xiaomiao321/taideng/Linux/robot-sdk-source-0.3.0-complete/robot-sdk-source-0.3.0/source-sample-project/APP开发者教程_源码.md

# 面向 App 开发者的 Robot SDK 0.3.0 教程：源码接入

适用：已有或新建机器人端 Android App，希望直接引用可编辑SDK模块并完成自己的页面。学习路线：接入module → 运行自己的最小坐姿页 → 接语音/双摄/MCU → 对接你方服务器与蓝牙 → 联调验收。本文可随源码交付包独立阅读，不要求先看AAR版教程。

## 1. 先跑参考示例，再接自己的 App

解压本包 `robot-sdk-source-sample-0.3.0-project.zip`，运行 `.\gradlew.bat :robot-sdk:testDebugUnitTest :sample:assembleDebug`。这是实际编译SDK的源码工程，不是只带AAR的App源码。完整环境和板卡连接见本包 [SDK源码接入指南.md](SDK源码接入指南.md)。

本交付工程配置JDK25、AGP9.3.1、Gradle9.5.0、compileSdk37、minSdk29、targetSdk30、arm64-v8a；需NDK27.2.12479018、CMake3.22.1。AGP9工程自带Kotlin支持；现有工程使用其他AGP/Kotlin时先核对兼容性，不盲目同时添加两种Kotlin插件。正式App的targetSdk/签名/发布政策由你方决定，示例不是商店发布配置。

将交付工程中的整个 `robot-sdk/` 复制到你方工程根目录，保留模块build.gradle、consumer-rules、src/main/java、assets、cpp、Runtime和libs。不要只复制Kotlin类，不要把模型/JNI路径改回原验证工程app/。sherpa供应方实现仍为第三方AAR，本包不包含它的实现源码。

## 2. 设置源码依赖并先解决编译问题

项目 `settings.gradle.kts` 的依赖仓库和模块声明合并：

```kotlin
dependencyResolutionManagement {
    repositories {
        google()
        mavenCentral()
        maven(url = "https://jitpack.io")
    }
}
include(":robot-sdk", ":app")
```

项目需声明Android library插件，与现有application插件版本一致；本交付模板为：

```kotlin
plugins {
    id("com.android.application") version "9.3.1" apply false
    id("com.android.library") version "9.3.1" apply false
}
```

宿主 `app/build.gradle.kts` 合并：

```kotlin
android {
    compileSdk = 37
    defaultConfig {
        minSdk = 29
        ndk { abiFilters += "arm64-v8a" }
    }
}
dependencies {
    implementation(project(":robot-sdk"))
    implementation(files("../robot-sdk/libs/sherpa-onnx-v1.13.6-arm64-rknn-no-runtime.aar"))
    implementation("androidx.core:core-ktx:1.10.1")
    implementation("com.github.mik3y:usb-serial-for-android:3.11.0")
}
```

SDK的sherpa依赖是compileOnly，宿主仍需显式runtime依赖。不要同时implementation Robot SDK AAR，否则重复类；不要重命名JNI类、丢consumer规则或另带不同Runtime。调用路径应该指向实际可编辑模块，不用每改一行SDK都手工导出AAR。

先 `.\gradlew.bat :robot-sdk:testDebugUnitTest :app:assembleDebug`。日常UI/业务开发只调用公共门面，不直接操作NV12、模型引擎或串口帧。确需修改SDK时保持硬件/业务分层，并重新运行SDK测试、R8与板卡验收。

## 3. 开发分工：先把硬件当作本地服务

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

SDK 相机接口须在主线程调用，结果和状态回调也在主线程。文件、数据库、蓝牙和网络写入放后台；SDK 已做采集/推理后台处理，不要为了“异步”把相机 start/stop 搬到后台线程。

## 4. 第一个里程碑：自己的 App 显示坐姿

先只接坐姿，不接串口、蓝牙或付费搜题。下面是完整的最小 Activity：人工选择相机、预览、结构化结论、过期检测、授权及前后台释放。它无需额外 layout XML。

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

```kotlin
package com.example.robotapp

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

    private val refreshResult = object : Runnable {
        override fun run() {
            if (!foreground) return
            renderResult()
            main.postDelayed(this, 500)
        }
    }

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

    private fun hasCameraPermission() =
        checkSelfPermission(Manifest.permission.CAMERA) == PackageManager.PERMISSION_GRANTED

    private fun askCameraPermission() {
        askedPermission = true
        requestPermissions(arrayOf(Manifest.permission.CAMERA), 1001)
    }

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

    override fun onPause() {
        foreground = false
        main.removeCallbacksAndMessages(null)
        posture?.stop()
        resultText.text = "页面暂停，没有实时结论"
        super.onPause()
    }

    override fun onDestroy() {
        posture?.close()
        posture = null
        previewHost.removeAllViews()
        super.onDestroy()
    }

    private fun dp(value: Int) = (value * resources.displayMetrics.density).toInt()
}
```

宿主 manifest 注册页面；你方只有一个入口时可把下面 Activity 设为启动入口，不要同时保留两个未规划的 LAUNCHER：

```xml
<activity
    android:name="com.example.robotapp.PostureDemoActivity"
    android:exported="true">
    <intent-filter>
        <action android:name="android.intent.action.MAIN" />
        <category android:name="android.intent.category.LAUNCHER" />
    </intent-filter>
</activity>
```

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

## 5. 坐姿页面升级：分开显示状态与结果

相机状态、模型状态、业务结论应使用独立 UiState/控件，避免某个 LoadingModel/Running 回调覆盖坐姿结论。最小页面把硬件消息集中在一个 TextView，正式产品可进一步拆分。

业务主入口是 `onBusinessResult` 或 `subscribeBusiness`；不要为同一份数据重复订阅两次保存。其他组件订阅时：

```kotlin
val subscription = postureClient.subscribeBusiness { result ->
    val json = result.toJson()
    // 只更新UI/投递后台队列；不在这里同步写数据库或蓝牙。
}
// 组件销毁时取消；不要积累旧页面监听器。
subscription.close()
```

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

## 6. 加入常开 USB 语音：临时文字和最终语句分两条链路

先申请 RECORD_AUDIO，再启用已加载的模型。下面的字段和初始化逻辑加入你的页面所有者；`partialText/finalText/audioStateText` 是你方 TextView：

```kotlin
import com.example.rk3566hardwarevalidator.hardware.speech.*

private var speech: StreamingSpeechRecognizer? = null
private var speechReady = false

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

private fun maybeStartSpeech() {
    val granted = checkSelfPermission(Manifest.permission.RECORD_AUDIO) ==
        PackageManager.PERMISSION_GRANTED
    val client = speech ?: return
    if (foreground && speechReady && granted && !client.isRecording) client.start()
}
```

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

临时文字持续覆盖一个“正在说话”区域；最终片段才加入对话/记录列表。不要对临时文字直接下发电机动作，不要把所有最终语句自动当作用户授权。录音止停后不应沿用旧的“监听中”标志；回前台也不自动恢复上一条运动。

## 7. 两颗摄像头：设置页确认角色，拍题页拿自己的画面

用同一 CameraRoleRegistry 管理两个角色。先停止/释放受影响 client，再真正重新枚举与 refresh，随后让用户核对取景并 bind。正常页面刷新数据不能每秒调用 registry.refresh，它会清除人工会话绑定。

```kotlin
val questionBinding = registry.bind(CameraRole.QUESTION, userConfirmedQuestionId)
val postureBinding = registry.resolve(CameraRole.POSTURE)
val usable = questionBinding.status == CameraRoleStatus.BOUND ||
    questionBinding.status == CameraRoleStatus.SESSION_BOUND
if (usable && questionBinding.cameraId != postureBinding.cameraId) {
    val question = QuestionCameraClient(
        context = this,
        config = CameraSessionConfig(
            cameraId = questionBinding.cameraId,
            analysisEnabled = false
        ),
        onEvent = { event -> /* 更新拍题相机状态；断开后停用并重新确认 */ }
    )
    questionPreviewHost.addView(question.previewView)
    // 由所有者保存question；CAMERA授权且页面/功能前台后：
    question.start()
}
```

上段 `registry` 是管理两角色的同一实例；`userConfirmedQuestionId` 必须来自当前枚举。只有一颗相机时，这个教程不同时启用坐姿和拍题；可在测试设置中先解绑坐姿，再人工改绑拍题验证截图，不能声称验证了双路并发。

Camera2 ID、VID/PID、相同能力指纹不是跨重启物理身份。默认每次冷启动/重新枚举重新确认；想自动匹配需板厂/宿主实现并验证 CameraIdentityProvider，配 SharedPreferencesCameraRoleBindingStore 保存可靠 stableKey。两相机缺身份时不能靠猜测保证不反。

等 PreviewStarted 或 isPreviewActive 后再允许拍照：

```kotlin
import com.example.rk3566hardwarevalidator.hardware.photo.PhotoCropRegion

captureButton.setOnClickListener {
    if (!question.isPreviewActive) {
        photoMessage.text = "拍题镜头尚未就绪"
        return@setOnClickListener
    }
    captureButton.isEnabled = false
    question.capturePhoto(PhotoCropRegion.FULL_FRAME) { outcome ->
        captureButton.isEnabled = true
        outcome.onSuccess { jpeg ->
            // 后台保存/显示/上传；JPEG未叠加骨架或取题框。
        }.onFailure { error ->
            photoMessage.text = "拍照失败：" + error.message
            // 不展示上一次照片为“本次拍照成功”。
        }
    }
}
```

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

`captureAnnotatedBitmap` 只供坐姿诊断，可能不是同一推理帧，不能作为搜题上传照片。Bitmap 更新展示或页面销毁时按所有权释放，勿把同一 Bitmap 回收后继续给 ImageView 用。

## 8. 搜题服务器：先展示截图，再由用户提交

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

```kotlin
import com.example.rk3566hardwarevalidator.hardware.photo.*

val search = PhotoSearchClient(this) { state ->
    when (state) {
        PhotoSearchState.Idle -> { /* 清理忙碌状态 */ }
        is PhotoSearchState.Uploading -> { /* 显示上传中 */ }
        PhotoSearchState.Solving -> { /* 显示等待服务器 */ }
        is PhotoSearchState.Success -> {
            val answer = state.solution.answer
            val steps = state.solution.steps
            // 将题目、答案、步骤和warning映射至App页面。
        }
        is PhotoSearchState.Error -> { /* 显示state.message，允许重新提交 */ }
    }
}
// readyJpegFile是App已在后台写好的非空JPEG文件。
// serverEndpoint是你方配置的服务地址，并非模型厂商带key的URL。
// 只在用户明确点击提交后调用；false表示忙碌或已关闭。
submitPhotoButton.setOnClickListener {
    val accepted = search.solve(readyJpegFile, serverEndpoint)
    if (!accepted) { /* 不重复显示为已上传 */ }
}
```

离开当前拍题流程调用 cancel，最终所有者销毁调用 close。取消不保证已发生的服务器请求或计费撤销。把 JPEG 写文件放后台，并用 App 的页面会话/请求代次阻止离开页面后的旧文件任务触发新上传；onResume不能自动重传旧题。

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

```json
{"success":true,"question":"题目正文","answer":"答案","steps":["步骤一"],"knowledge_points":["知识点"],"warning":""}
```

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

## 9. MCU 页面：先显示真实状态，再提交操作

导入 com.example.rk3566hardwarevalidator.hardware.mcu.*。以下初始化在页面所有者中只执行一次，TextView/按钮是 App 自己的控件。默认 LEGACY_V2 不开放模式/关节等扩展：

```kotlin
import com.example.rk3566hardwarevalidator.hardware.mcu.*

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

fun maySubmitNormalCommand() = mcuConnected && pendingCommandIds.isEmpty() &&
    !mcu.isStatusStale() && latestFaultFlags == 0

fun remember(submission: McuCommandSubmission) {
    if (submission.accepted) pendingCommandIds.add(submission.commandId)
    else commandLabel.text = "未受理：${submission.outcome}"
}
applyLightButton.setOnClickListener {
    if (!maySubmitNormalCommand()) {
        commandLabel.text = "未连接/处理中/状态过期或故障，不能提交"
        return@setOnClickListener
    }
    remember(mcu.setLight(true, brightnessSlider.progress))
}
offButton.setOnClickListener {
    if (maySubmitNormalCommand()) remember(mcu.setLight(false, 0))
}
stopButton.isEnabled = true
stopButton.setOnClickListener { remember(mcu.stopMotion()) }
refreshSerialButton.setOnClickListener { mcu.refreshDevices() }
```

上段是接线片段，正式页面必须补充控制门控：普通控件要求已连接、没有冲突的待完成命令、状态未过期且faultFlags=0；不能在点亮按钮时立即把实际亮度改成目标。回读设置开关/滑条时用 applyingActualStatus 阻止监听器再次发控制命令；亮度拖动结束或经节流后才提交，不每个像素都写串口。

片段已在提交入口检查门控；正式UI还应定时按同样条件刷新按钮可用状态。灯光关闭是否作为故障下的特例须按双方安全合同设计，不能因本例普通按钮被禁用就阻塞STOP。

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

accepted是SDK受理；ACK_RECEIVED只是MCU接收；APPLIED要求新的关联、无故障、匹配目标的实际状态。即使APPLIED，也不是独立传感器认证。App按 commandId 关联控件/操作，别只用8位sequence当长期身份；TIMEOUT/STATE_TIMEOUT/STALE_STATUS等都要显示并停止等待，禁止UI猜成功。

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

PC Host与板卡 Host不能用普通一根USB线直接模拟串口对端。协议模拟需USB转TTL/匹配电平的UART或CDC Device；注意TX/RX/GND与TTL/RS232不可混用，按硬件设计确认。mcu-tools是软件模拟夹具，不能代替真实固件安全验收。

## 10. 蓝牙只做数据交接：传输层属于你方 App

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

你方可定义异步队列接口，例如：

```kotlin
interface RobotDataSink {
    // 约定此方法只入有界队列，不同步阻塞SDK回调。
    fun enqueue(type: String, payload: String)
}
val subscription = postureClient.subscribeBusiness { result ->
    sink.enqueue("POSTURE", result.toJson())
}
// 在onFinalTranscript中：sink.enqueue("SPEECH_FINAL", result.toJson())
// 销毁订阅所有者：subscription.close()
```

传输层另定设备/会话身份、schema兼容、发送频率、MTU分包、消息ID、校验、断线缓存、重传和隐私授权。持续坐姿数据可做采样/状态变化聚合，不无限积累每帧；语音最终片段与临时文字分开。App自己的学生/任务ID不要塞进SDK硬件层。

手机控制消息必须先完成鉴权、用户意图和动作白名单校验，再调用mcu操作并回传commandId关联结果；不能接到一个未经校验的蓝牙包就透传运动字节。

## 11. 页面生命周期检查表

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

最小Activity采用“页面不可见即停止”的策略。若正式产品要常驻后台/跨页面长期采集，需要你方另行设计平台服务、权限与单一资源所有权并验收，不直接删掉所有stop/close。

## 12. App开发者的验收顺序与排错

按里程碑交付，避免把所有硬件/云端故障混在一起：

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

无线ADB配对/连接端口不同，重启可能变；使用板卡当前值，不把文档中的历史IP当固定配置：

```powershell
$device = '板卡IP:当前连接端口'
adb connect $device
adb devices -l
adb -s $device install -r '自己的APK路径'
adb -s $device logcat -d -s AndroidRuntime:E CameraService:E Camera3-Device:E McuSerial:I StreamingSpeech:I
```

APK安装不是固件烧写；屏幕/系统镜像遵循板厂SOP。本SDK目标RK3566/Android11/arm64，不承诺别的SoC/HAL/Android或16KB页面环境开箱即用。

## 13. 交给双方联调前填写的信息

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

交付SampleActivity是可运行参考，不是你方产品UI。关键路径索引：

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

本教程新增的是接入教学，不变更SDK/API/APK版本。只有一路摄像头的板卡测试不能证明双路并发；编译通过也不能代替真人坐姿/语音准确率和真实MCU实物验收。
