xiaomiao321/taideng/Linux/robot-sdk-aar-0.3.0-complete/robot-sdk-aar-0.3.0/aar-sample-project/APP团队首轮交付说明_0.3.0.md

# App团队首轮集成交付说明：Robot SDK 0.3.0

交付资料修订：2026-10-03 D1。SDK和两款示例版本均为0.3.0，示例versionCode=3；主验证App源码版本为1.3.1。本文用于首轮集成、分工和验收讨论，资料更新不改变二进制版本。

已确认：先按原生Android准备；我方将提供同款RK3566板卡、摄像头和USB麦克风。团队最终语言、摄像头数量/型号、MCU配置与产品后台运行策略需在收件时确认。

## 1. 首轮目标

App团队在自己的机器人端APK中引用SDK，在交付板卡上完成预览、坐姿数据展示、USB语音数据展示、权限及前后台生命周期。双方用同一套实际状态和错误语义联调；后续产品页面、蓝牙/服务器业务和新增硬件沿用这条接口边界。

SDK为本地Android Library，由你方最终APK运行。我方负责采集/模型/串口协议与接口问题；你方负责正式页面、交互、权限流程、身份/历史记录、数据传输及服务端业务。家长端手机App通过你方蓝牙/网络链路接收数据，不直接运行RK3566 SDK。

## 2. 收到后先看哪些文件

1. 本交付说明：确认范围、硬件条件和首轮验收。
2. 本包APP开发者教程：按依赖→自己的最小坐姿Activity→语音→拍题/MCU的顺序开发。
3. 本包SDK接入指南：查依赖、公共接口、权限、无线ADB和安装细节。
4. SDK数据与蓝牙对接.md：落实字段、时间戳、有效期与传输责任。
5. SDK0.3.0验证记录.md：了解已实际检查的内容；硬件控制另读两份MCU协议。

| 接入方式 | 交付目录 | 主要文件 | 教程 |
| --- | --- | --- | --- |
| 二进制AAR | robot-sdk-aar-0.3.0 | robot-sdk-0.3.0.aar、sherpa依赖AAR、示例APK、aar-sample-project及工程ZIP | APP开发者教程_AAR.md |
| 可编辑SDK源码 | robot-sdk-source-0.3.0 | source-sample-project内SDK/模型/JNI/Runtime、sherpa依赖AAR、源码示例APK及工程ZIP | APP开发者教程_源码.md |

两种方式使用同一组SDK接口。建议首次集成从AAR与参考示例开始；选择源码接入的团队也可直接运行源码示例。自己的APK只选一种Robot SDK依赖方式，sherpa语音AAR仍为必需的第三方依赖。源码方式的第三方sherpa实现源码不包含在本次交付中。

每包SHA256.txt覆盖目录内交付文件。示例APK用于验证；安装自己的APK后，注意包名、版本和相机/麦克风资源所有者。测试时只把一款相关App置于前台。

## 3. 能力范围与当前验证程度

| 能力 | 首轮提供 | 已有证据 / 联调条件 |
| --- | --- | --- |
| 坐姿相机与数据 | 指定相机、实时预览、关键点、坐姿业务快照、动态阈值、状态/错误 | 单摄实机预览/结果刷新及相机重试已检查；真人准确率、安装角度和阈值需现场标定 |
| 坐姿结论 | 高低肩、低头、疑似驼背；逐项可判定性和连续异常时长 | 无人/不可判定不会作为正常；识别效果不以编译/模型初始化代替验收 |
| USB语音 | 输入/电平/模型状态、临时文字和最终语句、JSON | USB输入和模型初始化已检查；实际终句、噪声和准确率需按现场语料验收 |
| 拍题相机 | 独立预览、未标注JPEG、相对预览区域裁剪 | 单相机改绑拍题后的截图已检查；独立双摄并发需两路硬件/HAL验证 |
| 搜题服务调用 | 可选PhotoSearchClient上传/结果/取消接口 | 两款SDK示例只做本地截图；正式服务器、鉴权、网络和照片留存由App/服务端团队对接 |
| MCU基础控制 | 灯光开关/亮度、宏观运动/STOP、状态查询与追踪 | 协议和模拟测试已准备；真实固件、USB-UART及机构状态回读需共同联调 |
| MCU扩展 | 模式、关节位置/HOME、灯路、蜂鸣器、指示灯、软关机接口与规范 | 默认关闭；提供经验证的固件能力描述后启用，仍需真实动作验收 |
| 双摄身份 | 角色注册、冲突/缺失状态、可靠身份provider扩展点 | 默认人工确认；相同型号无可靠身份时不能自动保证跨重启匹配 |
| 蓝牙 | 可消费的数据对象/JSON和本地操作接口 | App团队实现蓝牙连接、分包、授权、同步和设备绑定 |

RK3566姿态与语音共享单核NPU；预处理、UI、录音等仍占用CPU。正式两摄+语音并发负载和长时间稳定性需要在最终配置上测量。

Wi-Fi设置、OTA、账号/学生/任务、历史统计与正式业务UI由App团队提供；主验证App中已有相关参考实现。SDK示例以能力接入为主，正式App可重新设计页面。

## 4. 硬件与构建基线

运行目标：RK3566、Android11/API30、arm64-v8a；已验证组合为RKNN Runtime2.3.2、板载RKNPU驱动0.8.8。最后一次记录的板卡显示为600×1024竖屏。供给App团队的固件、显示配置和外设应与双方确认的实机一致。

示例构建配置：JDK25、AGP9.3.1、Gradle9.5.0、compileSdk37、minSdk29、targetSdk30。源码接入另需NDK27.2.12479018、CMake3.22.1。示例build环境不要求你方盲目重构已有工程；收到你方AGP/Kotlin/界面技术栈后核对兼容性。

随板卡交接时共同记录：

| 项目 | 收件时填写 |
| --- | --- |
| 板卡型号、Android固件版本/构建号 | 待记录 |
| 显示尺寸、旋转和触摸配置 | 待记录 |
| 摄像头数量、型号、坐姿/拍题用途及安装方向 | 待记录；单摄验证与双摄并发分开登记 |
| USB麦克风/音响型号与输入输出端点 | 待记录；音响是否提供另确认 |
| USB-UART型号、MCU固件版本与能力描述 | 若首轮提供MCU则填写，否则标为本轮未提供 |
| 网络/无线ADB连接方法 | 记录方法与当前值；端口会变化，不把历史端口写死进App |
| App语言、AGP/Kotlin版本、Views/Compose或跨平台 | 暂按原生Android，最终由App团队确认 |

没有MCU时仍可完成预览、识别数据和页面集成；运动/实际回读项目记录为“待硬件”，不推测成功。有一颗摄像头时先确认坐姿角色测试，再停止/解绑并人工改绑拍题角色测试，不同时占用同一相机。

## 5. 首轮采用的公共接口与语义

| 模块 | App调用 | App消费 |
| --- | --- | --- |
| 版本/设备诊断 | RobotSdkInfo、RobotDeviceInfo.capture | SDK/系统/权限/USB元数据；Bluetooth flag只代表系统声明 |
| 角色设置 | CameraInventory.enumerate、CameraRoleRegistry.refresh/bind/resolve/unbind | BOUND/SESSION_BOUND/UNBOUND/MISSING/AMBIGUOUS/CONFLICT |
| 坐姿 | PostureRecognitionClient.start/stop/close、setThresholds | onBusinessResult或subscribeBusiness、latestBusinessSnapshot；onObservation用于关键点诊断 |
| 拍题 | QuestionCameraClient.start/stop/close、capturePhoto | CameraEvent、isPreviewActive、JPEG成功/失败 |
| 语音 | StreamingSpeechRecognizer.start/stop/close | SpeechRecognitionState、onFinalTranscript |
| 基础串口 | McuSerialController.start/refreshDevices/setLight/setMotion/stopMotion/pause/close | 连接、实际状态、McuCommandSubmission及onCommandResult |
| 扩展串口 | 按已验证capability开放；requestExtendedStatus查询 | 扩展状态与关节快照、UNKNOWN/陈旧状态 |
| 搜题 | PhotoSearchClient.solve/cancel/close | 是否受理及PhotoSearchState |

坐姿业务状态为NO_PERSON、INSUFFICIENT_KEYPOINTS、OBSERVING、PARTIAL、NORMAL、ABNORMAL。先检查快照CURRENT，再显示结论；EXPIRED/UNAVAILABLE清除实时结论。连续异常时长不是历史累计；sequence不是跨实例/重启全局ID。完整JSON字段与时钟语义以SDK数据与蓝牙对接.md为准，当前schemaVersion=1。

语音Listening.transcript用于持续刷新临时文字；onFinalTranscript用于最终片段。App按自身业务确认用户意图后再触发控制，不把临时转写直接变成运动命令。

串口accepted为SDK受理，ACK_RECEIVED为MCU接收，APPLIED需新的关联实际状态匹配目标；App按commandId跟踪。故障/过期/超时/断线应显示明确失败或不可用。STOP独立于普通按钮的忙碌门控；MCU仍负责本地限位和失联停止。

相机调用及SDK回调使用主线程；App文件/数据库/蓝牙/网络写入使用后台工作队列。App保持一个清晰的采集所有者，前台就绪后start，退后台先清前台标志，再MCU pause、相机/语音stop，最终销毁close和取消订阅。

终端App持续前台时可保持语音开启。产品若要求跨页面/后台持续采集，应明确上层所有者与Android运行策略，再验收资源与权限；首轮教程采用页面前台生命周期。

坐姿提示音由App按持续异常和冷却策略控制。JPEG来自预览尺寸，正式拍题图不带骨架/取题框；高分辨率拍照、自动透视矫正和安装方向适配需按实际产品要求另测。

## 6. 第一轮双方验收表

“待执行”是App团队集成后的任务，不替代我方已有验证，也不代表今天重新做过实机测试。双方逐项填写通过/失败/待硬件与证据；不预设每天完成的时限。

| ID | 验收项 | 通过标准 | 初始状态 |
| --- | --- | --- | --- |
| A01 | 自己的APK构建和安装 | 明确包名/SDK版本；依赖、模型/JNI正确，板卡冷启动成功 | 待执行 |
| A02 | 权限与拒绝恢复 | CAMERA/录音/USB各自处理；拒绝有明确状态及重试入口 | 待执行 |
| A03 | 相机角色与首帧 | 人工确认/可靠身份后预览；未就绪禁拍，同ID双角色拒绝 | 待执行 |
| A04 | 坐姿业务UI | 无人/不足/观察/部分/正常/异常显示正确，过期清除；结果持续刷新 | 待执行 |
| A05 | 生命周期 | 前后台、页面重建和十次受控重试无重复采集/旧成功回调；可恢复 | 待执行 |
| A06 | USB语音UI | 临时文本覆盖、最终片段单独追加；新语句持续刷新，断开有错误状态 | 待执行 |
| A07 | 本地拍题JPEG | 指定拍题镜头、有效尺寸、裁剪与展示一致；本轮可先不接云端 | 待执行 |
| A08 | MCU基础链路 | 已提供硬件时验证STOP、灯光、ACK/实际状态、失败/超时及退后台行为 | 待硬件/固件确认 |
| A09 | 双摄并发/身份 | 两路不同，相机交换/重启/拔插状态明确，正确恢复角色和画面 | 待双摄配置确认 |
| A10 | 真人/语音效果与组合负载 | 按约定安装角度/语料/时长记录误报、识别结果、CPU/NPU与稳定性 | 待确定测试条件 |

首轮接入完成以A01—A07和现场具备条件的其他项目共同验收为准。真人准确率、双摄并发、真实MCU动作及产品服务验收分别登记，不用“模型已加载”替代。

## 7. 问题反馈格式

每次反馈包含：问题ID、SDK/App版本、AAR或源码接入、板卡固件/ABI/驱动、外设型号与数量、复现步骤、预期/实际表现、对应角色与状态、时间范围及脱敏日志。控制问题附commandId、受理/ACK/实际回读或超时结果；相机问题附枚举列表和角色绑定状态。

建议先由App团队用自己的APK复现，再在同一板卡用交付示例复测：两者都出现时共同排SDK/硬件；仅宿主出现时先核对接入、权限、生命周期和依赖。测试时避免两款App争用相机/麦克风。

图片、转写或用户信息只按双方确认的调试方式提供；反馈中不带API密钥。

## 8. 基线管理与交付前收尾

2026-10-03只读核对结果：两套目录校验通过；当前SDK实现、测试、模型和JNI与源码交付对应的41个文件一致，已生成Robot SDK AAR与交付AAR一致。既有44项SDK/11项模拟测试、板卡/R8记录日期为2026-09-26；本次资料整理未重新执行板卡验收。

仓库当前最新提交为9b2ffaa（主App v1.3.0），SDK及大量相关改动尚在工作区，现有Git标签到v1.3.0。App团队当前应以校验后的交付工程作为集成基线；通过Git获取时需先建立包含SDK的提交与对应版本标记，不能把旧main/tag视为本SDK基线。

送出前收尾：记录硬件清单；确认App语言与构建环境；建立Git源码基线；双方确认验收范围与问题归属；整理第三方运行库/模型来源和版本材料。ASR随包MODEL_SOURCE.md已记录来源与转换信息，商业使用条款的确认状态由项目方记录，本文不替代供应方授权材料。

修改接口/行为/模型或二进制时发布新的SDK版本与验证记录。仅文档更新记录资料修订，并更新ZIP与SHA；收件方记录实际收到的SHA，避免将后续重新生成的同名包混入已验收基线。

## 9. 可转给App团队的交付消息

现提供Robot SDK 0.3.0首轮集成包，包含AAR和可编辑源码两种方式、两款参考示例、开发者教程、接入部署指南、数据说明、串口协议及验证记录，并安排同款RK3566板卡、摄像头和USB麦克风用于联调。请先按原生Android在自己的APK完成坐姿预览/业务状态、USB语音显示及权限/生命周期接入，按本说明反馈构建环境与A01—A07结果。双摄、MCU实物和正式服务器/蓝牙链路按现场硬件及双方接口约定继续联调。请先阅读本说明，再阅读所选接入方式的APP开发者教程。
