xiaomiao321/taideng/MCU/hardware/PCB/Gerber视图.png

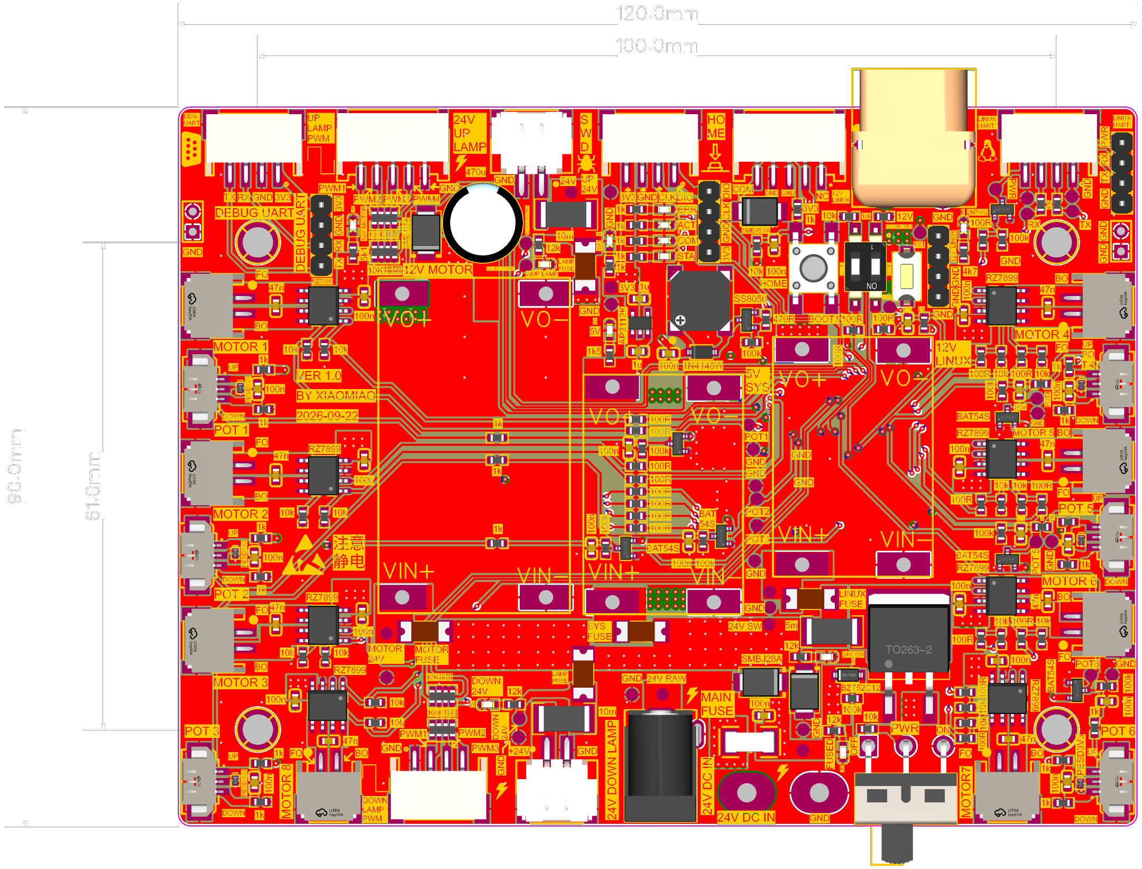
MCU/hardware/PCB/Gerber视图.png
