xiaomiao321/taideng/MCU/hardware/PCB/GND层走线.png

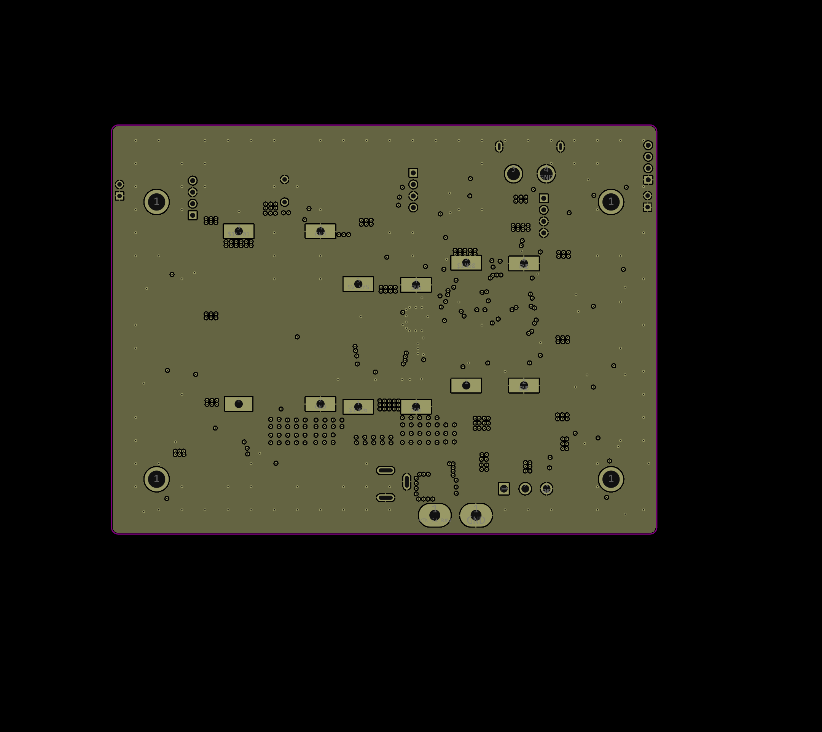
MCU/hardware/PCB/GND层走线.png
