xiaomiao321/taideng/MCU/hardware/PCB/VCC层走线.png

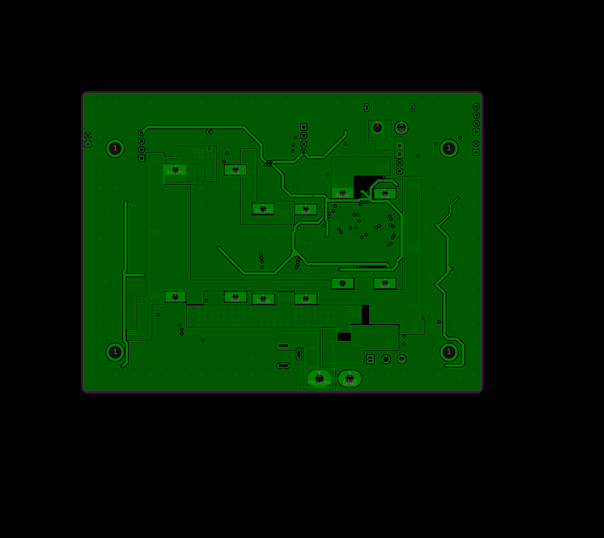
MCU/hardware/PCB/VCC层走线.png
