xiaomiao321/taideng/MCU/hardware/PCB/底层_2D.png

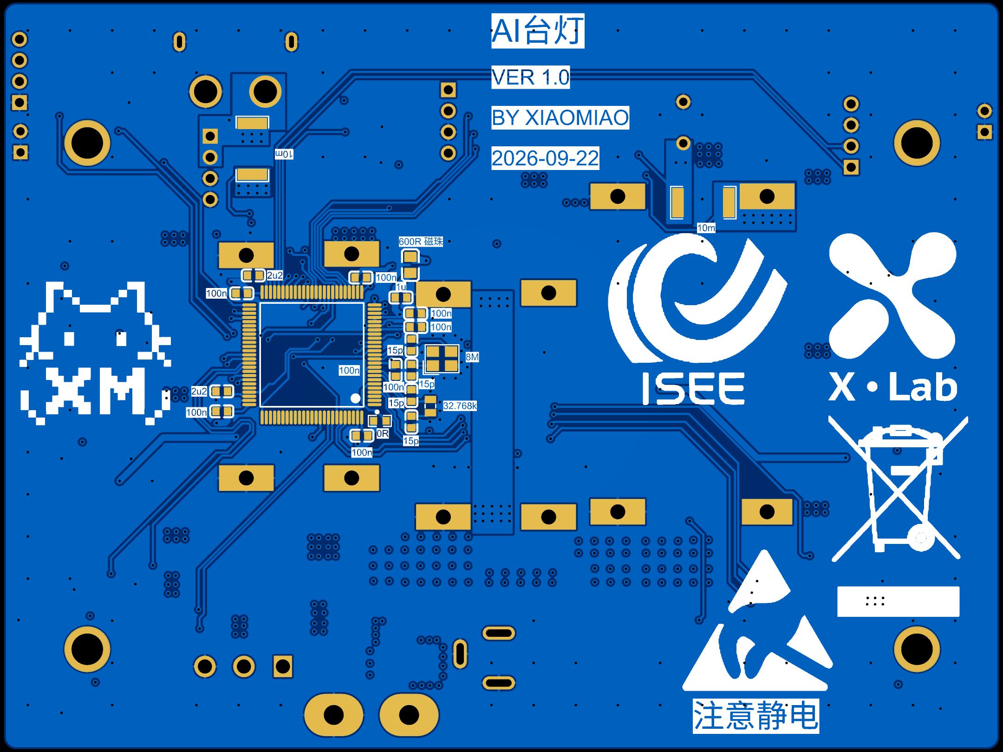
MCU/hardware/PCB/底层_2D.png
