xiaomiao321/taideng/MCU/hardware/PCB/底层走线.png

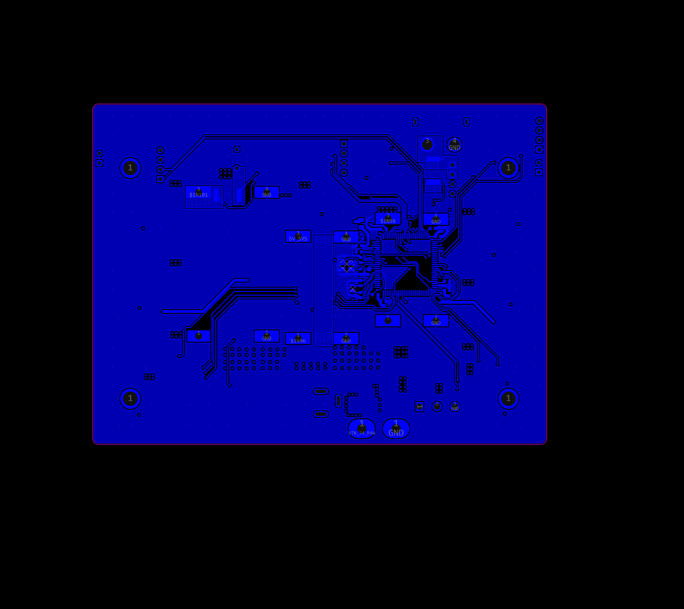
MCU/hardware/PCB/底层走线.png
