xiaomiao321/taideng/MCU/hardware/PCB/爆炸图.png

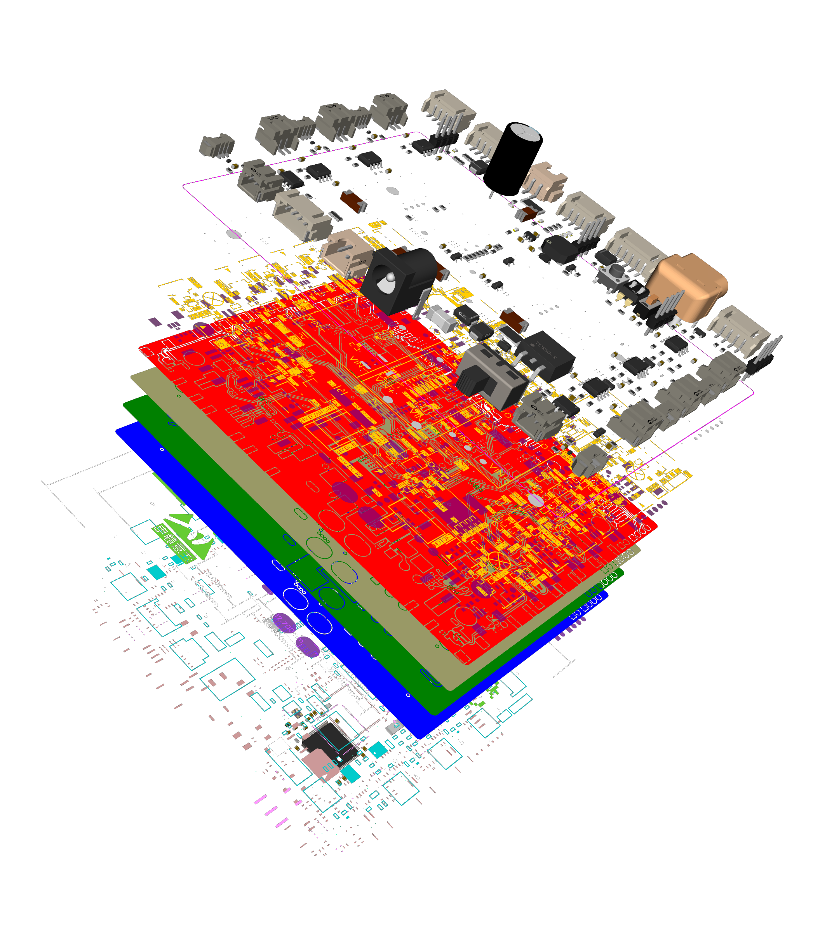
MCU/hardware/PCB/爆炸图.png
