xiaomiao321/taideng/MCU/hardware/PCB/顶层_2D.png

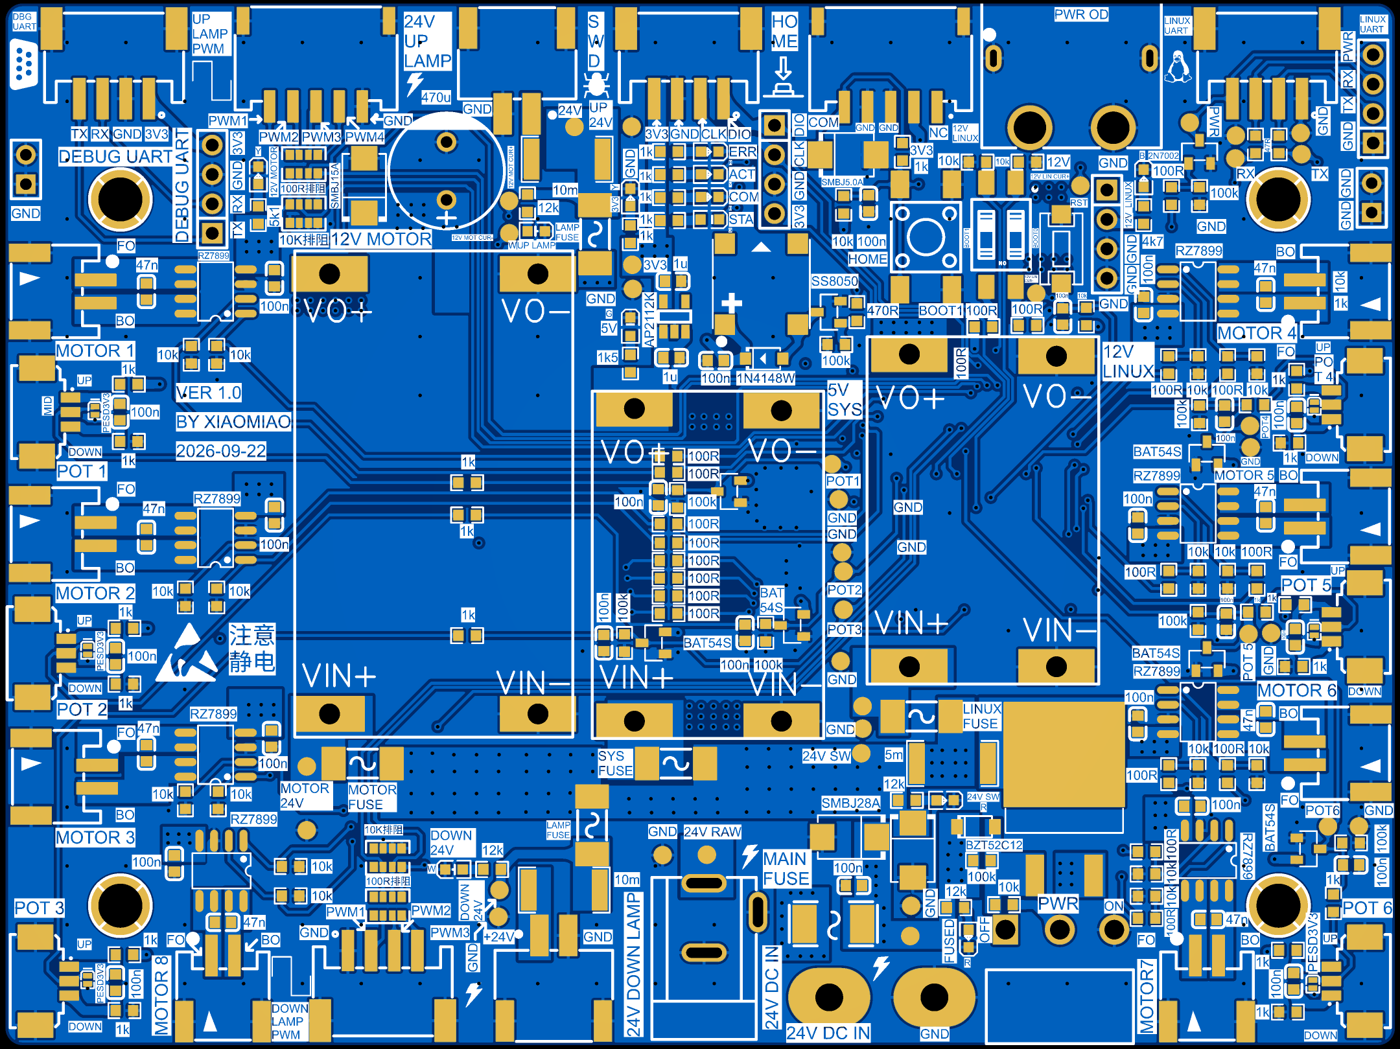
MCU/hardware/PCB/顶层_2D.png
