xiaomiao321/taideng/MCU/hardware/PCB/顶层走线.png

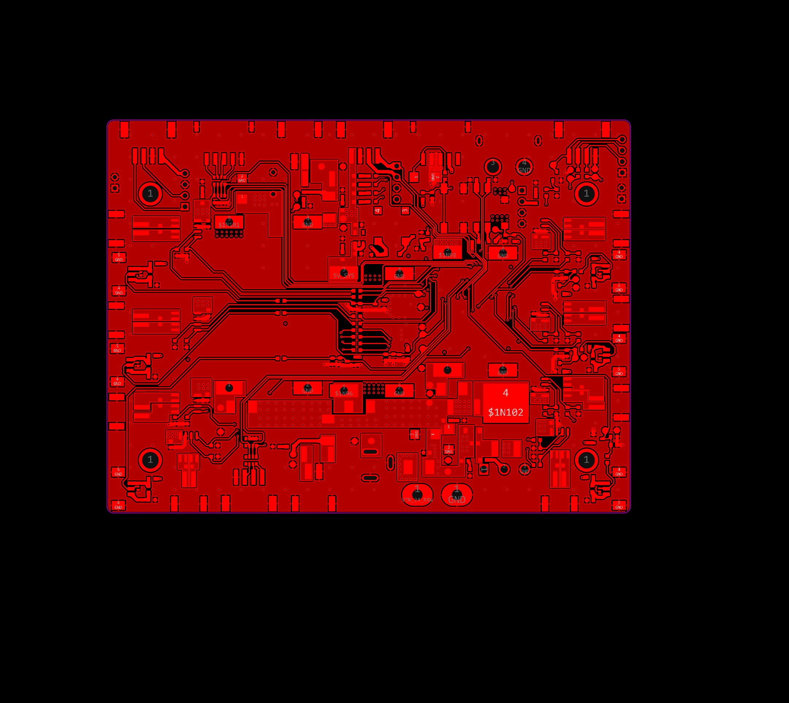
MCU/hardware/PCB/顶层走线.png
