xiaomiao321/taideng/MCU/hardware/引脚位置_镜像_v2.png

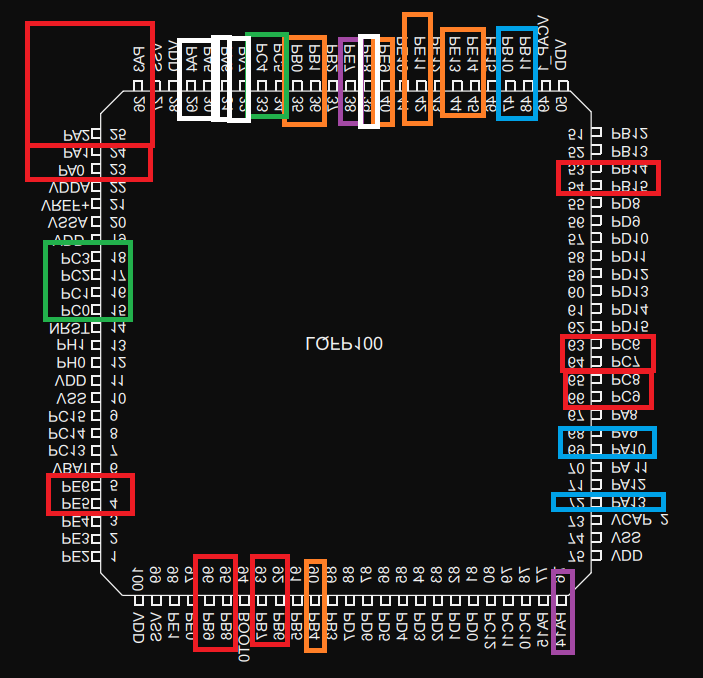
MCU/hardware/引脚位置_镜像_v2.png
