xiaomiao321/taideng/MCU/按键.png

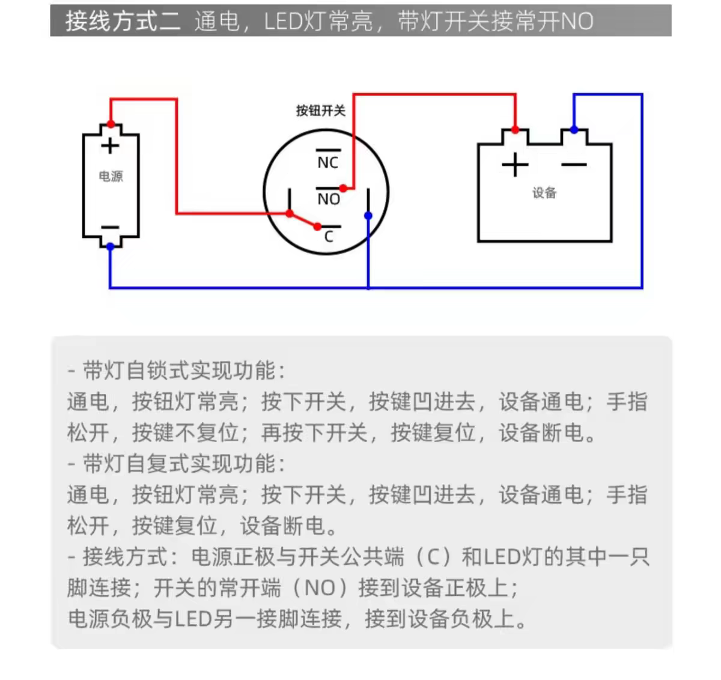
MCU/按键.png
