xiaomiao321/taideng/Power/board/3D.png

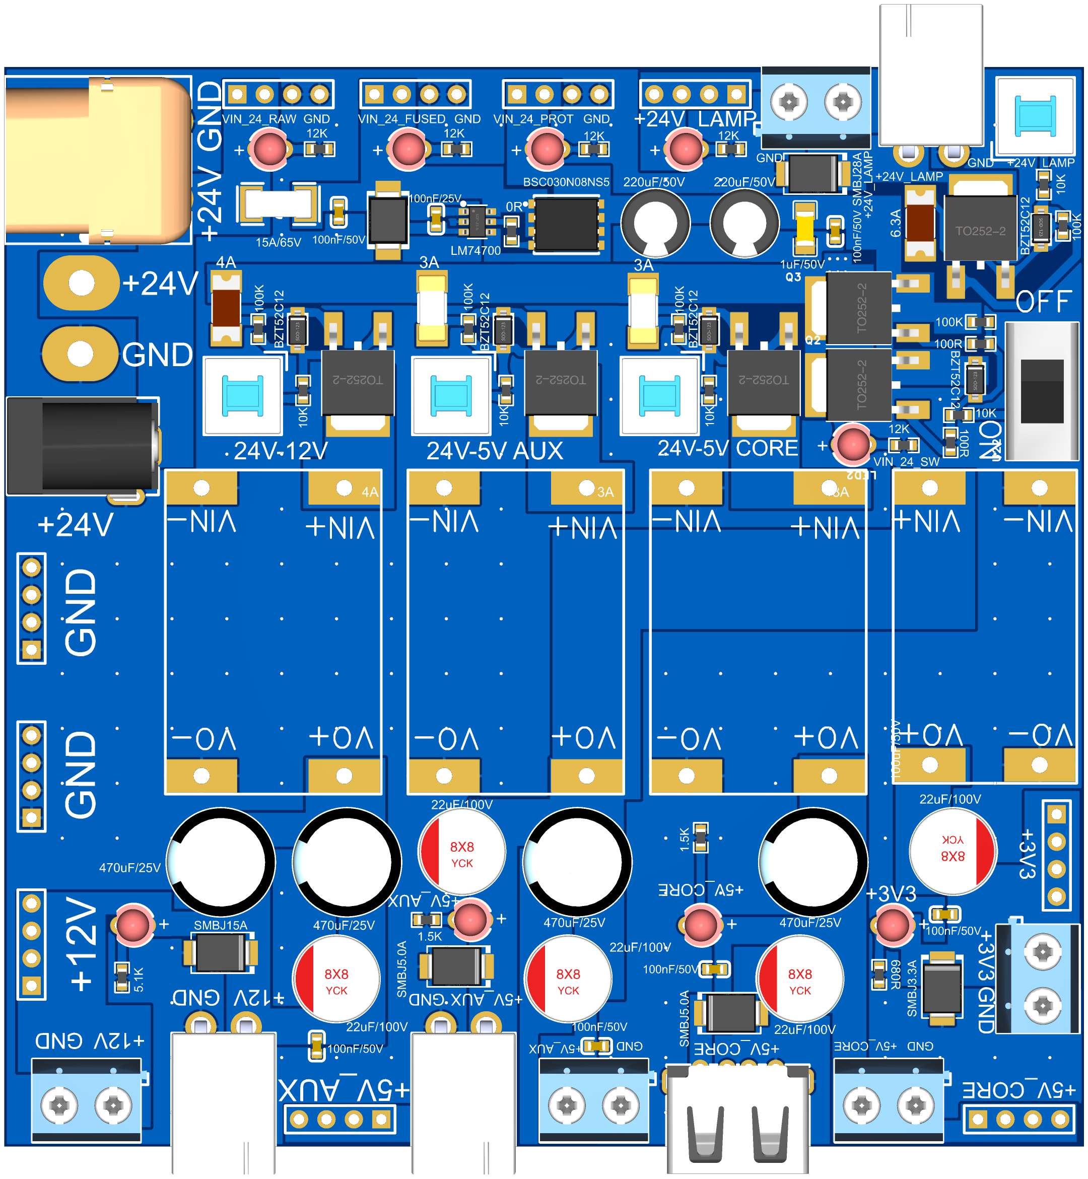
Power/board/3D.png
