xiaomiao321/taideng/Power/board/底层.png

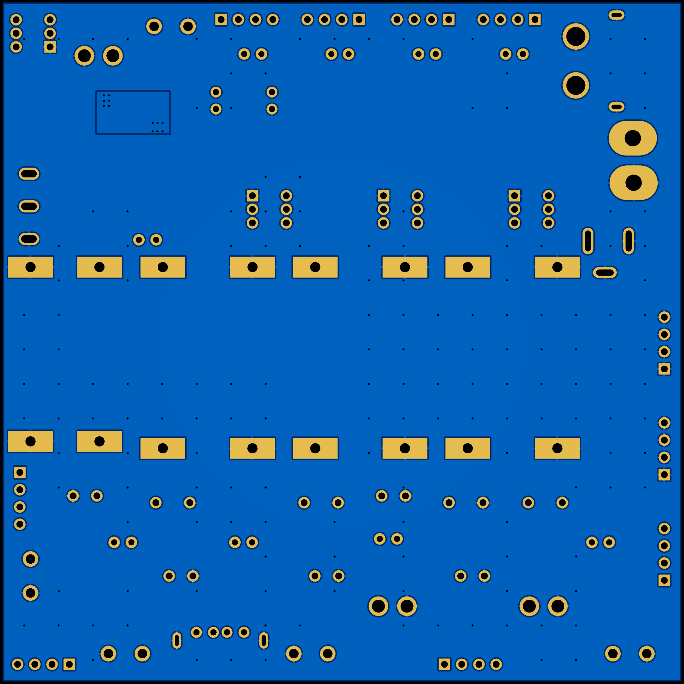
Power/board/底层.png
