xiaomiao321/taideng/Power/board/顶层.png

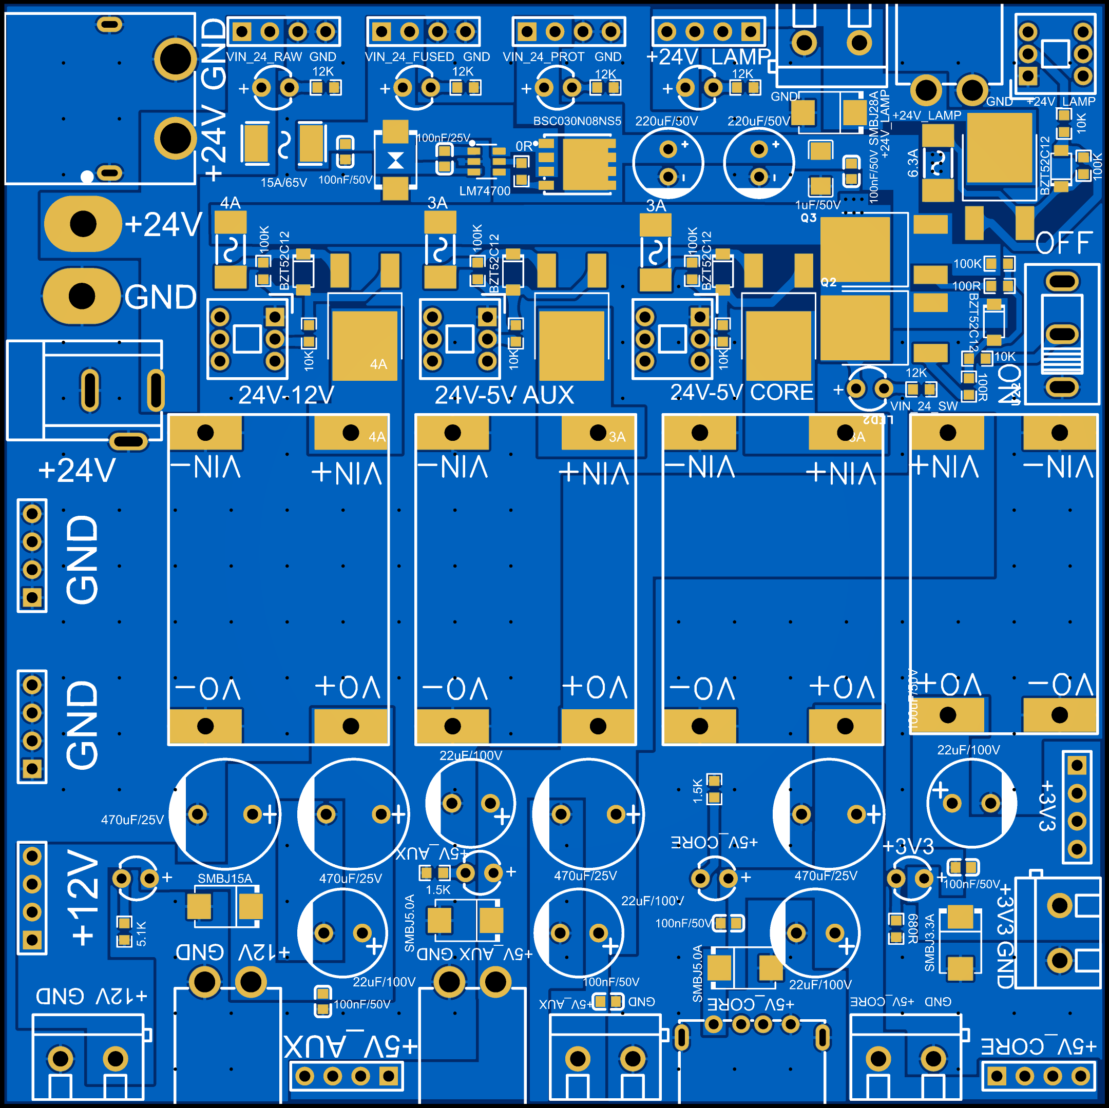
Power/board/顶层.png
