xiaomiao321/taideng/MCU/全部BOM.md

# 台灯全部 BOM（主控 PCB + 整机采购件）

> 整理日期：2026-09-23
>
> 数据来源：
> - 主控 PCB 元器件：`BOM.xlsx`（嘉立创 EDA 导出，`BOM_Board1_PCB1_2026-09-23`，71 行有效料行），单价为立创商城 1 起订量报价，未含税费、贴片费和运费。
> - 外购模块与整机件：本项目采购清单（淘宝/立创实付价）。
> - 位号已与 `网表.tel` 逐条比对：274 个位号一一对应，无缺漏、无多余。
> - 板上电源模块 U19/U20/U21 与 U11/U12、测试点 TP 等无立创报价，金额在“外购件”或“待补报价”中体现。
> - 旧采购清单价格（如 MCU 25.5 元、蜂鸣器 0.7085 元、AP2112K 0.5628 元）与 9-23 导出价有差异，以实际下单价为准，差异见文末“价格与采购风险”。

## 一、成本汇总

| 分类 | 金额（元） | 说明 |
|---|---:|---|
| 主控 PCB 焊接元件（已报价部分） | 148.35 | 立创商城单价 × 单板用量，未含税、贴片与运费 |
| 外购模块与整机件 | 135.14 | 24V 适配器、三路降压模块、扬声器 |
| **已知合计** | **283.49** | 单台样机口径 |
| 待补报价 | 待定 | 5 颗电阻（R19/R20/R21/R22/R23）、M3 螺钉、测试点 |
| 未计入 | — | PCB 制板、钢网、SMT 贴片、线束、核心板、屏幕、电机、灯板 |

## 二、外购模块与整机件

| 序号 | 物品 | 型号/规格 | 对应板上位号 | 数量 | 单价（元） | 小计（元） | 采购链接 |
|---:|---|---|---|---:|---:|---:|---|
| 1 | 外置电源适配器 | 24V/12A（原评估 24V/8～10A 口径） | — | 1 | 71.28 | 71.28 | [淘宝](https://item.taobao.com/item.htm?id=560294256028) |
| 2 | 24V→12V 大功率降压模块 | 黑色 3520，13-35V→12V，持续 10A | U21（电机 12V） | 1 | 28.72 | 28.72 | [淘宝](https://item.taobao.com/item.htm?id=986707583884) |
| 3 | 24V→12V 降压模块 | 红色 DC2780，6-27V→12V，8A | U19（Linux/核心板 12V） | 1 | 14.78 | 14.78 | [淘宝](https://item.taobao.com/item.htm?id=959630171148) |
| 4 | 24V→5V 降压模块 | 红色 DC2780，6-27V→5V，8A | U20（5V 外设） | 1 | 14.78 | 14.78 | [淘宝](https://item.taobao.com/item.htm?id=959630171148) |
| 5 | 扬声器 | 4Ω/3W，GSPK4020057TN-4R3W | 本 PCB 无功放与音频接口 | 1 | 5.58 | 5.58 | [立创商城](https://item.szlcsc.com/3517613.html) |
| | | | | | | **135.14** | |

## 三、主控 PCB 元器件

> 以下小计均按单板用量计算，分项显示为两位小数，全部小计合计为 148.35 元。

### 3.1 主控与驱动（小计 68.45 元）

| 位号 | 型号/参数 | 封装 | 数量 | 单价（元） | 小计（元） | 用途 | 立创库存 |
|---|---|---|---:|---:|---:|---|---:|
| U7 | STM32F407VGT6 | LQFP-100 | 1 | 37.72 | 37.72 | 主 MCU，贴装于底层 | 1340 |
| U8,U9,U13,U14,U15,U16,U17,U18 | RZ7899-MS | SOIC-8 | 8 | 3.71 | 29.68 | 8 路直流电机驱动（M1～M8） | 575 |
| U23 | AP2112K-3.3TRG1 | SOT-25-5 | 1 | 1.0516 | 1.05 | 5V→3.3V/600mA LDO（3V3_MCU） | 9642 |

### 3.2 功率器件（小计 22.45 元）

| 位号 | 型号/参数 | 封装 | 数量 | 单价（元） | 小计（元） | 用途 | 立创库存 |
|---|---|---|---:|---:|---:|---|---:|
| Q2 | SQM120P06-07L_GE3 | TO-263-2 | 1 | 22.26 | 22.26 | 24V 主通路 P-MOS（反接保护/总开关） | 1539 |
| Q10 | 2N7002 | SOT-23-3 | 1 | 0.1087 | 0.11 | LINUX_PWR_PULSE 开漏驱动 MOS | 19990 |
| Q11 | SS8050 | SOT-23-3 | 1 | 0.0785 | 0.08 | 蜂鸣器驱动 NPN | 123621 |

### 3.3 二极管与保护（小计 3.84 元）

| 位号 | 型号/参数 | 封装 | 数量 | 单价（元） | 小计（元） | 用途 | 立创库存 |
|---|---|---|---:|---:|---:|---|---:|
| D1 | SMBJ28A | SMB | 1 | 0.6646 | 0.66 | 24V 输入 TVS（DC 座后） | 3583 |
| D7 | SMBJ28A | SMB | 1 | 0.2824 | 0.28 | 24V 开关后 TVS（支路保险丝前） | 5844 |
| D14 | SMBJ15A | SMB | 1 | 0.87 | 0.87 | 12V 电机母线 TVS | 3392 |
| D19 | SMBJ5.0A | SMB | 1 | 0.288 | 0.29 | 外部 HOME 信号 TVS | 10212 |
| D6 | BZT52C12 | SOD-123 | 1 | 0.1033 | 0.10 | 12V 稳压管（Q2 栅极钳位） | 111862 |
| D20 | 1N4148W | SOD-123 | 1 | 0.0425 | 0.04 | 蜂鸣器续流二极管 | 114472 |
| D12,D13,D15,D16,D17,D18 | BAT54S | SOT-23-3 | 6 | 0.0839 | 0.50 | 6 路电位器 ADC 输入钳位（PC0～PC5） | 21366 |
| D21,D22,D23,D24,D25,D26 | PESD3V3U1UL | SOD-882 | 6 | 0.1803 | 1.08 | 6 路电位器输入 ESD 保护 | 1257 |

### 3.4 电容（小计 5.47 元）

| 位号 | 型号/参数 | 封装 | 数量 | 单价（元） | 小计（元） | 用途 | 立创库存 |
|---|---|---|---:|---:|---:|---|---:|
| C1 | 470uF 电解 | 插件 D10/P5 | 1 | 2.0224 | 2.02 | 12V 电机母线储能 | 356 |
| C2,C20,C21,C22,C23,C24,C25,C27,C29,C31,C33,C35,C37,C39,C41,C42,C43,C44,C45,C46,C47,C48 | 100nF/50V X7R | 0603 | 22 | 0.0786 | 1.73 | MCU 去耦、电机驱动去耦、电位器与 ADC 滤波、HOME 滤波 | 28931 |
| C5,C6,C7,C8,C9,C10,C11,C15 | 100nF | 0603 | 8 | 0.0388 | 0.31 | MCU VDD 去耦 ×7 + NRST 滤波 | 38344 |
| C3,C4,C16,C19 | 15pF | 0603 | 4 | 0.0196 | 0.08 | 32.768kHz（C3/C4）与 8MHz（C16/C19）晶振负载电容 | 56900 |
| C12 | 1uF | 0603 | 1 | 0.1014 | 0.10 | VDDA 去耦 | 13853 |
| C13,C14 | 2.2uF | 0603 | 2 | 0.1873 | 0.37 | VCAP_1 / VCAP_2 | 24798 |
| C17 | 100nF/50V | 0603 | 1 | 0.0396 | 0.04 | 24V 输入滤波 | **0（缺货）** |
| C26,C28,C30,C32,C34,C36,C38,C40 | 47nF | 0603 | 8 | 0.0446 | 0.36 | 8 路电机输出滤波（跨电机端子） | 6701 |
| C53,C54 | 1uF | 0603 | 2 | 0.2263 | 0.45 | 5V / 3.3V 电源滤波 | 44364 |

### 3.5 电阻（小计 3.68 元，另有 5 颗待补报价）

| 位号 | 型号/参数 | 封装 | 数量 | 单价（元） | 小计（元） | 用途 | 立创库存 |
|---|---|---|---:|---:|---:|---|---:|
| R12,R32,R40,R42,R75,R79,R83,R87,R100 | 100kΩ | 0603 | 9 | 0.0145 | 0.13 | Q2/Q10/Q11 栅极或基极下拉 + 6 路 ADC 下拉 | 48177 |
| R13 | 10kΩ | 0603 | 1 | 0.011 | 0.01 | Q2 栅极分压 | 17362 |
| R19,R20 | 100R | 0603 | 2 | **待补料号** | — | BOOT0 拨码配置电阻 | — |
| R21,R22,R23 | 10K | 0603 | 3 | **待补料号** | — | BOOT0 / BOOT1(PB2) / NRST 上拉 | — |
| R24 | 0Ω | 0603 | 1 | 0.0151 | 0.02 | VBAT 接 3V3_MCU | 12362 |
| R25,R27,R33,R35,R41,R48,R50,R52,R54,R56,R58,R60,R62,R64,R66,R68,R70 | 100Ω | 0603 | 17 | 0.0124 | 0.21 | 8 路电机 PWM 串阻 ×16 + LINUX_PWR_PULSE 串阻 | 51138 |
| R26,R28,R34,R36,R43,R49,R51,R53,R55,R57,R59,R61,R63,R65,R67,R69,R71 | 10kΩ | 0603 | 17 | 0.0167 | 0.28 | 8 路电机驱动输入下拉 ×16 + HOME 上拉 | 58969 |
| R29,R30,R31,R37,R38,R39,R72,R73,R74,R76,R77,R78,R80,R81,R82,R84,R85,R86,R90,R92,R95,R96,R97,R98 | 1kΩ | 0603 | 24 | 0.0171 | 0.41 | 6 路电位器分压与串阻 ×18 + 指示灯限流、HOME 串阻 | 115721 |
| R44,R45,R46,R91 | 12kΩ | 0603 | 4 | 0.0144 | 0.06 | 24V/12V 指示灯限流（24V 开关后、上下灯板、12V 电机） | 21461 |
| R47 | 5.1kΩ | 0603 | 1 | 0.0133 | 0.01 | 12V 电机指示灯限流 | 64202 |
| R88 | 4.7kΩ | 0603 | 1 | 0.0141 | 0.01 | 12V Linux 指示灯限流 | 49192 |
| R89 | 1.5kΩ | 0603 | 1 | 0.0139 | 0.01 | 5V 电源指示灯限流 | 77853 |
| R93,R94 | 47Ω | 0603 | 2 | 0.0143 | 0.03 | Linux UART TX/RX 串阻（PA9/PA10） | 21113 |
| R99 | 470Ω | 0603 | 1 | 0.0136 | 0.01 | 蜂鸣器基极限流 | 43182 |
| R101,R102,R104,R105 | 10mΩ 1% | 2512 | 4 | 0.4512 | 1.80 | 12V Linux / 12V 电机 / 24V 上灯板 / 24V 下灯板 电流检测分流 | 1319 |
| R103 | 5mΩ 1% | 2512 | 1 | 0.4869 | 0.49 | 24V 主路电流检测分流 | 934 |
| RN1,RN2 | 100Ω 排阻 8P4R | 0603×4 | 2 | 0.0476 | 0.10 | 灯板 PWM 串阻（上灯板 4 路 + 下灯板 3 路） | 2171 |
| RN3,RN4 | 10kΩ 排阻 8P4R | 0603×4 | 2 | 0.0457 | 0.09 | 灯板 PWM 默认下拉 | 19554 |

### 3.6 电感与晶振（小计 2.81 元）

| 位号 | 型号/参数 | 封装 | 数量 | 单价（元） | 小计（元） | 用途 | 立创库存 |
|---|---|---|---:|---:|---:|---|---:|
| L1 | CBW201209U601T（600Ω@100MHz） | 0805 | 1 | 0.1253 | 0.13 | VDDA 磁珠 | 6652 |
| X1 | 32.768kHz | 2P 贴片 | 1 | 1.5759 | 1.58 | RTC 晶振 | 5757 |
| X2 | 8MHz | 4P 贴片 | 1 | 1.1111 | 1.11 | 主晶振 | 3035 |

### 3.7 连接器与接口（小计 18.40 元）

| 位号 | 型号/参数 | 封装 | 数量 | 单价（元） | 小计（元） | 用途 | 立创库存 |
|---|---|---|---:|---:|---:|---|---:|
| CN1,CN2,CN3,CN4,CN9,CN10,CN11,CN12 | PH2.0mm-2P-WT | 2P 卧贴 | 8 | 0.1558 | 1.25 | 8 路电机输出：CN9=M1、CN2=M2、CN3=M3、CN10=M4、CN11=M5、CN1=M6、CN4=M7、CN12=M8 | **12** |
| CN7,CN15 | AFC20-S05ACC-00 | 5P | 2 | 0.3674 | 0.73 | CN7=上灯板 PWM 接口、CN15=外部 HOME 输入（含 TVS） | 183 |
| DC1 | DC-005-A200 | DC 圆孔 | 1 | 0.8966 | 0.90 | 24V DC 输入座 | 14874 |
| H1,H2 | LAIL-PZ2.54-2P-L | 2.54 2P | 2 | 0.1046 | 0.21 | 接地端子（4 脚全部接 GND） | 1115 |
| U5,U10,U29,U30 | A2001WR-S-04PD01 | 4P | 4 | 2.079 | 8.32 | U5=Linux 接口（UART+电源脉冲）、U10=SWD、U29=下灯板 PWM、U30=调试 UART | 4212 |
| U6 | XT60PW-F | 2P 插件 | 1 | 3.94 | 3.94 | 24V 主电源输入座 | 3627 |
| U22,U24,U25,U26,U27,U28 | XDWF-0125WT-03P | 3P | 6 | 0.2513 | 1.51 | 6 路电位器（角度反馈）接口 | 439 |
| U31,U32 | BX-XH2.54-2PWT | 2P | 2 | 0.3741 | 0.75 | U31=上灯板 24V 输出、U32=下灯板 24V 输出（均经 10mΩ 分流） | 15542 |
| U33,U34,U35,U36 | HX PZ2.54-1x4P | 2.54 4P 排针 | 4 | 0.2003 | 0.80 | U33=调试 UART、U34=12V Linux、U35=SWD、U36=Linux UART | 27893 |

### 3.8 指示与蜂鸣（小计 2.45 元）

| 位号 | 型号/参数 | 封装 | 数量 | 单价（元） | 小计（元） | 用途 | 立创库存 |
|---|---|---|---:|---:|---:|---|---:|
| BUZZER1 | MLT-7525（2.7kHz） | 4P 贴片 | 1 | 1.4578 | 1.46 | 蜂鸣器，Q11 驱动，PA6/TIM13_CH1 | 12011 |
| LED1,LED7,LED13 | XL-1608SURC-06（红） | 0603 | 3 | 0.0231 | 0.07 | LED1=故障灯 LED_ERR(PE7)、LED7=24V 开关后指示、LED13=24V 输入指示 | 38245 |
| LED2,LED10,LED12 | LTST-C190KSKT（黄绿） | 0603 | 3 | 0.1484 | 0.45 | LED2=动作灯 LED_ACT(PA7)、LED10=12V 电机指示、LED12=3.3V 指示 | 2900 |
| LED3,LED11 | NCD0603Y2（黄） | 0603 | 2 | 0.1197 | 0.24 | LED3=通信灯 LED_COMM(PA5)、LED11=12V Linux 指示 | 2435 |
| LED8,LED9 | GL0603UW01 | 0603 | 2 | 0.0309 | 0.06 | LED8=上灯板 24V 指示、LED9=下灯板 24V 指示 | 6175 |
| U3,U4 | PSC-1608U52GC-G4（绿） | 0603 | 2 | 0.0897 | 0.18 | U3=5V 电源指示、U4=系统状态灯 LED_STATE（PA4） | 7820 |

### 3.9 开关与按键（小计 20.81 元）

| 位号 | 型号/参数 | 封装 | 数量 | 单价（元） | 小计（元） | 用途 | 立创库存 |
|---|---|---|---:|---:|---:|---|---:|
| F5,F6,F7,F8,F9 | AF2-6.30V125TM | 2410 | 5 | 2.0975 | 10.49 | 支路保险丝 ×5（上/下灯板、Linux 12V、电机 12V、5V 模块输入） | **0（缺货）** |
| BOOT1 | DSIC02LS-P | 4P 贴片 | 1 | 4 | 4.00 | BOOT0 拨码开关（软件控制进入下载模式） | 6084 |
| RST1 | EVQPE104K | 贴片 | 1 | 2.3856 | 2.39 | 复位按键（NRST） | 1587 |
| U1 | SS-12D06-G050 | 3P 插件 | 1 | 2.2492 | 2.25 | 电源总开关 | 447 |
| U2 | AF2-15.0V065TM | 2410 | 1 | 1.5705 | 1.57 | 24V 主输入保险丝 | 384 |
| SW1 | KH-6X6X5H-STM | 4P 贴片 | 1 | 0.1153 | 0.12 | HOME 按键（PE15） | 8158 |

### 3.10 结构与测试点（PCB 内实现，无采购价）

| 位号 | 型号/参数 | 数量 | 说明 |
|---|---|---:|---|
| TP1,TP2,TP3,TP4 | M3 安装孔 | 4 | PCB 螺钉固定孔，需配 M3 螺钉 |
| TP5～TP44（36 个） | Test-Point 0.5mm | 36 | 电源轨、电流检测、UART、SWD 测试点 |
| U11,U12 | 电源焊盘 | 2 | 电源接线焊盘 |

## 四、价格与采购风险

1. **缺少立创料号/报价**：R19、R20（100R 0603）与 R21、R22、R23（10K 0603）在导出 BOM 中没有料号、价格和库存；下单前需补料号（0603、1% 或 5% 均可，按现有 0603 电阻统一）。
2. **缺货**：C17（100nF/50V 0603 车规 X7R）库存 0；F5～F9（AF2-6.30V125TM，2410）库存 0，需 5 颗，建议备替代料或改选同规格保险丝。
3. **库存余量偏紧**：CN1～CN12（PH2.0 2P）库存 12 只而单板用 8 只；RZ7899-MS 库存 575；U1 库存 447；U2 库存 384；R103 库存 934；R101 系列 1319。样机阶段可用，批量前需重新询货。
4. **新旧价差异**：STM32F407VGT6 旧采购价 25.5 元 / 导出价 37.72 元；蜂鸣器 MLT-7525 旧价 0.7085 元 / 导出价 1.4578 元；AP2112K 旧价 0.5628 元 / 导出价 1.0516 元。本表 PCB 行采用 9-23 导出价，外购模块沿用实付价。
5. **保险丝额定值需复核**：U2 主路与 F5～F9 五条支路（上灯板、下灯板、Linux 12V、电机 12V、5V 模块输入）的额定电流需与适配器 24V/12A 能力及各支路实际电流匹配后再下单。
6. **音频不在本板**：本 PCB 没有功放 IC、扬声器接口和 I2S 走线，扬声器 5.58 元仅为整机件占位，需确认音频最终由哪块板实现。
7. **降压模块为外购板卡**：U19/U20/U21 是贴在 PCB 上的成品降压模块（淘宝件），采购时注意“输出须比输入低 1V 以上、不能接感性负载”等卖家限制，电机 12V 支路已按大功率 3520 模块选型。

## 五、不在本 BOM 范围的整机模块

| 模块 | 负责方/来源 | 说明 |
|---|---|---|
| Linux 核心板（K7-S / ROCK CM3 类） | 另行采购 | 本板只提供 12V_LINUX、UART（U5/U36）、电源脉冲（U5.4）等接口 |
| 主照明灯板、履带效果灯 | 灯板负责人 | 本板提供 24V 输出（U31/U32）、上灯板 PWM（CN7）、下灯板 PWM（U29） |
| 电机与执行器本体 | 电机负责人 | 本板提供 8 路驱动（U8～U18）与 PH2.0 输出（CN1～CN12） |
| 屏幕、触摸、摄像头 | 对应负责人 | 不在本板，不由 F407 直接驱动 |
| PCB 制板、钢网、SMT 贴片、焊接、线束 | 生产 | 需按板尺寸与数量单独询价 |

## 六、与网表的一致性

- `BOM.xlsx` 的 274 个位号与 `网表.tel` 完全一致，无缺件、无多余件。
- 引脚分配与 `MCU_接口位置与引脚分配_电机顺序更新版_v2.md` 的对应关系见 2026-09-23 的核对结论：8 路电机、7 路灯板 PWM、6 路电位器 ADC、通信、指示与控制引脚在网表上全部对得上；差异仅在于网表中上灯板 PWM 网络名为 `PE9/PE11/PE13/PE14`（文档写 `UP_PWM1～4`）、电位器 ADC 网络名为 `PC0～PC5`（文档写 `POT1_ADC～POT6_ADC`），属命名口径差异，必要时在原理图中统一改名。
