xiaomiao321/taideng/MCU/hardware/BOM.xlsx

Quantity | Comment | Designator | Footprint | Value | LCSC Price | LCSC Stock
1 | DSIC02LS-P | BOOT1 | SW-SMD_4P-L5.1-W6.1-P2.54-LS9.8 |  | 4 | 6084
1 | 2.7kHz | BUZZER1 | BUZ-SMD_4P-L7.5-W7.5-P7.59-TL | 2.7kHz | 1.4578 | 12011
1 | 470uF | C1 | CAP-TH_BD10.0-P5.00-D1.0-FD-H16.0 | 470uF | 2.0224 | 356
22 | 100nF | C2,C20,C21,C22,C23,C24,C25,C27,C29,C31,C33,C35,C37,C39,C41,C42,C43,C44,C45,C46,C47,C48 | C0603 | 100nF | 0.0786 | 28931
4 | 15pF | C3,C4,C16,C19 | C0603 | 15pF | 0.0196 | 56900
8 | 100nF | C5,C6,C7,C8,C9,C10,C11,C15 | C0603 | 100nF | 0.0388 | 38344
1 | 1uF | C12 | C0603 | 1uF | 0.1014 | 13853
2 | 2.2uF | C13,C14 | C0603 | 2.2uF | 0.1873 | 24798
1 | 100nF | C17 | C0603 | 100nF | 0.0396 | 0
8 | 47nF | C26,C28,C30,C32,C34,C36,C38,C40 | C0603 | 47nF | 0.0446 | 6701
2 | 1uF | C53,C54 | C0603 | 1uF | 0.2263 | 44364
8 | PH2.0mm-2P-WT | CN1,CN2,CN3,CN4,CN9,CN10,CN11,CN12 | CONN-SMD_2P-P2.00_PH2.0-2PWT |  | 0.1558 | 12
2 | AFC20-S05ACC-00 | CN7,CN15 | CONN-SMD_AFC20-S05ACC-00 |  | 0.3674 | 183
1 | SMBJ28A | D1 | SMB_L4.6-W3.6-LS5.3-RD |  | 0.6646 | 3583
1 | BZT52C12 | D6 | SOD-123_L2.7-W1.6-LS3.7-RD |  | 0.1033 | 111862
1 | SMBJ28A | D7 | SMB_L4.6-W3.6-LS5.3-RD |  | 0.2824 | 5844
6 | BAT54S | D12,D13,D15,D16,D17,D18 | SOT-23-3_L2.9-W1.3-P1.90-LS2.4-BR |  | 0.0839 | 21366
1 | SMBJ15A | D14 | SMB_L4.6-W3.6-LS5.3-RD |  | 0.87 | 3392
1 | SMBJ5.0A | D19 | SMB_L4.6-W3.6-LS5.4-RD |  | 0.288 | 10212
1 | 1N4148W | D20 | SOD-123_L2.7-W1.6-LS3.7-FD |  | 0.0425 | 114472
6 | PESD3V3U1UL | D21,D22,D23,D24,D25,D26 | SOD-882_L1.0-W0.6-RD |  | 0.1803 | 1257
1 | DC-005-A200 | DC1 | DC-IN-TH_DC-005-A200 |  | 0.8966 | 14874
5 | AF2-6.30V125TM | F5,F6,F7,F8,F9 | FUSE-SMD_L6.1-W2.5-1 |  | 2.0975 | 0
2 | LAIL-PZ2.54-2P-L | H1,H2 | CONN-TH_LAIL-PZ2.54-2P-L |  | 0.1046 | 1115
1 | CBW201209U601T | L1 | L0805 |  | 0.1253 | 6652
3 | XL-1608SURC-06 | LED1,LED7,LED13 | LED0603-RD_RED |  | 0.0231 | 38245
3 | LTST-C190KSKT | LED2,LED10,LED12 | LED0603-RD |  | 0.1484 | 2900
2 | NCD0603Y2 | LED3,LED11 | LED0603-RD |  | 0.1197 | 2435
2 | GL0603UW01 | LED8,LED9 | LED0603-R-RD |  | 0.0309 | 6175
1 | SQM120P06-07L_GE3 | Q2 | TO-263-2_L10.1-W9.1-P5.08-LS15.2-TL-1 |  | 22.26 | 1539
1 | 2N7002 | Q10 | SOT-23-3_L2.9-W1.3-P1.90-LS2.4-BR |  | 0.1087 | 19990
1 | SS8050 | Q11 | SOT-23-3_L2.9-W1.3-P1.90-LS2.4-BR |  | 0.0785 | 123621
9 | 100kΩ | R12,R32,R40,R42,R75,R79,R83,R87,R100 | R0603 | 100kΩ | 0.0145 | 48177
1 | 10kΩ | R13 | R0603 | 10kΩ | 0.011 | 17362
2 | 100R | R19,R20 | R0603 | 100R
3 | 10K | R21,R22,R23 | R0603 | 10K
1 | 0Ω | R24 | R0603 | 0Ω | 0.0151 | 12362
17 | 100Ω | R25,R27,R33,R35,R41,R48,R50,R52,R54,R56,R58,R60,R62,R64,R66,R68,R70 | R0603 | 100Ω | 0.0124 | 51138
17 | 10kΩ | R26,R28,R34,R36,R43,R49,R51,R53,R55,R57,R59,R61,R63,R65,R67,R69,R71 | R0603 | 10kΩ | 0.0167 | 58969
24 | 1kΩ | R29,R30,R31,R37,R38,R39,R72,R73,R74,R76,R77,R78,R80,R81,R82,R84,R85,R86,R90,R92,R95,R96,R97,R98 | R0603 | 1kΩ | 0.0171 | 115721
4 | 12kΩ | R44,R45,R46,R91 | R0603 | 12kΩ | 0.0144 | 21461
1 | 5.1kΩ | R47 | R0603 | 5.1kΩ | 0.0133 | 64202
1 | 4.7kΩ | R88 | R0603 | 4.7kΩ | 0.0141 | 49192
1 | 1.5kΩ | R89 | R0603 | 1.5kΩ | 0.0139 | 77853
2 | 47Ω | R93,R94 | R0603 | 47Ω | 0.0143 | 21113
1 | 470Ω | R99 | R0603 | 470Ω | 0.0136 | 43182
4 | 10mΩ | R101,R102,R104,R105 | R2512 | 10mΩ | 0.4512 | 1319
1 | 5mΩ | R103 | R2512 | 5mΩ | 0.4869 | 934
2 | 100Ω | RN1,RN2 | RES-ARRAY-SMD_0603-8P-L3.2-W1.6-BL | 100Ω | 0.0476 | 2171
2 | 10kΩ | RN3,RN4 | RES-ARRAY-SMD_0603-8P-L3.2-W1.6-BL | 10kΩ | 0.0457 | 19554
1 | EVQPE104K | RST1 | SW-SMD_L6.0-W3.5-LS7.2 |  | 2.3856 | 1587
1 | KH-6X6X5H-STM | SW1 | SW-SMD_4P-L6.0-W6.0-P4.50-LS9.0_H5.0 |  | 0.1153 | 8158
4 | M3螺丝 | TP1,TP2,TP3,TP4 | M3螺丝
36 | Test-Point | TP5,TP6,TP7,TP8,TP9,TP10,TP11,TP12,TP13,TP14,TP15,TP16,TP17,TP18,TP19,TP20,TP21,TP23,TP24,TP25,TP26,TP27,TP28,TP29,TP30,TP31,TP32,TP33,TP35,TP36,TP38,TP39,TP40,TP42,TP43,TP44 | Test-Point-0.5mm
1 | SS-12D06-G050 | U1 | SW-TH_3P-P4.70_SS-12D06-G050 |  | 2.2492 | 447
1 | AF2-15.0V065TM | U2 | F2410 |  | 1.5705 | 384
2 | PSC-1608U52GC-G4 | U3,U4 | LED0603-RD_GREEN |  | 0.0897 | 7820
4 | A2001WR-S-04PD01 | U5,U10,U29,U30 | CONN-SMD_A2001WR-S-04PD01 |  | 2.079 | 4212
1 | XT60PW-F | U6 | TH_2P-XT60PW-F |  | 3.94 | 3627
1 | STM32F407VGT6 | U7 | LQFP-100_L14.0-W14.0-P0.50-LS16.0-BL |  | 37.72 | 1340
8 | RZ7899-MS | U8,U9,U13,U14,U15,U16,U17,U18 | SOIC-8_L4.9-W3.9-P1.27-LS6.0-BL |  | 3.71 | 575
2 | 电源焊盘 | U11,U12 | 电源焊盘封装
1 | 24V转12V | U19 | 24V降压模块封装
1 | 24V转5V | U20 | 24V降压模块封装
1 | 24V转12V | U21 | 大功率24V降压模块封装
6 | XDWF-0125WT-03P | U22,U24,U25,U26,U27,U28 | CONN-SMD_3P-P1.25_XDWF-0125WT-03P |  | 0.2513 | 439
1 | AP2112K-3.3TRG1 | U23 | SOT-25-5_L2.9-W1.6-P0.95-LS2.8-BL |  | 1.0516 | 9642
2 | BX-XH2.54-2PWT | U31,U32 | CONN-SMD_2P-P2.50_BX-XH2.54-2PWT |  | 0.3741 | 15542
4 | HX PZ2.54-1x4P ZZ | U33,U34,U35,U36 | HDR-TH_4P-P2.54-V-M |  | 0.2003 | 27893
1 | 32.768kHz | X1 | CRYSTAL-SMD_2P-L2.0-W1.2 | 32.768kHz | 1.5759 | 5757
1 | 8MHz | X2 | CRYSTAL-SMD_4P-L3.2-W2.5-BL | 8MHz | 1.1111 | 3035
