xiaomiao321/taideng/Power/board/BOM_Board1_PCB1_2026-08-31.xlsx

Quantity | Comment | Designator | Footprint | Value
4 | 470uF | C1,C2,C6,C10 | CAP-TH_BD10.0-P5.00-D1.0-FD-H16.0 | 470uF
5 | 22uF | C3,C5,C7,C11,C13 | CAP-TH_BD8.0-P3.50-D0.6-FD | 22uF
7 | 100nF | C4,C8,C12,C16,C17,C21,C22 | C0603 | 100nF
1 | 1uF | C20 | C1206 | 1uF
5 | BZT52C12 | D1,D3,D4,D5,D6 | SOD-123_L2.7-W1.6-LS3.7-RD
1 | SMBJ28CA | D2 | SMB_L4.3-W3.6-LS5.4-BI
1 | SMBJ28A | D7 | SMB_L4.6-W3.6-LS5.3-RD
1 | SMBJ15A | D8 | SMB_L4.6-W3.6-LS5.3-RD
2 | SMBJ5.0A | D9,D10 | SMB_L4.6-W3.6-LS5.3-RD
1 | DC-005-A200 | DC1 | DC-IN-TH_DC-005-A200
1 | AF2-6.30V125TM | F1 | FUSE-SMD_L6.1-W2.5-1
2 | S6125-H2-3.0A | F2,F3 | FUSE-SMD_L6.1-W2.5
10 | LAIL-PZ2.54-4P-L | H1,H2,H3,H4,H5,H6,H7,H8,H9,H10 | CONN-TH_LAIL-PZ2.54-4P-L
9 | EL304RD | LED1,LED2,LED3,LED4,LED5,LED6,LED7,LED8,LED9 | LED-TH_BD3.9-P2.54-RD_RED
1 | BSC030N08NS5 | Q1 | PG-TDSON-8_L5.0-W6.0-P1.27-BL-EP
6 | SP60P30TH | Q2,Q3,Q4,Q5,Q6,Q7 | TO-252-2_L6.6-W6.1-P4.57-LS9.9-BR-CW
5 | 10kΩ | R1,R7,R9,R11,R13 | R0603 | 10kΩ
2 | 100Ω | R2,R3 | R0603 | 100Ω
5 | 100kΩ | R4,R5,R8,R10,R12 | R0603 | 100kΩ
1 | 0Ω | R6 | R0603 | 0Ω
5 | 12kΩ | R14,R15,R16,R21,R22 | R0603 | 12kΩ
1 | 5.1kΩ | R17 | R0603 | 5.1kΩ
2 | 1.5kΩ | R18,R19 | R0603 | 1.5kΩ
1 | 680Ω | R20 | R0603 | 680Ω
4 | XKB7070-Z | SW1,SW3,SW4,SW5 | SW-TH_6P-L7.0-W7.0-P2.00
1 | SS-12D10L5 | SW2 | SW-TH_SS-12D10L5
3 | 24V转12V | U1,U4,U23 | 24V降压模块封装
1 | AF2-15.0V065TM | U2 | F2410
1 | LM74700QDBVRQ1 | U3 | SOT-23-6_L2.9-W1.6-P0.95-LS2.8-BL
1 | SMBJ3.3A | U5 | SMB_L4.6-W3.6-LS5.3-RD
1 | 5V转3V3 | U6 | 5V转3V3封装
1 | AF2-4.00V125TM | U7 | FUSE-SMD_L6.1-W2.5-1
1 | XT60PW-F | U8 | TH_2P-XT60PW-F
2 | 电源焊盘 | U9,U10 | 电源焊盘封装
1 | USB1125-GF-B | U11 | USB-A-TH_USB1125-GF-B
5 | KF301-5.0-2P | U12,U13,U14,U15,U19 | CONN-TH_P5.00_KF301-5.0-2P
3 | 5569-2AWM | U16,U17,U18 | CONN-TH_2P-P4.20_5569-2AWM
2 | 220uF | U20,U21 | CAP-TH_BD6.3-P2.50-D0.5-FD | 220uF
