xiaomiao321/taideng/MCU/hardware/3D_PCB1_2026-10-04.step

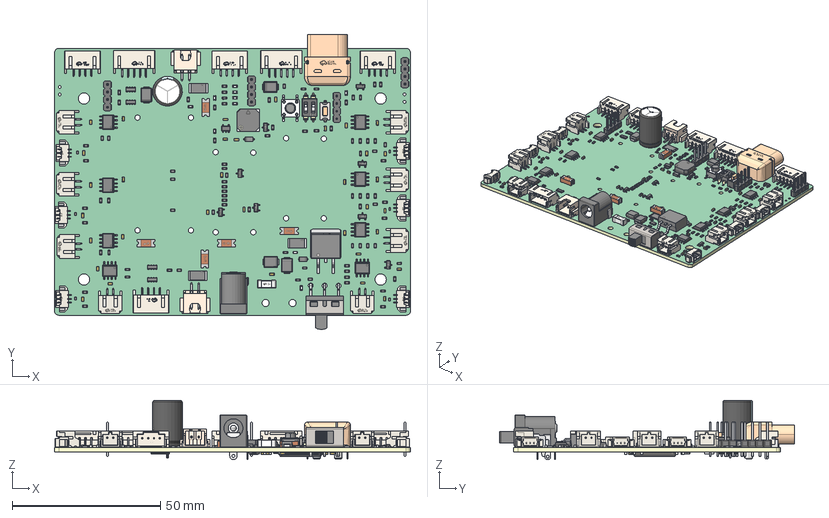
[picture p21: CAD file, 2026-10-08]
MCU/hardware/3D_PCB1_2026-10-04.step
120.0 x 99.5 x 20.0 mm
Board~c1aP
TopCopper~c1aP
BottomCopper~c1aP
TopSilkscreen~c1aP
BottomSilkscreen~c1aP
TopFpcStiffener~c1aP
BottomFpcStiffener~c1aP
L0805~R0805_L2.0-W1.3-H0.6~c1aP
TO-263-2_L10.1-W9.1-P5.08-LS15.2-TL-1~TO-263-2_ L10.2-W8.7-H4.5-LS15.2-P2.54~c1aP
LED0603-RD_GREEN~LED0603-RD_GREEN~c1aP x 2
SW-SMD_4P-L5.1-W6.1-P2.54-LS9.8~SW-SMD_ 4P-L5.1-W6.1-H4.2-P2.54-LS9.8~c1aP
SOD-123_L2.7-W1.6-LS3.7-RD~SOD-123_L2.7-W1.6-H1.4-LS3.7~c1aP
LED0603-RD~LED0603-RD~c1aP x 5
LED0603-RD_RED~LED0603-RD_RED~c1aP x 3
DC-IN-TH_DC-005-A200~DC-IN-TH_DC-005-A200~c1aP
LED0603-R-RD~LED0603-R-RD~c1aP x 2
SOIC-8_L4.9-W3.9-P1.27-LS6.0-BL~SOIC-8_L4.9-W3.9-H1.7-LS6.0-P1.27~c1aP x 8
R0603~R0603~c1aP x 84
RES-ARRAY-SMD_0603-8P-L3.2-W1.6-BL~R0603-8P_L3.2-W1.6-H0.6~c1aP x 4
SW-SMD_4P-L6.0-W6.0-P4.50-LS9.0_H5.0~SW-SMD_4P-L6.0-W6.0-P4.50-LS9.0_ H5.0~c1aP
R2512~R2512_L6.3-W3.2-H0.6~c1aP x 5
F2410~F2410_L6.2-W2.7-H2.7~c1aP
CONN-SMD_3P-P1.25_XDWF-0125WT-03P~CONN-SMD_3P-P1.25_ XDWF-0125WT-03P~c1aP x 6
SW-TH_3P-P4.70_SS-12D06-G050~SW-TH_3P-P4.70_SS-12D06-G050~c1aP
HDR-TH_4P-P2.54-V-M~HDR-TH_4P-P2.54-M-LI-1X4P~c1aP x 4
SOD-123_L2.7-W1.6-LS3.7-FD~SOD-123_L2.7-W1.6-LS3.7-FD~c1aP
CRYSTAL-SMD_4P-L3.2-W2.5-BL~CRYSTAL-SMD_4P-L3.2-W2.5-BL~c1aP
CONN-SMD_2P-P2.50_BX-XH2.54-2PWT~CONN-SMD_2P-P2.50_BX-XH2.54-2PWT~c1aP x 2
SOT-23-3_L2.9-W1.3-P1.90-LS2.4-BR~SOT-23-3P_ L2.9-W1.3-H1.0-LS2.4-P0.95~c1aP x 8
CONN-SMD_2P-P2.00_PH2.0-2PWT~CONN-SMD_2P-P2.00_PH2.0-2PWT~c1aP x 8
CONN-SMD_A2001WR-S-04PD01~CONN-SMD_PH2.00-WS-4P~c1aP x 4
SMB_L4.6-W3.6-LS5.4-RD~SMB_L4.6-W3.6-LS5.4-RD~c1aP
SOD-882_L1.0-W0.6-RD~SOD-882_L1.0-W0.6-H0.5-LS0.65~c1aP x 6
SOT-25-5_L2.9-W1.6-P0.95-LS2.8-BL~SOT-25-5_ L2.9-W1.6-P0.95-LS2.8-BL~c1aP
FUSE-SMD_L6.1-W2.5-1~FUSE-SMD_L6.1-W2.5-1~c1aP x 5
TH_2P-XT60PW-F~TH_2P-XT60PW-F~c1aP
C0603~C0603_L1.6-W0.8-H0.8~c1aP x 48
SMB_L4.6-W3.6-LS5.3-RD~SMB_L4.6-W3.6-LS5.3-RD~c1aP x 3
CAP-TH_BD10.0-P5.00-D1.0-FD-H16.0~CAP-TH_D10.0-H16.0-P5.00~c1aP
BUZ-SMD_4P-L7.5-W7.5-P7.59-TL~BUZ-SMD_4P-L7.5-W7.5-H2.5~c1aP
SW-SMD_L6.0-W3.5-LS7.2~SW-SMD_L6.0-W3.5-H5.0-P5.4-LS7.2~c1aP
CONN-SMD_AFC20-S05ACC-00~CONN-SMD_PH2.00-WS-5P~c1aP x 2
CRYSTAL-SMD_2P-L2.0-W1.2~CRYSTAL-SMD_2P-L2.0-W1.2~c1aP
LQFP-100_L14.0-W14.0-P0.50-LS16.0-BL~LQFP-100_ L14.0-W14.0-H1.4-LS16.0-P0.50~c1aP
