xiaomiao321/taideng/Power/test/电源板测试报告_2026-09-12.md

# 电源板首板测试报告

## 1. 基本信息

- 测试日期：2026-09-12
- 被测对象：24V输入多路电源板首板
- 输入电源：24V适配器
- 电子负载：RIGOL DL3021
- 示波器：RIGOL数字示波器
- 当前主要负载需求：
  - 电机：12V/5A
  - Linux开发板：改为12V供电，建议按12V/5A预留
  - 5V AUX：约2A
  - 3.3V：待进一步确认实际负载

> 本报告根据当前首板的实测数据整理。未完成或存在异常的项目均明确标为“待测”或“不通过”，不能将本报告视为整板最终验收通过证明。

## 2. 测试方法

1. 使用24V电源为电源板供电，各支路独立开启。
2. 使用DL3021恒流模式逐级增加负载。
3. 使用示波器直流耦合观察输出电压和低频变化。
4. 使用交流耦合、约5us/div及带宽限制观察开关纹波。
5. 使用测温设备观察降压模块散热片温度。
6. 出现输出反复启动、短路或散热片温度接近100℃时立即停止测试。

## 3. 12V输出测试

初始未安装输出电解电容时，12V输出存在较明显的低频波动，原始波形和测量结果如下。

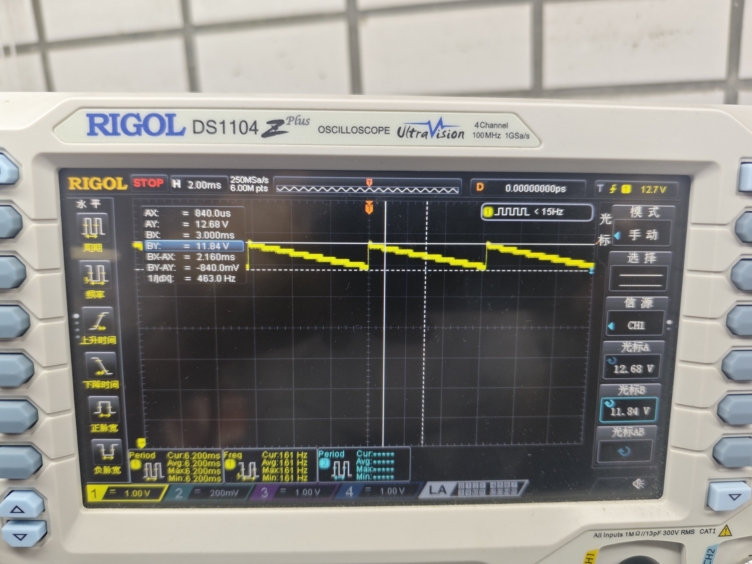
[picture p22: Power/test/12V_无输出电解_波形.jpg]
12V无输出电解电容波形


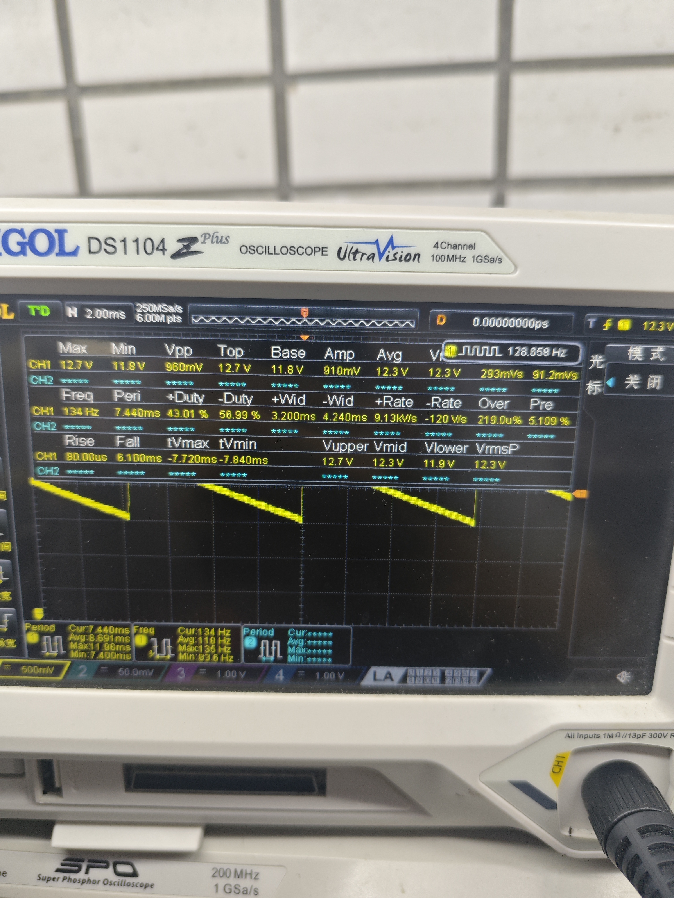
[picture p23: Power/test/12V_无输出电解_测量.jpg]
12V无输出电解电容测量数据


### 3.1 负载调整结果

| 负载电流 | 平均电压 | 最大值 | 最小值 | 示波器直流档Vpp | 备注 |
|---:|---:|---:|---:|---:|---|
| 约0.1A（120Ω） | 约12.1V | 12.3V | 11.7V | 约700mV | 可观察到间歇工作波形，约425Hz |
| 0.5A | 约11.85V | 12.284V | 11.327V | 约957mV | 模块工作频率随负载提高 |
| 1A | 11.808V | 11.997V | 11.614V | 383mV | 输出进入较稳定的连续开关状态 |
| 2A | 11.772V | 11.917V | 11.630V | 287mV | 输出稳定 |
| 3A | 11.743V | 11.917V | 11.534V | 383mV | 输出稳定 |
| 4A | 11.712V | 11.917V | 11.534V | 383mV | 输出稳定 |
| 5A | 11.673V | 11.821V | 11.534V | 287mV | 短时间内能够维持5A输出 |

从1A到5A，平均输出电压由11.808V下降至11.673V，下降约0.135V。短时间负载能力和负载调整表现可以接受。

直流档使用较大量程时，Vpp容易受垂直分辨率、采样毛刺和统计残留影响，因此不将表中的直流档Vpp作为最终纹波结论。

安装输出电容后的空载波形：

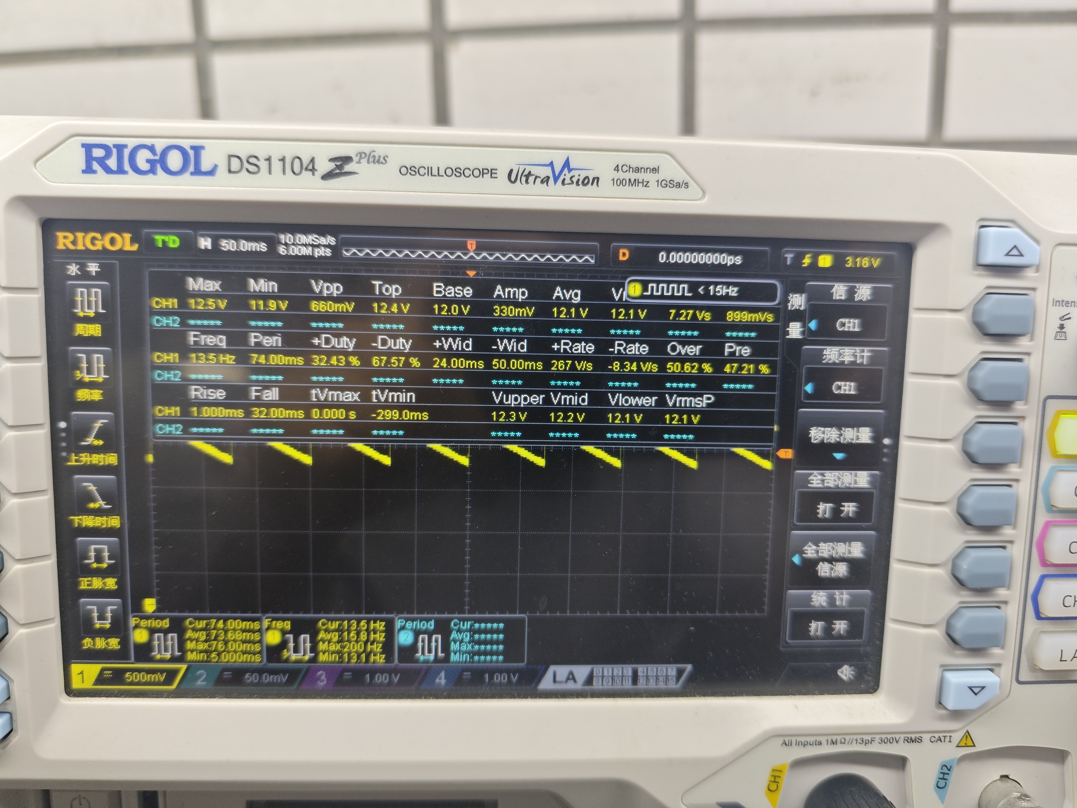
[picture p24: Power/test/12V_加输出电容_空载_DC.jpg]
安装输出电容后的12V空载直流波形


安装输出电容、接入120Ω负载（约0.1A）后的波形：

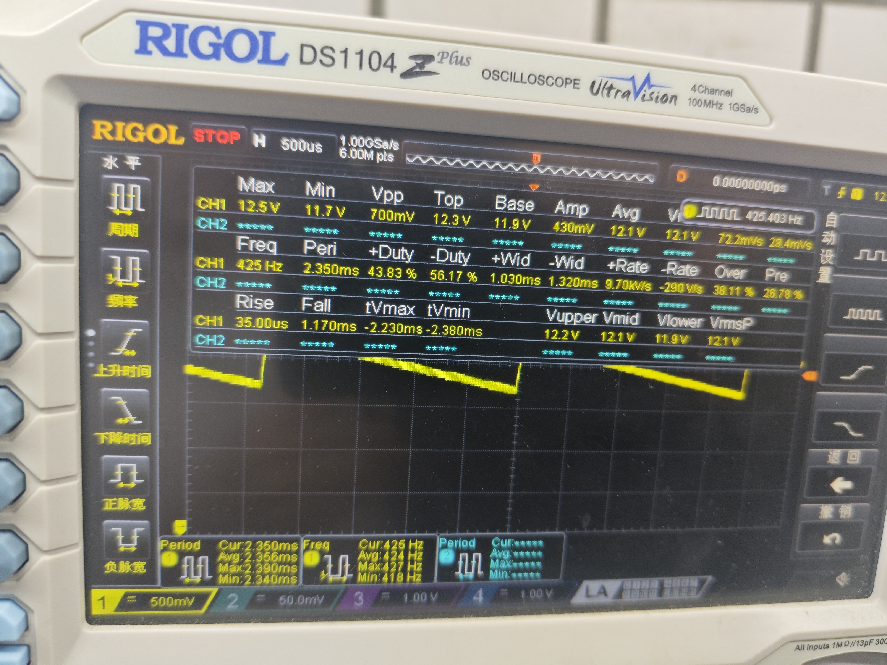
[picture p25: Power/test/12V_加输出电容_0.1A_DC.jpg]
安装输出电容后的12V约0.1A直流波形


0.5A负载波形：

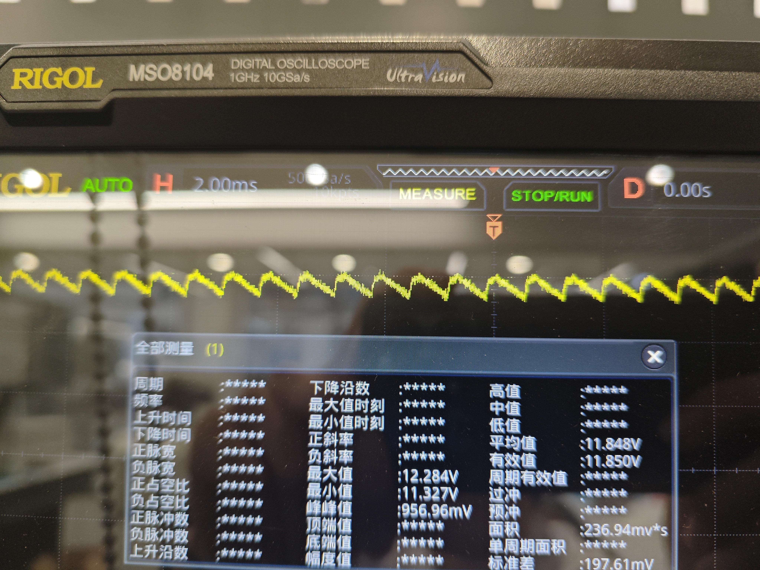
[picture p26: Power/test/12V_0.5A_DC.jpg]
12V/0.5A直流波形


1A负载下的测量统计及直流波形：

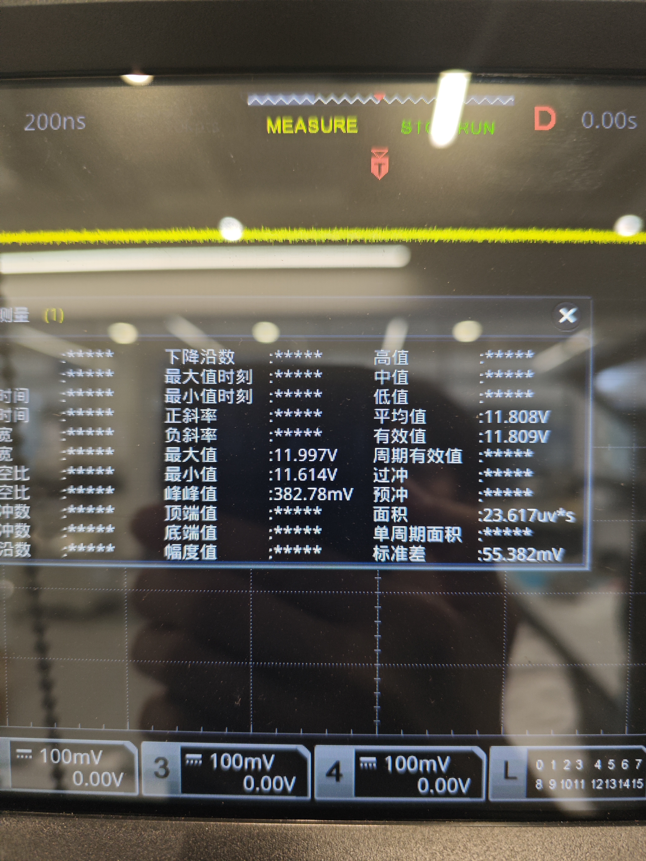
[picture p27: Power/test/12V_1A_DC_统计.jpg]
12V/1A直流测量统计


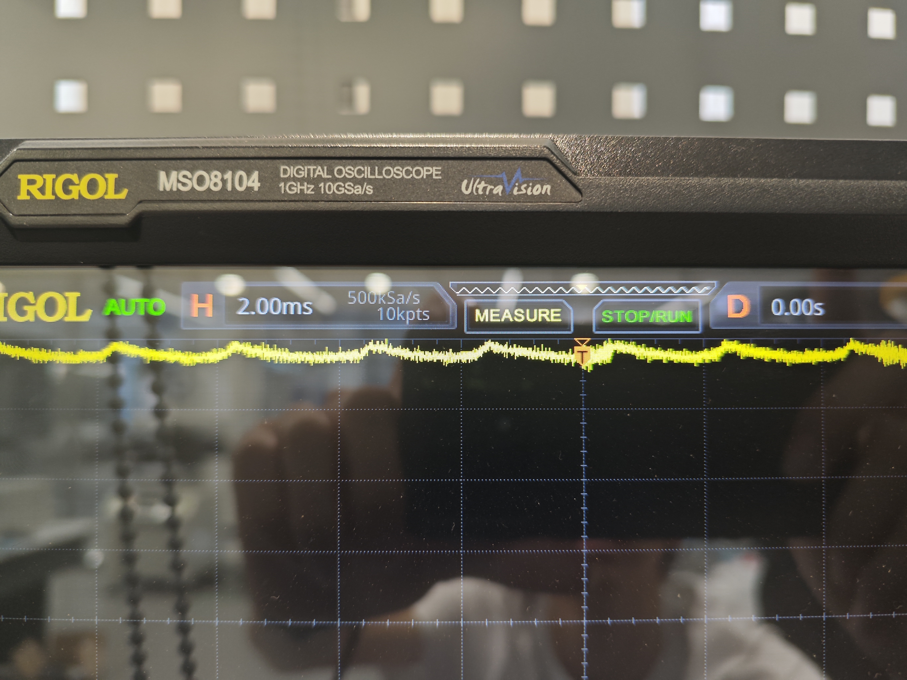
[picture p28: Power/test/12V_1A_DC_波形.jpg]
12V/1A直流波形


2A至5A负载下的直流波形：

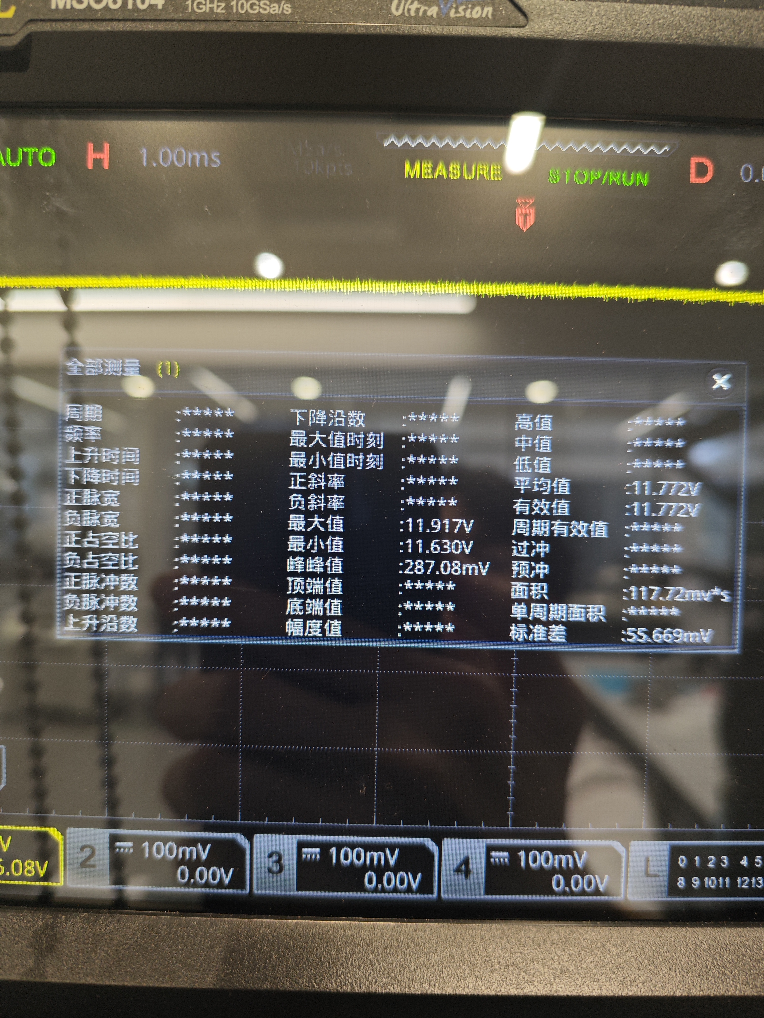
[picture p29: Power/test/12V_2A_DC.jpg]
12V/2A直流波形


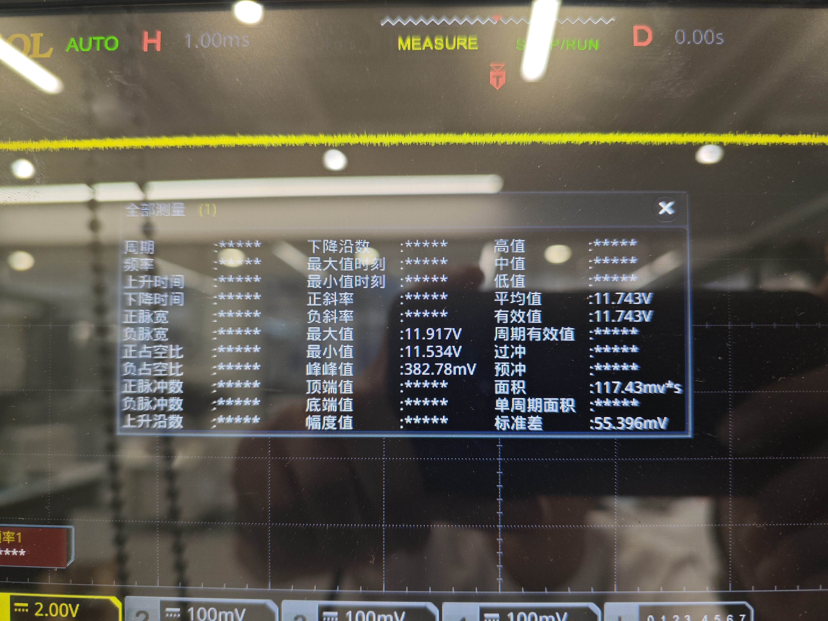
[picture p30: Power/test/12V_3A_DC.jpg]
12V/3A直流波形


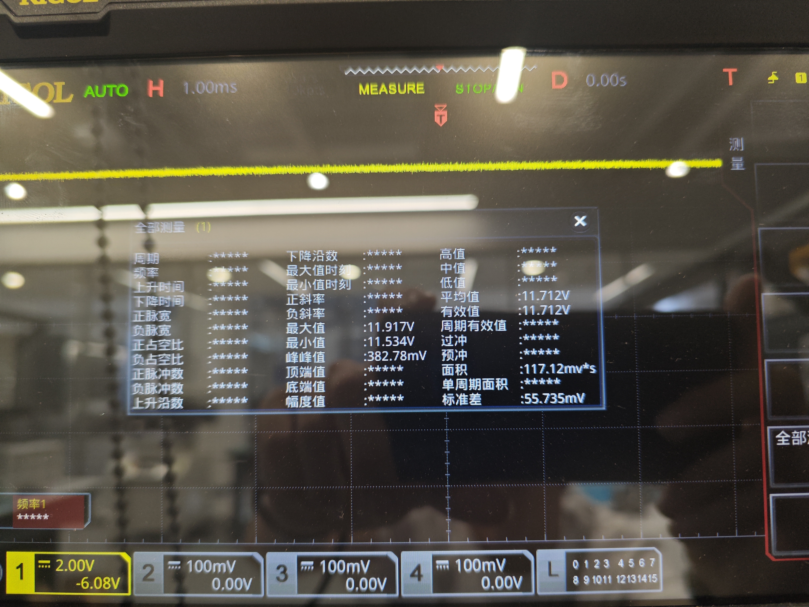
[picture p31: Power/test/12V_4A_DC.jpg]
12V/4A直流波形


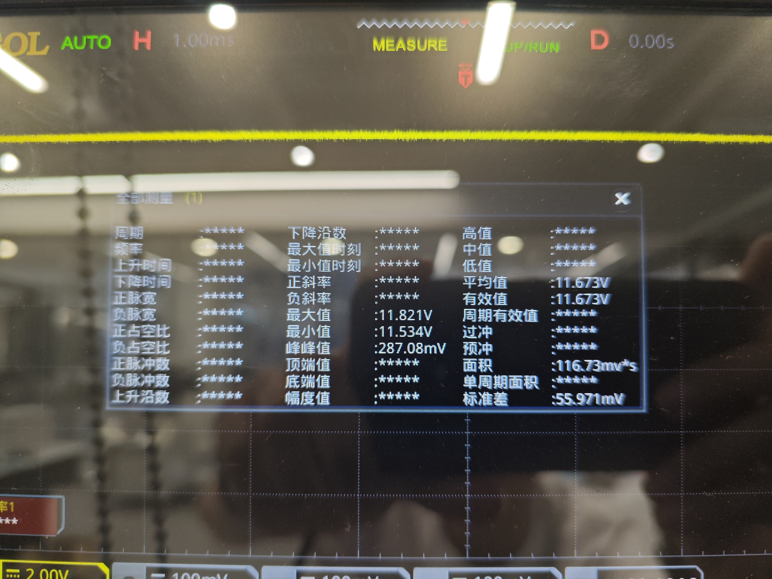
[picture p32: Power/test/12V_5A_DC.jpg]
12V/5A直流波形


### 3.2 5A交流纹波

- 平均直流输出：约11.67V
- 开关纹波频率：约181.75kHz
- 交流纹波峰峰值：约65.46mVpp
- 交流纹波有效值：约4.65mVrms
- 纹波占输出电压比例：约0.56% Vpp

1A负载下的交流纹波：

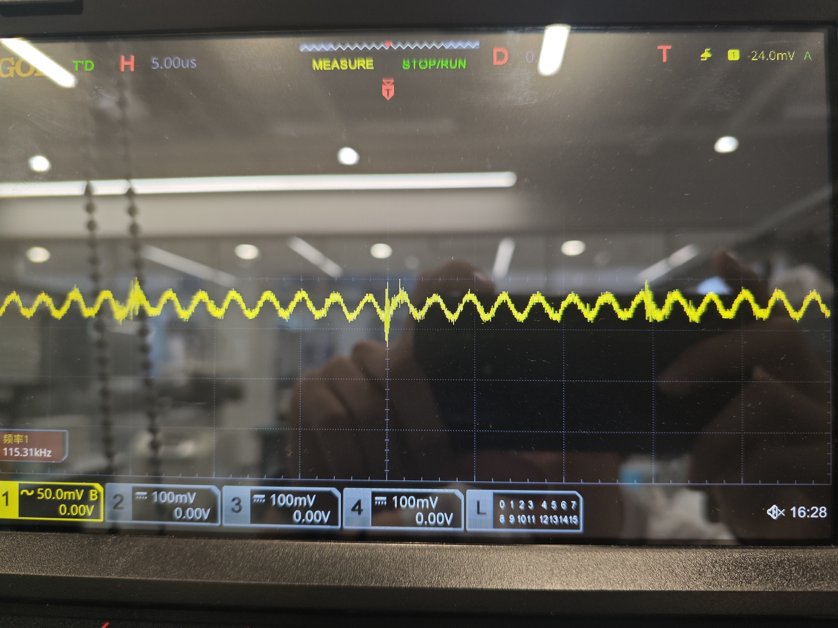
[picture p33: Power/test/12V_1A_AC_纹波.jpg]
12V/1A交流纹波


5A负载下的交流纹波：

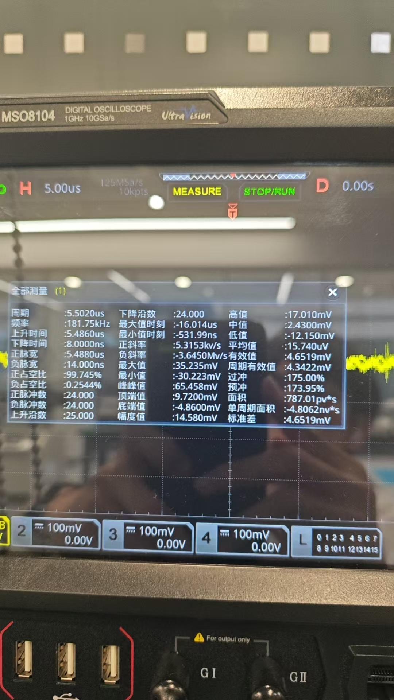
[picture p34: Power/test/12V_5A_AC_纹波.jpg]
12V/5A交流纹波


结论：12V输出在5A下的电压和交流纹波合格，未观察到明显持续低频振荡。

### 3.3 温升结果

- 5A运行时散热片温度超过80℃，随后接近100℃。
- 其他保险丝、MOS管和连接器未发现同等级异常温升。

结论：**12V模块短时间电气性能通过，但自然散热条件下连续5A热测试不通过。** 后续需要增加强制风冷、改善散热或更换连续输出能力更强的模块。在完成整改前，建议连续负载降至3～4A，5A只作为短时峰值验证。

## 4. 5V Core输出测试

未安装输出电解电容时的初始测量结果：

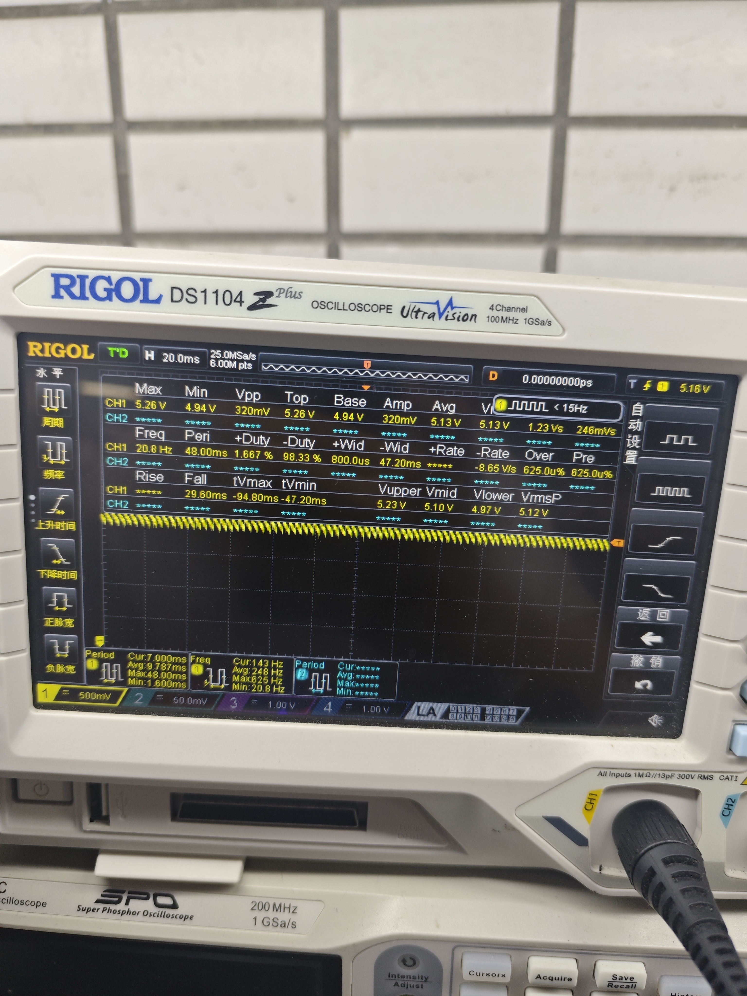
[picture p35: Power/test/5V_Core_无输出电解_测量.jpg]
5V Core无输出电解电容测量数据


### 4.1 5A电气性能

- 平均电压：4.9725V
- 最大值：5.1676V
- 最小值：4.7848V
- 直流档Vpp：约382.78mV（仅供趋势参考）
- 交流纹波频率：约86.49kHz
- 交流纹波峰峰值：约90.21mVpp
- 交流纹波有效值：约4.47mVrms

5A负载下的直流测量结果：

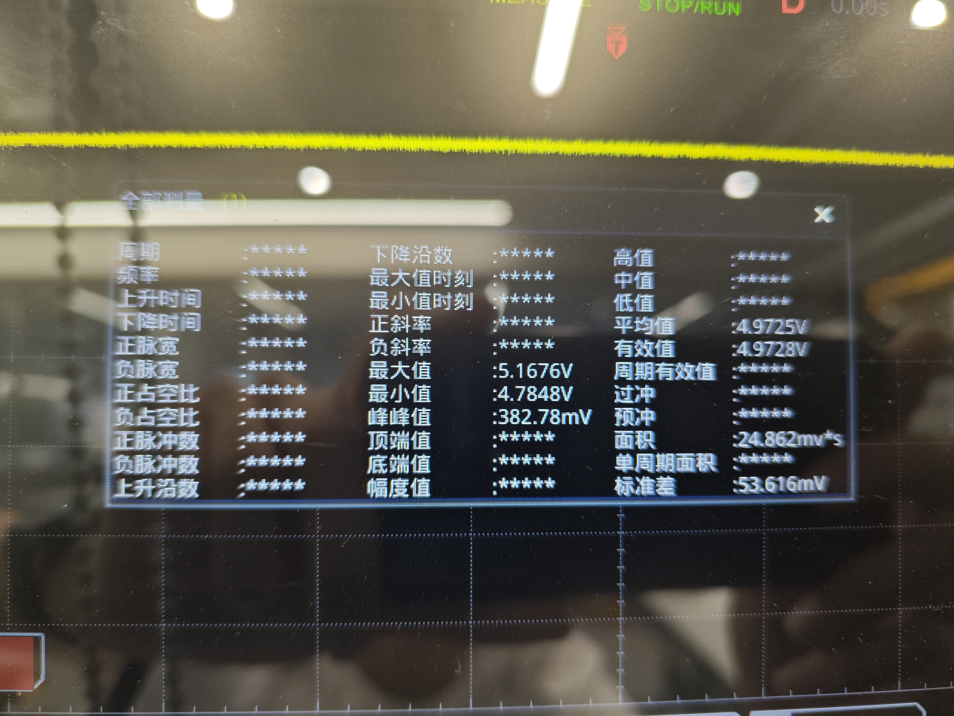
[picture p36: Power/test/5V_Core_5A_DC.jpg]
5V Core/5A直流波形


5A负载下的交流纹波：

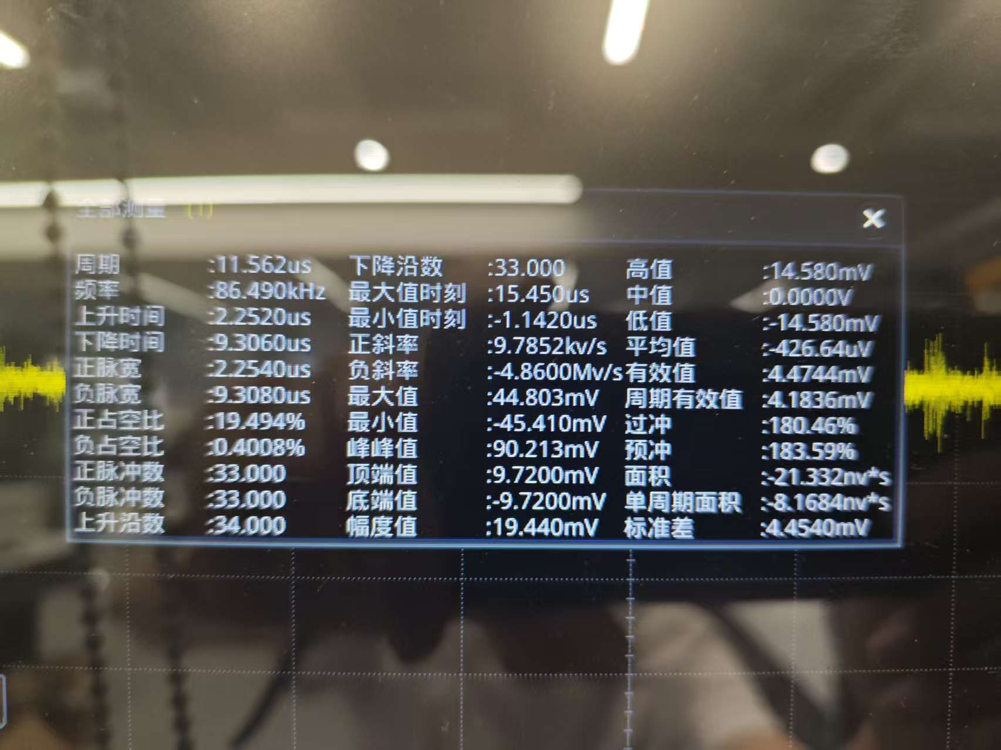
[picture p37: Power/test/5V_Core_5A_AC_纹波.jpg]
5V Core/5A交流纹波


结论：5V Core在5A短时负载下输出电压和交流纹波可以接受。

### 4.2 温升结果

- 5A运行时模块散热片温度达到约96℃。
- 将负载降为2A后，散热片温度稳定在约50℃。

结论：**5V Core短时间5A电气性能通过，但连续5A热测试不通过；2A连续温升表现正常。** 由于Linux开发板已经改为12V供电，此路可改作5V AUX使用。按当前2A目标负载，散热片稳定在约50℃，热测试通过；仍应补充记录2A下的输出电压和交流纹波，并根据3.3V支路的实际输入功耗确认2A是否包含全部AUX负载。

## 5. 原5V AUX支路异常

### 5.1 故障现象

未安装输出电解电容时，5V AUX的初始测量结果如下。

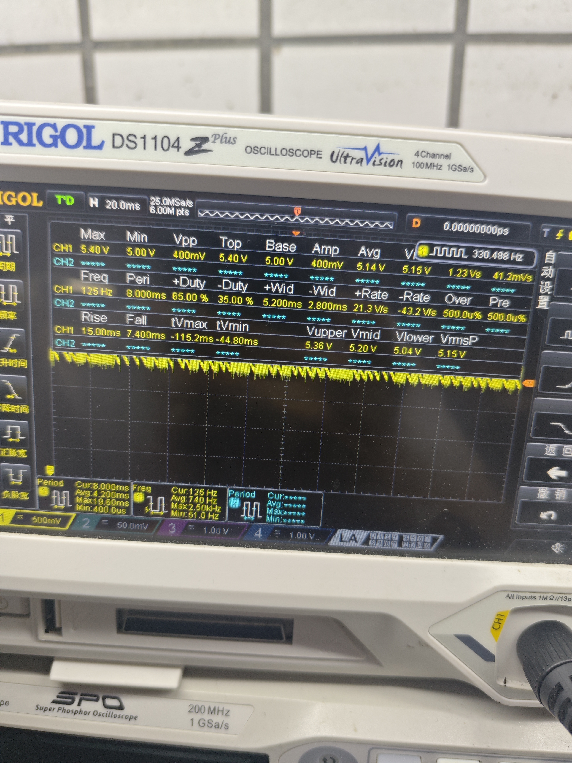
[picture p38: Power/test/5V_AUX_无输出电解_测量.jpg]
5V AUX无输出电解电容测量数据


1. U4上电后输出出现明显反复波动，疑似反复进入过流保护/启动状态。
2. 提高电子负载电流后，该路无法继续正常工作。
3. 断电测量发现U4模块：
   - 输入脚对GND接近0Ω；
   - 输出脚对GND接近0Ω；
   - 输入脚与输出脚之间接近0Ω。
4. 3V3对GND未发现相同的直接短路现象。

### 5.2 处理情况

- 故障U4已经拆除/隔离。
- 拆除后使用24V适配器进行整板基本上电检查，适配器及其余已开启部分工作正常。

### 5.3 初步结论

U4内部功率器件、输入电容或模块底部焊接可能发生击穿/桥连。由于输入、输出和地之间均接近0Ω，判定该模块已经损坏，不得再次接入24V电源。

在将5V Core改接到原5V AUX网络前，必须确认：

- U4输入已经与24V母线隔离；
- U4输出已经与5V AUX网络隔离；
- 5V AUX对GND不再短路；
- D10、C10、C7、C12和U6输入侧不存在异常短路。

## 6. 3.3V支路

- 当前静态对地检查未发现直接短路。
- 由于原5V AUX模块已经损坏并拆除，3.3V模块的正常输入电源路径发生变化。
- 尚未完成额定负载、纹波和长期温升测试。

此前未安装输出电解电容时记录的测量结果和波形：

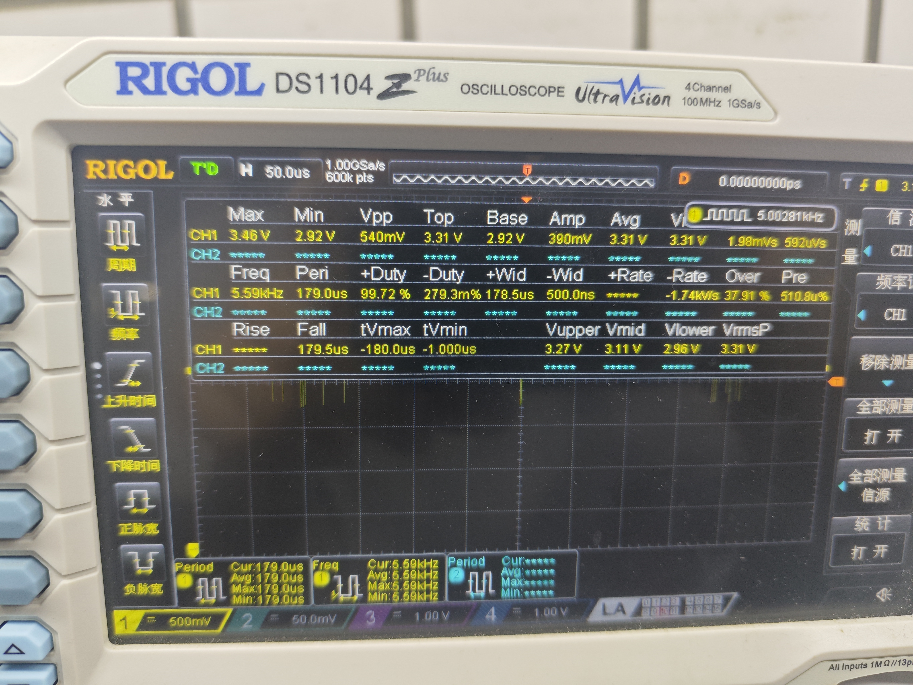
[picture p39: Power/test/3V3_无输出电解_测量.jpg]
3.3V无输出电解电容测量数据


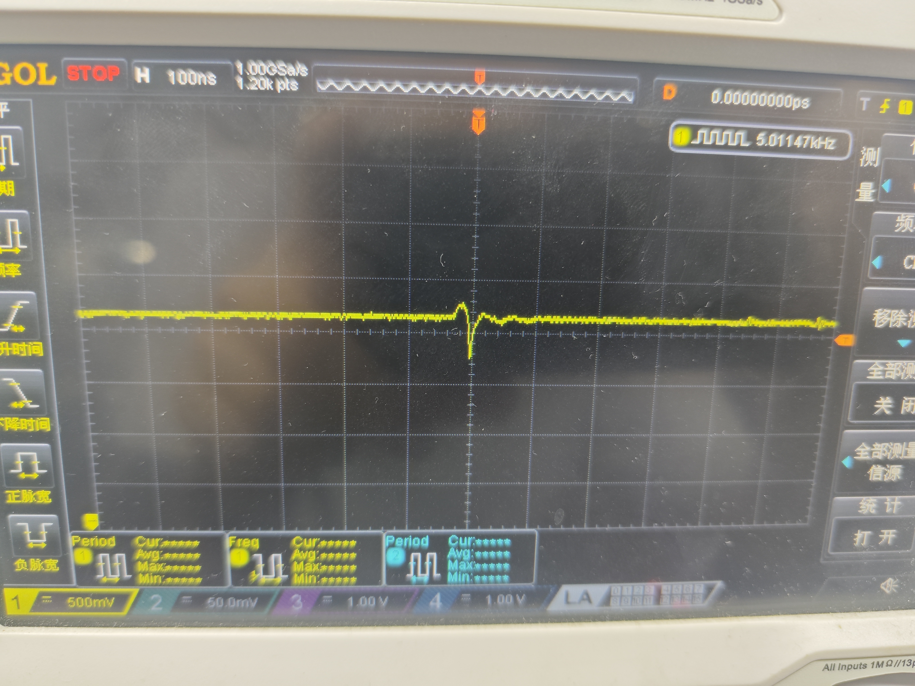
[picture p40: Power/test/3V3_无输出电解_波形.jpg]
3.3V无输出电解电容波形


结论：**待完成5V供电改线并进行限流上电后重新测试。**

## 7. 输入及开关部分

### 7.1 24V输入

- 24V适配器输出及基本上电测试正常。
- VIN_24_RAW和VIN_24_FUSED节点曾完成基本电压检查，未发现明显异常。

### 7.2 保护电路

- 前期曾出现PROT节点异常，排查过程中发现并移除异常电容，短路随后消失。
- Q1曾重新焊接。
- LM74700反接/反向保护功能尚未完成正式动作验证。

结论：保护电路只能视为完成基本通电检查，不能标记为完整功能通过。

### 7.3 开关

- 各支路自锁开关基本工作正常。
- 总拨动开关曾出现拨回OFF后输出仍不关闭的问题。

结论：总拨动开关及Q2/Q3栅极控制仍需排查，重点检查SW2引脚定义、R4上拉、MAIN_GATE电压以及Q2/Q3是否击穿或装反。

## 8. 系统供电需求变化

Linux开发板已经由原计划的5V供电改为12V供电。当前系统最坏情况的12V需求为：

- 电机：12V/5A，约60W；
- Linux开发板：建议按12V/5A预留，约60W。

不建议电机和Linux板共用当前这一只12V/5A模块。最终主板建议设置两路独立的24V转12V电源：

- 12V_MOTOR：连续5A，模块建议按8A以上标称能力选型；
- 12V_LINUX：按5A预留，模块建议按8A以上标称能力选型。

两路应分别配置保险丝、开关、TVS和输出电容，以降低电机启停导致Linux板掉电或重启的风险。

## 9. 测试结论汇总

| 测试项目 | 结果 | 说明 |
|---|---|---|
| 24V适配器基本供电 | 通过 | 已完成基本上电检查 |
| 12V/5A短时输出 | 通过 | 电压约11.67V，纹波约65mVpp |
| 12V/5A连续温升 | 不通过 | 散热片接近100℃ |
| 5V Core/5A短时输出 | 通过 | 电压约4.97V，纹波约90mVpp |
| 5V Core/5A连续温升 | 不通过 | 散热片约96℃ |
| 原5V AUX模块U4 | 不通过 | 输入、输出和地之间近似短路，已拆除/隔离 |
| 5V Core改作5V AUX | 2A温升通过 | 散热片稳定约50℃；2A输出电压和纹波数据待补充 |
| 3.3V输出 | 待测 | 需恢复上游5V供电后测试 |
| 总拨动开关 | 不通过/待修 | OFF后仍可能保持输出 |
| 反接保护功能 | 待测 | 尚未完成正式动作测试 |

## 10. 后续工作

1. 确认拆除U4后5V AUX网络对地电阻恢复正常。
2. 将5V Core与故障U4彻底隔离后，按需要改作5V AUX。
3. 补充记录新的5V AUX在2A下的输出电压和交流纹波；如2A未包含3.3V支路功耗，再增加2.5A左右的余量测试。
4. 恢复3.3V输入后，采用限流电源完成空载和逐级负载测试。
5. 排查总拨动开关、R4以及Q2/Q3的栅极控制。
6. 为12V模块增加风冷或更换更高连续功率模块，再重新执行5A、30分钟热测试。
7. 最终主板为电机和Linux板设置独立12V降压支路。
8. 所有整改完成后，再进行多路同时加载和电机启停瞬态测试。
