xiaomiao321/taideng/Power/board/电源板原理图.pdf

# 24V输入

# 24V输入总开关

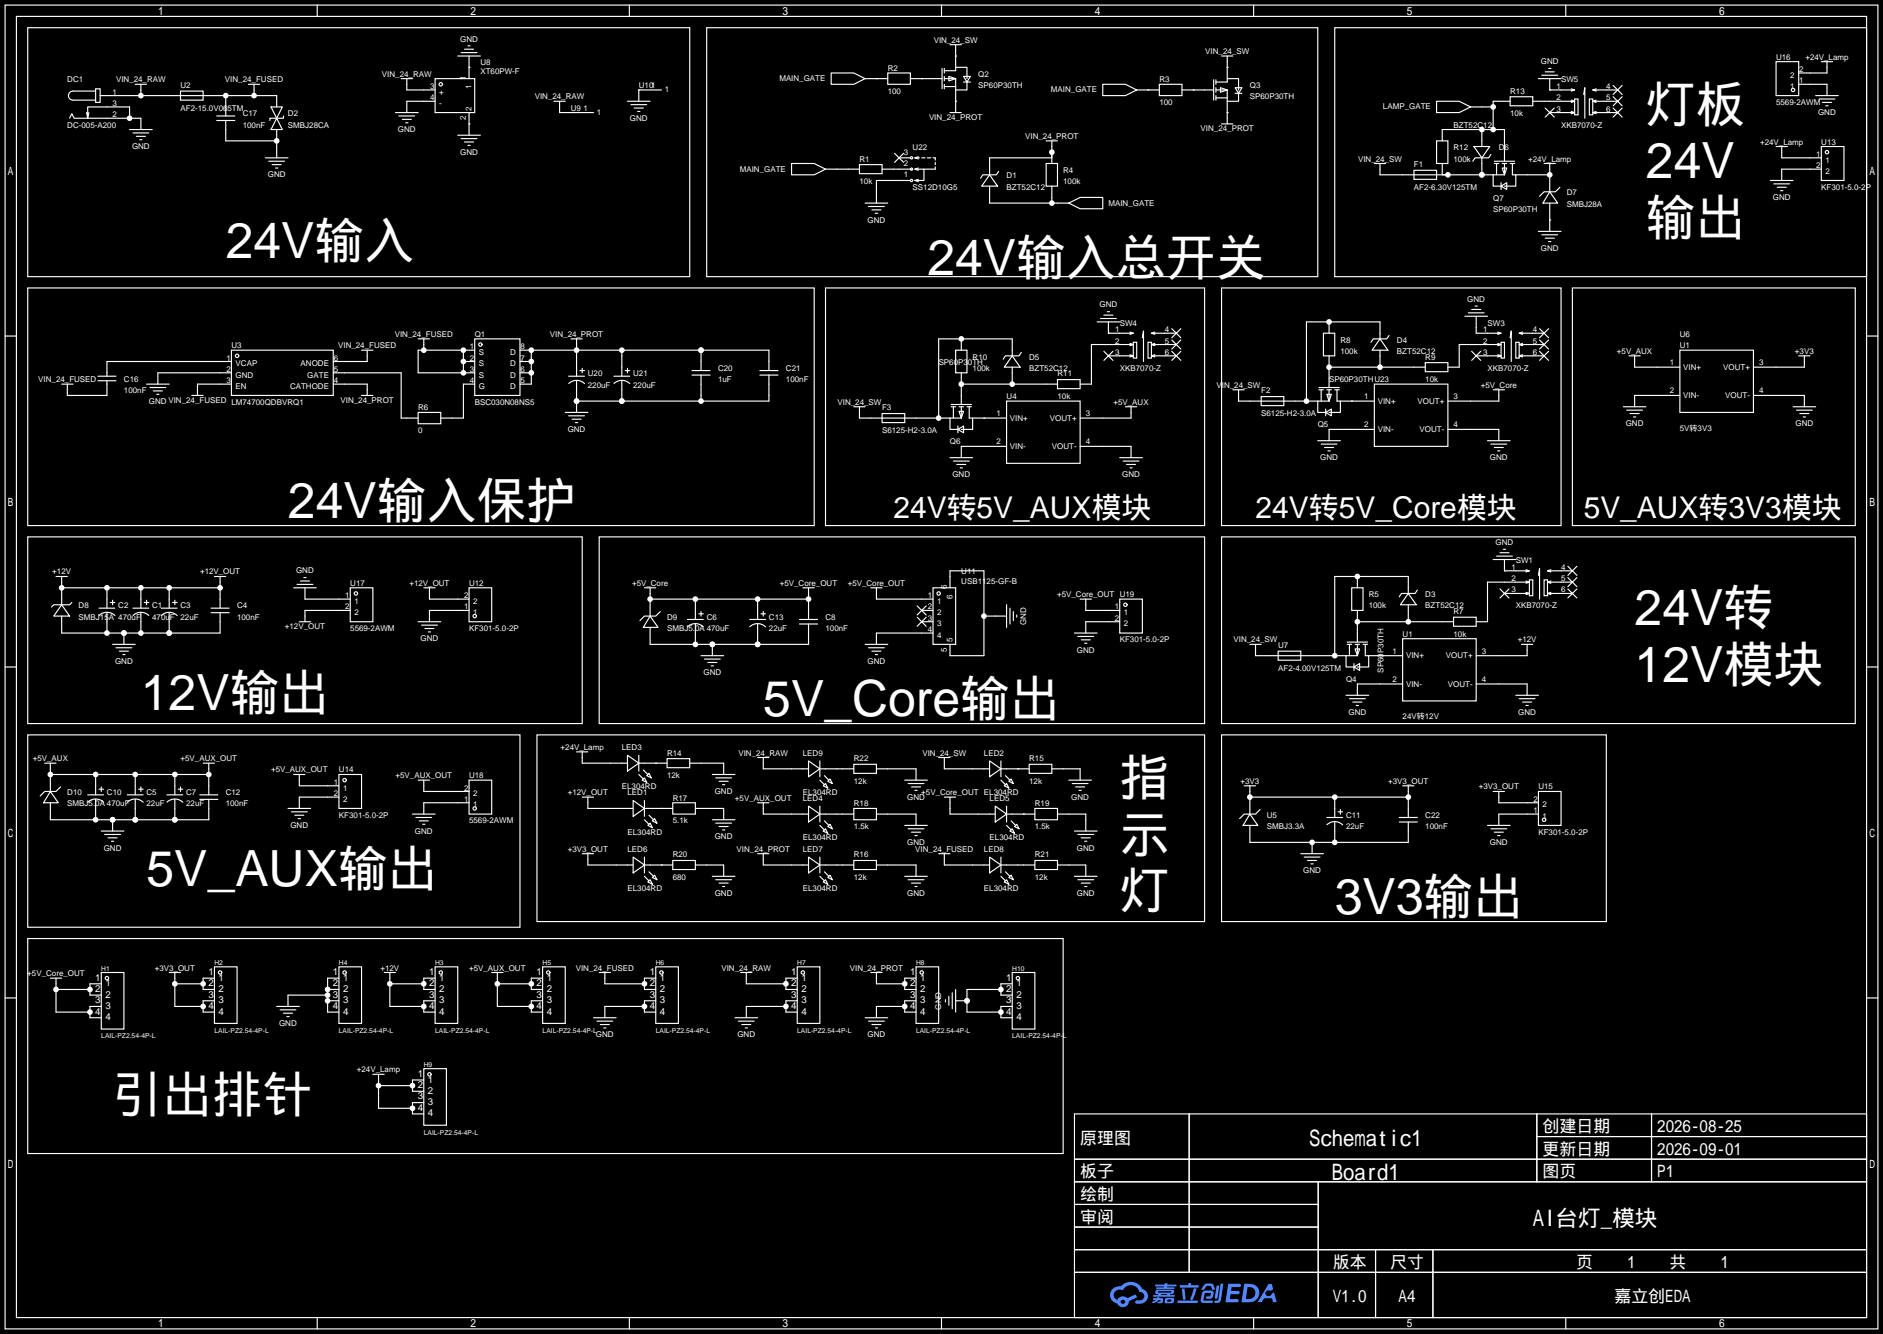
[picture p41: page 1]

原理图 | Schematic1 | 创建日期 | 2026-08-25

更新日期 | 2026-09-01

板子 | Board1 | 图页 | P1
绘制 | | AI台灯_模块
审阅

V1.0 | A4 | 嘉立创EDA
