xiaomiao321/taideng/(list of files, drawings)

Other design files:
MCU/hardware/ProPrj_AI台灯_模块版_2026-09-22.epro
Power/sim/开关仿真.ms14
