xiaomiao321/taideng/MCU/software/App/src/app_main.c

/**
 * @file app_main.c
 * @brief 应用层实现：串口收发、协议解析与命令分派的接线。
 *
 * Android 模式：支持灯光开关/亮度、PING、状态查询、底盘前进/后退/左右转和
 * 全电机 STOP，以及 extension-v2 的关节定位、回原点、分区灯、蜂鸣器、指示灯
 * 和它们的扩展状态查询。HOME 键按下立即停止全部电机。
 *
 * 扩展输出的 ID 由本文件定义，须与 App 端能力描述一致：
 *   - 分区灯 lightZoneIds：1～4 为上灯板 UP1～UP4，5～7 为下灯板 DOWN1～DOWN3；
 *   - 蜂鸣器 buzzerPatternIds：0～3，见 app_config.h 的 MCU_BUZZER_PATTERNS；
 *   - 指示灯 indicatorIds：1 为 STATE，2 为 ACT。COMM 和 ERROR 由固件自己用。
 *
 * @note 调试日志继续走 USART3；USART1 只跑二进制协议，不再发文本。
 */

#include "app_main.h"

#include <string.h>

#include "bsp_buzzer.h"
#include "bsp_common.h"
#include "bsp_key.h"
#include "bsp_led.h"
#include "bsp_light.h"
#include "bsp_linux_uart.h"
#include "bsp_log.h"
#include "bsp_motor.h"
#include "chassis.h"
#include "joint_service.h"
#include "main.h"
#include "mcu_command.h"

/** @brief 单次接收的空闲/超时时间，单位毫秒。 */
#define APP_UART_RX_TIMEOUT_MS (1000U)

/** @brief 单次发送的超时时间，单位毫秒。 */
#define APP_UART_TX_TIMEOUT_MS (100U)

/** @brief 通信指示灯每次闪烁的持续时间，单位毫秒。 */
#define APP_COMM_LED_PULSE_MS (50U)

/** @brief 重新启动接收失败后，下一次重试前的等待时间，单位毫秒。 */
#define APP_UART_REARM_RETRY_MS (100U)

/* -------------------------------------------------------------------------- */
/* 内部状态                                                                    */
/* -------------------------------------------------------------------------- */

/**
 * @brief USART1 双接收缓冲，容量沿用 BSP 允许的最大值。
 *
 * 一块交给 UART 接收下一批字节，另一块留给主循环慢慢解析；
 * 解析过程中可能要多次发送回复，期间不能让新数据覆盖还没喂完的字节。
 */
static uint8_t s_rx_buffers[2][BSP_LINUX_UART_RX_MAX_SIZE];
/** @brief 当前交给 UART 接收的缓冲下标，0 或 1。 */
static uint8_t s_rx_index = 0U;
/** @brief 发送缓冲，最大一帧即可。 */
static uint8_t s_tx_buffer[MCU_PROTOCOL_MAX_FRAME_SIZE];
/** @brief 当前是否有一次接收正在进行。 */
static bool s_is_receive_started = false;
/** @brief 上一次启动接收是否失败；用于只在状态变化时打一次日志。 */
static bool s_is_rearm_failing = false;
/** @brief 启动接收失败后，允许下一次重试的时刻。 */
static uint32_t s_rearm_retry_ms = 0U;
/** @brief USART1 收发错误累计数，只用于日志排查。 */
static uint32_t s_uart_error_count = 0U;
/** @brief SET_LIGHT 最近一次设定的统一亮度 0～100，STATUS 回读用。 */
static uint8_t s_brightness = 0U;
/** @brief 各分区灯的实际开关，下标为分区 ID 减 1，即 bsp_light_id_t。 */
static bool s_zone_on[BSP_LIGHT_COUNT];
/** @brief 各分区灯最近设定的亮度 0～100；关灯时保留，供回读。 */
static uint8_t s_zone_brightness[BSP_LIGHT_COUNT];
/** @brief 蜂鸣器图案表，见 MCU_BUZZER_PATTERNS。 */
static const struct
{
    uint16_t on_ms;  /**< 每个周期响的时长，0 表示不响。 */
    uint16_t off_ms; /**< 每个周期停的时长，0 表示一直响。 */
} k_buzzer_patterns[] = MCU_BUZZER_PATTERNS;
/** @brief 图案 ID 的个数。 */
#define APP_BUZZER_PATTERN_COUNT                                               \
    ((uint8_t)(sizeof(k_buzzer_patterns) / sizeof(k_buzzer_patterns[0])))
/** @brief 蜂鸣器 BSP 是否初始化成功；失败时 SET_BUZZER 回硬件故障。 */
static bool s_is_buzzer_ok = false;
/** @brief 当前蜂鸣器图案 ID。 */
static uint8_t s_buzzer_pattern = 0U;
/** @brief 当前蜂鸣器音量 0～100，0 表示静音。 */
static uint8_t s_buzzer_volume = 0U;
/** @brief 当前图案开始的时刻，用于计算响停相位。 */
static uint32_t s_buzzer_start_ms = 0U;
/** @brief 蜂鸣器此刻是否在出声。 */
static bool s_is_buzzer_sounding = false;
/** @brief 开放给主机的指示灯，下标为指示灯 ID 减 1。 */
static const bsp_led_id_t k_indicators[] = {BSP_LED_ID_STATE,
                                            BSP_LED_ID_ACTIVITY};
/** @brief 指示灯 ID 的个数。 */
#define APP_INDICATOR_COUNT                                                    \
    ((uint8_t)(sizeof(k_indicators) / sizeof(k_indicators[0])))
/** @brief 各开放指示灯的实际开关。 */
static bool s_indicator_on[sizeof(k_indicators) / sizeof(k_indicators[0])];
/** @brief 通信指示灯是否正处于闪烁脉冲中。 */
static bool s_comm_led_is_on = false;
/** @brief 通信指示灯应当熄灭的时刻。 */
static uint32_t s_comm_led_off_ms = 0U;
/** @brief 已处理过的 HOME 按下次数，用于发现新的按下。 */
static uint32_t s_home_count = 0U;
/** @brief 各关节当前运动的速度上限请求，毫度/秒；不在运动时无意义。 */
static int32_t s_arm_speed[JOINT_COUNT];
/** @brief 各关节 HOME_ARM 的目标角度，见 MCU_ARM_HOME_MDEG。 */
static const int32_t k_arm_home[JOINT_COUNT] = MCU_ARM_HOME_MDEG;
/** @brief 交给 joint_move 的命令序号，只出现在日志里。 */
static unsigned s_arm_seq = 0U;
/** @brief 底盘 M7/M8 的动作状态与故障锁存。 */
static chassis_t s_chassis;

/* -------------------------------------------------------------------------- */
/* 命令层的硬件回调                                                            */
/* -------------------------------------------------------------------------- */

/** @brief 是否有任意一路分区灯亮着。 */
static bool any_zone_on(void)
{
    for (uint32_t i = 0U; i < (uint32_t)BSP_LIGHT_COUNT; ++i)
    {
        if (s_zone_on[i])
        {
            return true;
        }
    }
    return false;
}

/**
 * @brief 回读当前实际状态。
 *
 * @note 灯光开关为任意一路分区灯亮着即为 1，亮度为最近一次 SET_LIGHT 的
 *       统一亮度；只用 SET_LIGHT 时两者都和提交值一致。底盘开环，实际与目标
 *       都是最近一次成功应用的动作和速度。故障位为全部关节锁存故障与底盘
 *       故障的按位或。
 */
static void hw_read_status(mcu_status_t *status)
{
    status->light_enabled = any_zone_on() ? 1U : 0U;
    status->brightness = s_brightness;
    status->motion = s_chassis.motion;
    status->target_motion = s_chassis.motion;
    status->speed = s_chassis.speed;
    status->target_speed = s_chassis.speed;
    status->fault_flags = joint_fault_flags(joint_service_joints()) |
                          chassis_fault_flags(&s_chassis);
}

/** @brief 取消全部关节运动、停下底盘并让八路电机滑行；返回是否全部成功。 */
static bool stop_all_motors(void)
{
    bool ok = joint_cancel(joint_service_joints());
    ok = chassis_stop(&s_chassis) && ok;
    return (bsp_motor_stop_all() == BSP_OK) && ok;
}

/** @brief 底盘回调：设置一台电机的占空比。 */
static bool chassis_drive(unsigned motor, int duty)
{
    return bsp_motor_set_duty((bsp_motor_id_t)motor, (int16_t)duty) == BSP_OK;
}

/** @brief 亮度 0～100 换算成灯光 PWM 千分比，关灯时为 0。 */
static uint16_t light_duty(bool is_on, uint8_t brightness)
{
    if (!is_on)
    {
        return 0U;
    }
    return (uint16_t)(((uint32_t)brightness * BSP_LIGHT_PWM_DUTY_MAX) / 100U);
}

/** @brief 关掉全部分区灯，用于硬件失败后的收尾。 */
static void all_zones_off(void)
{
    for (uint32_t i = 0U; i < (uint32_t)BSP_LIGHT_COUNT; ++i)
    {
        (void)bsp_light_set_duty((bsp_light_id_t)i, 0U);
        s_zone_on[i] = false;
    }
}

/**
 * @brief 应用灯光总开关和亮度。
 *
 * @note 七路灯板一起调：每一路分区都设成同一个开关和亮度，覆盖之前 SET_LIGHT_ZONE
 *       的单独设置。关灯时保留亮度值，供回读。
 */
static bool hw_apply_light(uint8_t light_flags, uint8_t brightness)
{
    bool is_on = (light_flags & 0x01U) != 0U;
    uint16_t duty = light_duty(is_on, brightness);

    s_brightness = brightness;
    for (uint32_t i = 0U; i < (uint32_t)BSP_LIGHT_COUNT; ++i)
    {
        if (bsp_light_set_duty((bsp_light_id_t)i, duty) != BSP_OK)
        {
            /* 有任意一路失败就全部关掉，不留"只亮一半"的中间态。 */
            all_zones_off();
            return false;
        }
        s_zone_on[i] = is_on;
        s_zone_brightness[i] = brightness;
    }
    return true;
}

/**
 * @brief SET_LIGHT_ZONE：设置一路分区灯，其他分区不变。
 *
 * @note 分区 ID 1～7 依次对应 UP1～UP4、DOWN1～DOWN3。
 */
static uint8_t hw_light_zone(uint8_t zone_id, bool is_on, uint8_t brightness)
{
    if ((zone_id == 0U) || (zone_id > (uint8_t)BSP_LIGHT_COUNT))
    {
        return MCU_PROTOCOL_RESULT_INVALID_VALUE;
    }
    unsigned index = (unsigned)zone_id - 1U;
    if (bsp_light_set_duty((bsp_light_id_t)index,
                           light_duty(is_on, brightness)) != BSP_OK)
    {
        (void)bsp_light_set_duty((bsp_light_id_t)index, 0U);
        s_zone_on[index] = false;
        return MCU_PROTOCOL_RESULT_HARDWARE;
    }
    s_zone_on[index] = is_on;
    s_zone_brightness[index] = brightness;
    return MCU_PROTOCOL_RESULT_OK;
}

/** @brief 当前图案在 now_ms 时刻是否应该出声。 */
static bool buzzer_should_sound(uint32_t now_ms)
{
    uint32_t on_ms = k_buzzer_patterns[s_buzzer_pattern].on_ms;
    uint32_t off_ms = k_buzzer_patterns[s_buzzer_pattern].off_ms;
    if ((s_buzzer_volume == 0U) || (on_ms == 0U))
    {
        return false;
    }
    if (off_ms == 0U)
    {
        return true;
    }
    return ((now_ms - s_buzzer_start_ms) % (on_ms + off_ms)) < on_ms;
}

/**
 * @brief 让蜂鸣器出声或停下。
 *
 * @note 音量 1～100 线性换算成占空比 1%～50%。
 */
static bool buzzer_output(bool is_on)
{
    bsp_status_t status = BSP_OK;
    if (is_on)
    {
        uint16_t duty = (uint16_t)(10U + ((uint32_t)s_buzzer_volume - 1U) *
                                             490U / 99U);
        status = bsp_buzzer_start_duty(MCU_BUZZER_FREQ_HZ, duty);
    }
    else
    {
        status = bsp_buzzer_stop();
    }
    s_is_buzzer_sounding = is_on && (status == BSP_OK);
    return status == BSP_OK;
}

/** @brief 主循环里按图案的响停相位切换蜂鸣器，只在需要变化时操作硬件。 */
static void update_buzzer(uint32_t now_ms)
{
    if (!s_is_buzzer_ok)
    {
        return;
    }
    bool should_sound = buzzer_should_sound(now_ms);
    if (should_sound != s_is_buzzer_sounding)
    {
        (void)buzzer_output(should_sound);
    }
}

/** @brief SET_BUZZER：换一个图案和音量，从这一刻重新开始计相位。 */
static uint8_t hw_buzzer(uint8_t pattern_id, uint8_t volume)
{
    if (pattern_id >= APP_BUZZER_PATTERN_COUNT)
    {
        return MCU_PROTOCOL_RESULT_INVALID_VALUE;
    }
    if (!s_is_buzzer_ok)
    {
        return MCU_PROTOCOL_RESULT_HARDWARE;
    }
    uint32_t now_ms = HAL_GetTick();
    s_buzzer_pattern = pattern_id;
    s_buzzer_volume = volume;
    s_buzzer_start_ms = now_ms;
    /* 音量可能变了，正在响也要重新设一次占空比。 */
    if (!buzzer_output(buzzer_should_sound(now_ms)))
    {
        (void)bsp_buzzer_stop();
        s_is_buzzer_sounding = false;
        s_buzzer_pattern = 0U;
        return MCU_PROTOCOL_RESULT_HARDWARE;
    }
    return MCU_PROTOCOL_RESULT_OK;
}

/** @brief 关掉蜂鸣器图案，音量保留。 */
static void buzzer_off(void)
{
    s_buzzer_pattern = 0U;
    if (s_is_buzzer_ok)
    {
        (void)buzzer_output(false);
    }
}

/** @brief SET_INDICATOR：设置 STATE 或 ACT 指示灯。 */
static uint8_t hw_indicator(uint8_t indicator_id, bool is_on)
{
    if ((indicator_id == 0U) || (indicator_id > APP_INDICATOR_COUNT))
    {
        return MCU_PROTOCOL_RESULT_INVALID_VALUE;
    }
    unsigned index = (unsigned)indicator_id - 1U;
    if (bsp_led_set(k_indicators[index], is_on) != BSP_OK)
    {
        return MCU_PROTOCOL_RESULT_HARDWARE;
    }
    s_indicator_on[index] = is_on;
    return MCU_PROTOCOL_RESULT_OK;
}

/**
 * @brief 分区灯、蜂鸣器、指示灯的扩展状态。
 *
 * @note 都是开环输出，实际值和目标值相同，故障位恒为 0。蜂鸣器回读当前图案，
 *       与查询时给的图案 ID 无关，只要该 ID 有效。
 */
static uint8_t hw_output_status(uint8_t command, uint8_t selector,
                                mcu_extended_status_t *status)
{
    switch (command)
    {
        case MCU_PROTOCOL_CMD_SET_LIGHT_ZONE:
            if ((selector == 0U) || (selector > (uint8_t)BSP_LIGHT_COUNT))
            {
                return MCU_PROTOCOL_RESULT_INVALID_VALUE;
            }
            status->actual = s_zone_on[selector - 1U] ? 1 : 0;
            status->actual_speed = s_zone_brightness[selector - 1U];
            break;
        case MCU_PROTOCOL_CMD_SET_BUZZER:
            if (selector >= APP_BUZZER_PATTERN_COUNT)
            {
                return MCU_PROTOCOL_RESULT_INVALID_VALUE;
            }
            status->actual = s_buzzer_pattern;
            status->actual_speed = s_buzzer_volume;
            break;
        default: /* SET_INDICATOR */
            if ((selector == 0U) || (selector > APP_INDICATOR_COUNT))
            {
                return MCU_PROTOCOL_RESULT_INVALID_VALUE;
            }
            status->actual = s_indicator_on[selector - 1U] ? 1 : 0;
            status->actual_speed = 0;
            break;
    }
    status->faults = 0U;
    status->target = status->actual;
    status->target_speed = status->actual_speed;
    return MCU_PROTOCOL_RESULT_OK;
}

/**
 * @brief 应用一个宏观运动动作。
 *
 * @note 非 STOP 只驱动底盘，不影响关节；驱动失败时底盘停下并锁存故障。
 *       STOP 取消全部关节运动、八路电机滑行，再清除原因已消失的关节和底盘
 *       故障锁存（电位器仍断线等持续故障保留）。
 */
static bool hw_apply_motion(uint8_t motion, uint8_t speed)
{
    if (motion != MCU_PROTOCOL_MOTION_STOP)
    {
        bool ok = chassis_apply(&s_chassis, motion, speed);
        if (!ok)
        {
            LOG_WARN("APP", "chassis drive failed, motion %u speed %u",
                     (unsigned)motion, (unsigned)speed);
        }
        return ok;
    }
    bool ok = stop_all_motors();
    joint_clear_faults(joint_service_joints(), HAL_GetTick());
    chassis_clear_fault(&s_chassis);
    return ok;
}

/**
 * @brief 失联时的安全停止：立即停止全部运动输出并关掉蜂鸣器，灯光和指示灯
 *        保持，不清故障。
 */
static void hw_safe_stop(void)
{
    (void)stop_all_motors();
    buzzer_off();
}

/** @brief 把 joint_move 的错误名换成协议结果码。 */
static uint8_t arm_result(const char *err)
{
    if (err == NULL)
    {
        return MCU_PROTOCOL_RESULT_OK;
    }
    if (!strcmp(err, "TARGET_RANGE") || !strcmp(err, "TOO_SLOW"))
    {
        return MCU_PROTOCOL_RESULT_INVALID_VALUE;
    }
    if (!strcmp(err, "NOT_CALIBRATED"))
    {
        /* 未标定的关节不能声明为支持，与未知命令同样处理。 */
        return MCU_PROTOCOL_RESULT_INVALID_COMMAND;
    }
    if (!strcmp(err, "SENSOR_STALE") || !strcmp(err, "POSITION_RANGE"))
    {
        return MCU_PROTOCOL_RESULT_HARDWARE;
    }
    return MCU_PROTOCOL_RESULT_INTERNAL;
}

/**
 * @brief 启动一个关节的定位。
 *
 * @note 轨迹式下 speed 作为本次运动的速度上限；其他控制方式只记录，不限速。
 *       轨迹时长超过 MCU_ARM_MOVE_TIMEOUT_MS 时回 INVALID_VALUE。
 */
static uint8_t start_arm(uint8_t joint_id, int32_t target, int32_t speed)
{
    unsigned index = (unsigned)joint_id - 1U;
    const char *err =
        joint_move_speed(joint_service_joints(), ++s_arm_seq, index, target,
                         MCU_ARM_MOVE_TIMEOUT_MS, speed, HAL_GetTick());
    if (err == NULL)
    {
        s_arm_speed[index] = speed;
    }
    else
    {
        LOG_WARN("APP", "M%u move rejected: %s", (unsigned)joint_id, err);
    }
    return arm_result(err);
}

/** @brief HOME_ARM：转到配置的原点；没有配置原点的关节回未知命令。 */
static uint8_t hw_arm_home(uint8_t joint_id)
{
    int32_t home = k_arm_home[joint_id - 1U];
    if (home == MCU_ARM_HOME_NONE)
    {
        return MCU_PROTOCOL_RESULT_INVALID_COMMAND;
    }
    /* HOME 没有速度参数：轨迹式按默认速度上限，其他方式目标速度报 0。 */
    return start_arm(joint_id, home, 0);
}

/**
 * @brief 关节扩展状态：位置为标定后的真实角度，实际速度为电位器估计值，
 *        目标速度在轨迹式运动中为轨迹参考速度，其他控制方式运动中为本次
 *        速度请求，停止后都为 0。
 */
static uint8_t hw_arm_status(uint8_t command, uint8_t joint_id,
                             mcu_extended_status_t *status)
{
    (void)command;
    unsigned index = (unsigned)joint_id - 1U;
    const joint_state_t *s = &joint_service_joints()->states[index];
    if (!s->calibrated)
    {
        return MCU_PROTOCOL_RESULT_INVALID_COMMAND;
    }
    status->faults = s->faults;
    status->actual = s->angle;
    status->target = s->target;
    status->actual_speed = s->speed;
    /* 轨迹式报轨迹上的参考速度，其他控制方式报本次的速度请求。 */
    status->target_speed = !s->motion.active          ? 0
                           : s->motion.seg_count > 0U ? s->motion.ref_speed
                                                      : s_arm_speed[index];
    return MCU_PROTOCOL_RESULT_OK;
}

/** @brief JRESULT 等文本行转到调试日志，去掉行尾 CRLF。 */
static void joint_log(const char *line)
{
    char text[80];
    size_t n = 0U;
    while (line[n] != '\0' && line[n] != '\r' && n < sizeof(text) - 1U)
    {
        text[n] = line[n];
        ++n;
    }
    text[n] = '\0';
    LOG_INFO("JOINT", "%s", text);
}

/** @brief 命令层使用的硬件回调表。 */
static const mcu_command_hw_t g_mcu_hw = {
    .read_status = hw_read_status,
    .apply_light = hw_apply_light,
    .apply_motion = hw_apply_motion,
    .safe_stop = hw_safe_stop,
    .arm_move = start_arm,
    .arm_home = hw_arm_home,
    .arm_status = hw_arm_status,
    .light_zone = hw_light_zone,
    .buzzer = hw_buzzer,
    .indicator = hw_indicator,
    .output_status = hw_output_status,
};

/* -------------------------------------------------------------------------- */
/* 内部工具                                                                    */
/* -------------------------------------------------------------------------- */

/**
 * @brief HOME 键急停：发现新的按下就停止全部电机。
 *
 * @note 只停不锁，也不清故障；之后主机仍可正常下发命令。
 */
static void check_home_key(void)
{
    uint32_t count = s_home_count;
    if (bsp_key_get_press_count(&count) != BSP_OK || count == s_home_count)
    {
        return;
    }
    s_home_count = count;
    if (!stop_all_motors())
    {
        LOG_WARN("APP", "HOME stop failed");
    }
    LOG_INFO("APP", "HOME pressed, all motors stopped");
}

/** @brief 报告一个不可恢复的初始化错误。 */
static void fail_hard(void)
{
    (void)bsp_led_set(BSP_LED_ID_ERROR, true);
    Error_Handler();
}

/**
 * @brief 点亮通信指示灯，并安排一小段之后自动熄灭。
 *
 * @param[in] now_ms 当前时刻。
 *
 * @note 非阻塞：主循环不会在这里等待，靠 update_comm_led() 到点熄灭。
 */
static void pulse_comm_led(uint32_t now_ms)
{
    (void)bsp_led_set(BSP_LED_ID_COMM, true);
    s_comm_led_is_on = true;
    s_comm_led_off_ms = now_ms + APP_COMM_LED_PULSE_MS;
}

/** @brief 闪烁时间到就把通信指示灯熄灭。 */
static void update_comm_led(uint32_t now_ms)
{
    /* 用有符号差值比较，HAL_GetTick() 回绕（约 49.7 天）时判断依然正确。 */
    if (s_comm_led_is_on && ((int32_t)(now_ms - s_comm_led_off_ms) >= 0))
    {
        (void)bsp_led_set(BSP_LED_ID_COMM, false);
        s_comm_led_is_on = false;
    }
}

/**
 * @brief 在当前接收缓冲上启动一次 USART1 接收。
 *
 * @param[in] now_ms 当前时刻。
 *
 * @note 失败不进 Error_Handler：串口出错是现场常态（插拔线、上电毛刺），
 *       整机停死只能靠复位恢复。这里记录错误，APP_UART_REARM_RETRY_MS
 *       后由 app_run_once() 重试；一直收不到报文时由命令层的失联保护停电机。
 */
static void arm_receive(uint32_t now_ms)
{
    bsp_status_t status = bsp_linux_uart_start_receive(
        s_rx_buffers[s_rx_index], sizeof(s_rx_buffers[s_rx_index]),
        APP_UART_RX_TIMEOUT_MS);
    if (status != BSP_OK)
    {
        if (!s_is_rearm_failing)
        {
            LOG_WARN("APP", "uart1 rx start failed: %s",
                     bsp_status_str(status));
        }
        s_is_rearm_failing = true;
        s_rearm_retry_ms = now_ms + APP_UART_REARM_RETRY_MS;
        return;
    }
    if (s_is_rearm_failing)
    {
        LOG_INFO("APP", "uart1 rx restarted");
    }
    s_is_rearm_failing = false;
    s_is_receive_started = true;
}

/**
 * @brief 取出并处理解析器队列里的全部请求，需要时发送回复。
 *
 * @retval true 至少处理了一条请求。
 * @retval false 队列为空。
 *
 * @note 发送失败只计数和打日志，不停机：主机会因收不到 ACK 而重发。
 */
static bool handle_pending_frames(void)
{
    mcu_frame_t request;
    mcu_frame_t reply;
    bool has_handled = false;

    while (mcu_protocol_pop_frame(&request))
    {
        has_handled = true;

        /* 通信指示灯：每收到一条合法报文闪一下，链路一断就不闪了。 */
        pulse_comm_led(HAL_GetTick());

        /* DEBUG 级日志只在 Debug 构建里编译进去，正式跑不影响时序。 */
        LOG_DEBUG("PROTO", "rx seq=%u cmd=0x%02X len=%u",
                  (unsigned int)request.seq, (unsigned int)request.cmd,
                  (unsigned int)request.payload_length);

        if (mcu_command_handle(&request, &reply, HAL_GetTick()) == false)
        {
            continue;
        }

        size_t tx_length =
            mcu_protocol_encode(&reply, s_tx_buffer, sizeof(s_tx_buffer));
        if (tx_length == 0U)
        {
            continue;
        }
        LOG_DEBUG("PROTO", "tx seq=%u cmd=0x%02X len=%u",
                  (unsigned int)reply.seq, (unsigned int)reply.cmd,
                  (unsigned int)tx_length);
        bsp_status_t status = bsp_linux_uart_write(s_tx_buffer, tx_length,
                                                   APP_UART_TX_TIMEOUT_MS);
        if (status != BSP_OK)
        {
            ++s_uart_error_count;
            LOG_WARN("APP", "uart1 tx failed: %s (errors=%lu)",
                     bsp_status_str(status), (unsigned long)s_uart_error_count);
        }
    }
    return has_handled;
}

/**
 * @brief 把一批收到的字节全部喂给解析器，并处理切出的请求。
 *
 * @param[in] data 收到的字节。
 * @param[in] length 字节数。
 *
 * @note 解析队列容量有限，一批字节里报文多于队列容量时 feed() 会提前返回；
 *       这里先处理已切出的请求腾出队列，再从断点继续喂，直到全部喂完、
 *       缓冲里也没有剩下完整报文为止。
 */
static void process_received(const uint8_t *data, size_t length)
{
    size_t offset = 0U;
    bool has_progress = true;

    while (has_progress)
    {
        size_t consumed = mcu_protocol_feed(&data[offset], length - offset);
        offset += consumed;
        bool has_handled = handle_pending_frames();
        /* 既没取走字节也没处理请求就停下，避免任何意外情况下死循环。 */
        has_progress = (consumed > 0U) || has_handled;
    }
}

/* -------------------------------------------------------------------------- */
/* 对外接口                                                                    */
/* -------------------------------------------------------------------------- */

void app_init(void)
{
    if (bsp_light_init() != BSP_OK)
    {
        fail_hard();
    }
    if (bsp_motor_init() != BSP_OK)
    {
        fail_hard();
    }
    if (bsp_key_init() != BSP_OK)
    {
        fail_hard();
    }
    /* 蜂鸣器不是必需的：初始化失败只记日志，SET_BUZZER 回硬件故障。 */
    s_is_buzzer_ok = bsp_buzzer_init() == BSP_OK;
    if (!s_is_buzzer_ok)
    {
        LOG_WARN("APP", "buzzer init failed");
    }
    chassis_init(&s_chassis, chassis_drive);
    unsigned restored = joint_service_init(joint_log);
    LOG_INFO("APP", "joints: %u calibrated, flash %s", restored,
             joint_service_store_ok() ? "ok" : "unavailable");
    if (bsp_linux_uart_init() != BSP_OK)
    {
        fail_hard();
    }

    mcu_protocol_reset();
    mcu_command_init(&g_mcu_hw, HAL_GetTick());
    arm_receive(HAL_GetTick());
    LOG_INFO("APP", "protocol ready");
}

void app_run_once(void)
{
    uint32_t now_ms = HAL_GetTick();

    if (!s_is_receive_started && ((int32_t)(now_ms - s_rearm_retry_ms) >= 0))
    {
        arm_receive(now_ms);
    }

    if (s_is_receive_started)
    {
        size_t received_length = 0U;
        bsp_status_t status = bsp_linux_uart_receive_update(&received_length);
        if (status != BSP_BUSY)
        {
            s_is_receive_started = false;
            const uint8_t *received = s_rx_buffers[s_rx_index];
            s_rx_index ^= 1U;

            if ((status != BSP_OK) && (status != BSP_ERR_TIMEOUT))
            {
                /* 帧错误、噪声、溢出等：丢掉这一批，重新接收即可。 */
                ++s_uart_error_count;
                LOG_WARN("APP", "uart1 rx failed: %s (errors=%lu)",
                         bsp_status_str(status),
                         (unsigned long)s_uart_error_count);
            }

            /* 先在另一块缓冲上重新接收再处理：处理和回复期间不漏主机下一帧。 */
            arm_receive(now_ms);

            if ((status == BSP_OK) && (received_length > 0U))
            {
                process_received(received, received_length);
            }
        }
    }

    check_home_key();
    if (!joint_service_update())
    {
        LOG_WARN("APP", "joint fault, flags 0x%02X",
                 (unsigned)joint_fault_flags(joint_service_joints()));
    }
    (void)mcu_command_poll(HAL_GetTick());
    update_comm_led(HAL_GetTick());
    update_buzzer(HAL_GetTick());
}
