xiaomiao321/taideng/MCU/software/Config/app_config.h

/**
 * @file app_config.h
 * @brief 全部可调参数集中在这里：运行模式、电机、关节控制、采样与安全时限。
 *
 * 修改后重新编译烧录即可生效。这里只放“调参会动”的宏；协议格式、标定数据
 * 格式、Flash 地址、缓冲区大小和引脚映射不在此列，改动它们需要同时改代码。
 *
 * 本文件不依赖 HAL，可被 BSP、App 和 PC 端 HostTest 共同包含。
 * 上位机 Tools/motor_debug/motor_limits.py 镜像了占空比范围，改这里时同步。
 */

#ifndef AITAID_APP_CONFIG_H
#define AITAID_APP_CONFIG_H

#include <stdbool.h>
#include <stdint.h>

/* -------------------------------------------------------------------------- */
/* 运行模式                                                                    */
/* -------------------------------------------------------------------------- */

#define APP_MODE_DEBUG (0) /**< USART3 上位机 / 终端，开放全部功能。 */
/** @brief USART1 二进制 Android 协议，USART3 只出日志；取值 2 沿用旧编号。 */
#define APP_MODE_ANDROID (2)

/** @brief 固件入口；编译时也可用 -DAPP_MODE=... 覆盖。 */
#ifndef APP_MODE
#define APP_MODE APP_MODE_DEBUG
#endif

/**
 * @brief 独立看门狗标称超时，单位毫秒。
 *
 * 主循环单次最长阻塞约 100ms（串口限时发送），LSI 最快时实际超时约为标称值
 * 的 0.68 倍，仍有充足余量。
 */
#define APP_WATCHDOG_TIMEOUT_MS (1000U)

/* -------------------------------------------------------------------------- */
/* 电机输出                                                                    */
/* -------------------------------------------------------------------------- */

/**
 * @brief 允许输出的最小占空比绝对值，千分比。
 *
 * 滑行 PWM 下低于约 50% 电机转不动；刹车 PWM 下能转的占空比更低，
 * 调试时需要扫低占空比，所以这里只挡掉明显无意义的值。
 */
#define MOTOR_DUTY_MIN (100)

/**
 * @brief 全部电机的占空比硬上限，千分比，暂定 100%。
 *
 * 开环 MSET、板级测试、关节开关式和比例式的输出都不会超过它；
 * 标定里填的占空比高于它时，输出按它截断，标定本身仍然有效。
 * 上位机 motor_limits.py 的 DUTY_LIMIT 需同步修改。
 */
#ifndef MOTOR_DUTY_LIMIT
#define MOTOR_DUTY_LIMIT (1000)
#endif

/**
 * @brief 上电默认的电机 PWM 频率（kHz，1、2、4、5、10、20 之一）与衰减方式。
 *
 * 2026-10-24 实测 M1：20kHz 滑行、5kHz 滑行、20kHz 刹车在 40% 下都转不动，
 * 5kHz 刹车 20%～30% 即可稳定转动，断电后滑行也小得多。
 */
#define BSP_MOTOR_PWM_DEFAULT_KHZ (5U)
#define BSP_MOTOR_PWM_DEFAULT_SLOW_DECAY (true)

/** @brief 调试终端里电机从停止到按新占空比启动之间的等待，单位毫秒。 */
#define DEBUG_CONTROL_SETTLE_MS (100U)

/** @brief 板级测试中单个电机项目的最长运行时间，单位毫秒。 */
#define DEBUG_BOARD_MAX_MOTOR_DURATION_MS (5000U)

/* -------------------------------------------------------------------------- */
/* 电位器与采样                                                                */
/* -------------------------------------------------------------------------- */

/** @brief 电位器采样周期，单位毫秒。 */
#define POT_SAMPLE_PERIOD_MS (10U)

/** @brief 每个采样周期连续扫描的次数，去掉最大最小各四分之一后取平均。 */
#define POT_OVERSAMPLE (16U)

/** @brief 电位器读数距上次采样超过该时间即视为失效，单位毫秒。 */
#define JOINT_SENSOR_STALE_MS (50U)

/** @brief 电位器标称电气行程，毫度。 */
#define JOINT_POT_TRAVEL_MDEG (270000)

/** @brief 电位器阻值未知时采用的标称值，欧姆。 */
#define JOINT_POT_DEFAULT_OHMS (45000U)

/** @brief 电位器两端各串的固定电阻（3V3-1k-[电位器]-1k-GND），欧姆。 */
#define JOINT_POT_END_OHMS (1000U)

/* -------------------------------------------------------------------------- */
/* 关节闭环                                                                    */
/* -------------------------------------------------------------------------- */

/**
 * @brief 没保存过控制参数时的默认值：比例式，每度 1%，起转 30%，制动 50ms。
 *
 * 2026-10-24 在 5kHz 刹车 PWM 下实测 M1：3°～30° 的定位 1～1.5 秒到位，
 * 过冲不超过 2.4°。已保存到 Flash 的参数优先。
 */
#define JOINT_DEFAULT_MODE (JOINT_MODE_P)
#define JOINT_DEFAULT_KP (10U)
#define JOINT_DEFAULT_DUTY_MIN (300U)
#define JOINT_DEFAULT_BRAKE_MS (50U)

/** @brief 比例系数上限，千分比/度。 */
#define JOINT_KP_MAX (1000U)

/** @brief 制动时长上限，单位毫秒；不超过 JOINT_REACHED_HOLD_MS。 */
#define JOINT_BRAKE_MAX_MS (200U)

/** @brief 到达容差的允许范围，毫度。 */
#define JOINT_TOLERANCE_MIN (100U)
#define JOINT_TOLERANCE_MAX (10000U)

/** @brief 单次运动超时的允许范围，单位毫秒。 */
#define JOINT_MOVE_TIMEOUT_MIN_MS (500U)
#define JOINT_MOVE_TIMEOUT_MAX_MS (60000U)

/** @brief 在容差内连续保持该时间才判定到达，单位毫秒。 */
#define JOINT_REACHED_HOLD_MS (200U)

/** @brief 误差至少减小这么多才算有进展，毫度。 */
#define JOINT_PROGRESS_STEP (500)

/** @brief 超过该时间没有进展判定为停滞，单位毫秒。 */
#define JOINT_STALL_MS (2000U)

/** @brief 误差比初始值多出 2 倍容差加该余量即判定方向反了，毫度。 */
#define JOINT_DIRECTION_MARGIN (1000U)

/** @brief 换向前停顿时间，单位毫秒。 */
#define JOINT_REVERSE_SETTLE_MS (100U)

/** @brief 开关式：误差小于 5 倍容差加该余量时改为点动，毫度。 */
#define JOINT_NEAR_MARGIN (5000U)

/** @brief 开关式点动脉冲：驱动段与停顿段时长，单位毫秒。 */
#define JOINT_PULSE_ON_MS (30U)
#define JOINT_PULSE_OFF_MS (100U)

/* 轨迹式控制（JTUNE 模式 2）。以下数值都是占位值，要在实物上辨识后再改。 */

/** @brief 轨迹速度上限，毫度/秒；SDK 给的速度更小时用 SDK 的。占位值。 */
#define JOINT_TRAJ_VMAX_MDEG_S (30000)

/** @brief 轨迹加速度上限，毫度/秒²。占位值。 */
#define JOINT_TRAJ_AMAX_MDEG_S2 (60000)

/** @brief 单段轨迹的最短时长，单位毫秒。 */
#define JOINT_TRAJ_MIN_MS (300U)

/**
 * @brief 各关节的速度前馈，千分比/(度/秒)，依次为 M1～M6。
 *
 * 等于稳态时“占空比减动摩擦占空比”除以转速，用几档恒定占空比测稳态转速
 * 得到。占位值。
 */
#define JOINT_TRAJ_KV                                                          \
    {                                                                          \
        10U, 10U, 10U, 10U, 10U, 10U                                           \
    }

/** @brief 加速度前馈，千分比/(度/秒²)。占位值，先不用。 */
#define JOINT_TRAJ_KA (0)

/** @brief PI 反馈的积分系数，千分比/(度·秒)；比例系数用 JTUNE 的 kp。占位值。 */
#define JOINT_TRAJ_KI (50)

/** @brief 积分项的限幅，千分比。 */
#define JOINT_TRAJ_I_MAX (150)

/** @brief 静止起步时预加的占空比比起转占空比低这么多，千分比。占位值。 */
#define JOINT_TRAJ_PRELOAD_MARGIN (30)

/** @brief 动摩擦占空比占起转占空比的百分比。占位值。 */
#define JOINT_TRAJ_KINETIC_PCT (80)

/** @brief 摩擦补偿从预加量过渡到动摩擦量所用的参考速度，毫度/秒。占位值。 */
#define JOINT_TRAJ_FRICTION_SPEED (5000)

/** @brief 跟踪误差超过该值持续 JOINT_STALL_MS 判定停滞，毫度。 */
#define JOINT_TRACK_ERROR_MAX (10000)

/**
 * @brief 各关节规定的逼近方向的上电默认值，依次为 M1～M6：+1 最后一段角度
 *        增大，即从角度小的一侧到达目标；-1 最后一段角度减小；0 不限定。
 *
 * 三种控制方式都适用。应选与标定时相同的方向，或逆着重力、负载的方向。
 * 调试命令 JDIR 可以逐关节修改，并随标定保存到 Flash，Flash 里有记录时以
 * 记录为准。
 */
#define JOINT_APPROACH_DIR                                                     \
    {                                                                          \
        0, 0, 0, 0, 0, 0                                                       \
    }

/** @brief 各关节背隙的上电默认值，毫度。占位值，可用 JDIR 修改。 */
#define JOINT_BACKLASH_MDEG                                                    \
    {                                                                          \
        1000, 1000, 1000, 1000, 1000, 1000                                     \
    }

/**
 * @brief 各关节反向到达时越过目标的量的上电默认值，毫度。占位值，可用 JDIR
 *        修改。比例式和开关式到中间点附近一个容差内就折返，实际越过目标约为
 *        超调量减容差，所以至少取背隙加容差。
 */
#define JOINT_OVERSHOOT_MDEG                                                   \
    {                                                                          \
        3000, 3000, 3000, 3000, 3000, 3000                                     \
    }

/** @brief 单向逼近回程段的速度上限，毫度/秒，压低齿面重新接触时的冲击。占位值。 */
#define JOINT_RETURN_SPEED_MDEG_S (5000)

/**
 * @brief 转速估计：取最近 JOINT_SPEED_WINDOW 次采样（10ms 一次，约 200ms），
 *        最后 JOINT_SPEED_EDGE 次的平均角度减最早 JOINT_SPEED_EDGE 次的平均
 *        角度，再除以两组的平均时间差。
 *
 * 静止噪声约 0.18° 时估计值的噪声约 0.75°/s（按样本独立估算，三点中值滤波
 * 使样本相关，实际会大一些，上板后再调）。
 */
#define JOINT_SPEED_WINDOW (21U)
#define JOINT_SPEED_EDGE (4U)

/**
 * @brief 零速判定的迟滞，毫度/秒：静止时超过 MOVE 才算开始转动，转动时低于
 *        ZERO 才报 0，避免估计值在阈值附近来回跳。
 */
#define JOINT_SPEED_ZERO_MDEG_S (2000)
#define JOINT_SPEED_MOVE_MDEG_S (4000)

/* -------------------------------------------------------------------------- */
/* 底盘                                                                        */
/* -------------------------------------------------------------------------- */

/**
 * @brief 左右履带对应的电机下标（M7 为 6，M8 为 7）与正方向。
 *
 * 方向为 1 表示该电机正转时整机前进，-1 表示反转时前进；装机后接线变了只改
 * 这里。2026-10-29 确认：左 M7、右 M8，两路都是正转前进。
 */
#define CHASSIS_LEFT_MOTOR (6U)
#define CHASSIS_RIGHT_MOTOR (7U)
#define CHASSIS_LEFT_SIGN (1)
#define CHASSIS_RIGHT_SIGN (1)

/* -------------------------------------------------------------------------- */
/* 通信与安全时限                                                              */
/* -------------------------------------------------------------------------- */

/** @brief 调试终端心跳超时：超过该时间没收到 PING 即停止输出并锁定，毫秒。 */
#define DEBUG_CONTROL_HEARTBEAT_TIMEOUT_MS (1000U)

/** @brief 调试终端周期状态上报的间隔，单位毫秒。 */
#define STATUS_REPORT_PERIOD_MS (100U)

/** @brief Android 协议失联保护：超过该时间没收到合法帧即停止全部电机，毫秒。 */
#define MCU_COMMAND_LINK_TIMEOUT_MS (5000U)

/**
 * @brief Android SET_ARM_POSITION 的固件内部单次运动期限，单位毫秒。
 *
 * 超时置故障位 bit1；应长于 SDK 的关节观察期限（默认 10 秒）。
 */
#define MCU_ARM_MOVE_TIMEOUT_MS (15000U)

/**
 * @brief 各关节 HOME_ARM 的目标角度，毫度，依次为 M1～M6。
 *
 * 2026-11-01 定为电位器行程中点 135°，前提是关节按电位器转角 0～270° 标定；
 * 135° 不在某关节允许范围内时 HOME_ARM 回 INVALID_VALUE，不会运动。
 * MCU_ARM_HOME_NONE 表示该关节没有 HOME，HOME_ARM 回未知命令。
 * 须与 App 端能力描述里的 homePositionMilliDegrees 保持一致。
 */
#define MCU_ARM_HOME_NONE (INT32_MIN)
#define MCU_ARM_HOME_MDEG                                                      \
    {                                                                          \
        135000, 135000, 135000, 135000, 135000, 135000                         \
    }

/**
 * @brief Android SET_BUZZER 的发声频率，单位 Hz；蜂鸣器在约 2.7kHz 最响。
 */
#define MCU_BUZZER_FREQ_HZ (2700U)

/**
 * @brief SET_BUZZER 的图案表，按图案 ID 0～3 依次给出 {响毫秒, 停毫秒}。
 *
 * 0 关，1 长鸣，2 慢响（响 200 停 800），3 快响（响 100 停 100）。响为 0 表示
 * 不响，停为 0 表示一直响。图案一直保持到下一条 SET_BUZZER，失联停机时回到 0。
 * 须与 App 端能力描述里的 buzzerPatternIds 保持一致。
 */
#define MCU_BUZZER_PATTERNS                                                    \
    {                                                                          \
        {0U, 0U}, {1U, 0U}, {200U, 800U}, {100U, 100U}                         \
    }

/** @brief HOME 键消抖时间，单位毫秒。 */
#define BSP_KEY_DEBOUNCE_MS (20U)

#endif /* AITAID_APP_CONFIG_H */
