xiaomiao321/taideng/MCU/software/Core/Src/main.c

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
/* Includes ------------------------------------------------------------------*/
#include "main.h"

#include "adc.h"
#include "dma.h"
#include "gpio.h"
#include "tim.h"
#include "usart.h"

/* USER CODE BEGIN Includes */
#include "app_config.h"
#include "app_main.h"
#include "bsp_common.h"
#include "bsp_led.h"
#include "bsp_log.h"
#include "bsp_motor.h"
#include "bsp_watchdog.h"
#include "debug_console.h"


/* USER CODE END Includes */

/* USER CODE BEGIN PD */
/* 运行模式 APP_MODE 与看门狗超时在 Config/app_config.h 中修改。 */
#if (APP_MODE != APP_MODE_DEBUG) && (APP_MODE != APP_MODE_ANDROID)
#error "Invalid APP_MODE: use APP_MODE_DEBUG or APP_MODE_ANDROID"
#endif

/* USER CODE END PD */


void SystemClock_Config(void);
/**
 * @brief  The application entry point.
 * @retval int
 */
int main(void)
{
    /* MCU
     * Configuration--------------------------------------------------------*/

    /* Reset of all peripherals, Initializes the Flash interface and the
     * Systick. */
    HAL_Init();

    /* Configure the system clock */
    SystemClock_Config();

    /* Initialize all configured peripherals */
    MX_GPIO_Init();
    MX_DMA_Init();
    MX_ADC1_Init();
    MX_TIM1_Init();
    MX_TIM2_Init();
    MX_TIM3_Init();
    MX_TIM4_Init();
    MX_TIM8_Init();
    MX_TIM9_Init();
    MX_TIM12_Init();
    MX_TIM13_Init();
    MX_USART1_UART_Init();
    MX_USART3_UART_Init();
    /* USER CODE BEGIN 2 */
    (void)bsp_led_init(); /* 出错指示先就绪 */
    if (bsp_log_init() != BSP_OK)
    {
        (void)bsp_led_set(BSP_LED_ID_ERROR, true);
        Error_Handler();
    }
    if (bsp_watchdog_take_reset_flag())
    {
        LOG_WARN("MAIN", "last reset was caused by the watchdog");
    }
#if APP_MODE == APP_MODE_ANDROID
    app_init();
#else
    debug_console_init();
#endif
    /* 初始化完成后再启动，初始化过程中的阻塞不计入看门狗超时。 */
    if (bsp_watchdog_start(APP_WATCHDOG_TIMEOUT_MS) != BSP_OK)
    {
        Error_Handler();
    }

    /* USER CODE END 2 */

    /* Infinite loop */
    /* USER CODE BEGIN WHILE */
    while (1)
    {
#if APP_MODE == APP_MODE_ANDROID
        app_run_once();
        bsp_watchdog_feed();
#else
        debug_console_update();
        bsp_watchdog_feed();
#endif
        /* USER CODE END WHILE */

        /* USER CODE BEGIN 3 */
    }
    /* USER CODE END 3 */
}

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
/* USER CODE BEGIN 4 */
/* HAL 弱回调统一放在 Core/Src/hal_callback_dispatch.c，不在 main.c 定义。 */
/* USER CODE END 4 */

/**
 * @brief  Period elapsed callback in non blocking mode
 * @note   This function is called  when TIM6 interrupt took place, inside
 * HAL_TIM_IRQHandler(). It makes a direct call to HAL_IncTick() to increment
 * a global variable "uwTick" used as application time base.
 * @param  htim : TIM handle
 * @retval None
 */
void HAL_TIM_PeriodElapsedCallback(TIM_HandleTypeDef *htim)
{
    if (htim->Instance == TIM6)
    {
        HAL_IncTick();
    }
}

/**
 * @brief  This function is executed in case of error occurrence.
 * @retval None
 */
void Error_Handler(void)
{
    /* USER CODE BEGIN Error_Handler_Debug */
    /* 不用 bsp_motor_stop_all()：它要求驱动已初始化，而这里可能在任何阶段进入。 */
    bsp_motor_emergency_stop();
    (void)bsp_led_set(BSP_LED_ID_ERROR, true);
    /* User can add his own implementation to report the HAL error return state
     */
    __disable_irq();
    while (1)
    {
    }
    /* USER CODE END Error_Handler_Debug */
}
#ifdef USE_FULL_ASSERT
/**
 * @brief  Reports the name of the source file and the source line number
 *         where the assert_param error has occurred.
 * @param  file: pointer to the source file name
 * @param  line: assert_param error line source number
 * @retval None
 */
void assert_failed(uint8_t *file, uint32_t line)
{
    /* USER CODE BEGIN 6 */
    /* User can add his own implementation to report the file name and line
       number, ex: printf("Wrong parameters value: file %s on line %d\r\n",
       file, line) */
    /* USER CODE END 6 */
}
#endif /* USE_FULL_ASSERT */
