xiaomiao321/taideng/MCU/software/App/inc/joint_control.h

/**
 * @file joint_control.h
 * @brief 单关节位置闭环：电位器读数换算成角度，驱动电机到目标角度。
 *
 * 角度单位为毫度。标定给出两点（raw_a, angle_a）与（raw_b, angle_b），
 * 读数与角度按直线换算；ADC 读数可以随角度递减。两点可以实测（CAL），
 * 也可以由电位器理论参数加一个实测参考点算出（joint_cal_from_nominal）。
 * 允许运动的范围 [limit_min, limit_max] 与标定点分开设置，
 * 应按机构实际能转的范围设定，避免顶到机械限位。
 * 三种控制方式由 joint_tune_t 选择：开关式（远离目标时持续驱动，接近目标时
 * 改为短脉冲点动）、比例式（占空比 = 起转占空比 + kp × 误差，进入容差和换向
 * 时先短路制动再滑行）和轨迹式（按五次多项式规划位置、速度、加速度都连续的
 * 参考轨迹，用速度前馈、摩擦前馈加 PI 反馈跟踪它，见 joint_traj.h；可设定
 * 可设定单向逼近，三种方式都适用：反向到达时先越过目标再回来，让最后一段
 * 总朝同一个方向走，消除背隙和回程误差）。
 * 进入容差后保持一段时间判定到达；传感器失效、超时、
 * 越限、反向或停滞都会停机并报故障，故障同时锁存为故障位，由
 * joint_clear_faults() 按原因是否消失清除。每次采样还会估计各关节转速。
 *
 * 本模块不依赖 HAL，硬件动作通过 joint_hw_t 回调交给调用者，可在 PC 上测试。
 */

#ifndef AITAID_JOINT_CONTROL_H
#define AITAID_JOINT_CONTROL_H

#include <stdbool.h>
#include <stdint.h>

#include "app_config.h"
#include "joint_traj.h"

/** @brief 关节数量，对应 M1～M6 和电位器 POT1～POT6。 */
#define JOINT_COUNT (6U)

/** @brief 理论标定允许的电位器阻值范围，欧姆。 */
#define JOINT_POT_MIN_OHMS (1000U)
#define JOINT_POT_MAX_OHMS (1000000U)

/** @brief 标定数据序列化格式的版本；格式变化时加一。 */
#define JOINT_CAL_BLOB_VERSION (4U)

/**
 * @brief 序列化后每个关节占用的字节数：28 字节标定、8 字节控制参数、
 *        8 字节单向逼近参数。
 */
#define JOINT_CAL_BLOB_ENTRY_SIZE (44U)

/** @brief 序列化后的总字节数：4 字节头加每个关节一项，是 4 的倍数。 */
#define JOINT_CAL_BLOB_SIZE (4U + JOINT_COUNT * JOINT_CAL_BLOB_ENTRY_SIZE)

/** @brief 旧格式（版本 3，没有单向逼近参数）的总字节数，用于迁移。 */
#define JOINT_CAL_BLOB_V3_SIZE (4U + JOINT_COUNT * 36U)

/** @brief 旧格式（版本 2，只有标定、没有控制参数）的总字节数，用于迁移。 */
#define JOINT_CAL_BLOB_V2_SIZE (4U + JOINT_COUNT * 28U)

/**
 * @brief 锁存的故障位，与 Android 协议 fault_flags 的位定义一致。
 *
 * bit6 底盘故障、bit7 保留，不由关节产生。
 */
#define JOINT_FAULT_STALL (0x01U)     /**< 运动中持续没有进展。 */
#define JOINT_FAULT_TIMEOUT (0x02U)   /**< 超过单次运动期限。 */
#define JOINT_FAULT_DIRECTION (0x04U) /**< 误差持续增大。 */
#define JOINT_FAULT_LIMIT (0x08U)     /**< 超出允许范围。 */
#define JOINT_FAULT_SENSOR (0x10U)    /**< 电位器读数过期、断线或短路。 */
#define JOINT_FAULT_HARDWARE (0x20U)  /**< H 桥输出设置失败。 */

_Static_assert(2U * JOINT_SPEED_EDGE <= JOINT_SPEED_WINDOW,
               "speed window must hold both edge groups");
_Static_assert(JOINT_SPEED_ZERO_MDEG_S < JOINT_SPEED_MOVE_MDEG_S,
               "speed hysteresis needs ZERO below MOVE");

/** @brief 一个关节的标定参数。 */
typedef struct
{
    uint16_t raw_a;     /**< 标定点 A 的 ADC 读数。 */
    uint16_t raw_b;     /**< 标定点 B 的 ADC 读数。 */
    int32_t angle_a;    /**< 标定点 A 的角度，毫度；必须小于 angle_b。 */
    int32_t angle_b;    /**< 标定点 B 的角度，毫度。 */
    int direction;      /**< 电机正转（FI）使角度增大为 +1，减小为 -1。 */
    unsigned duty;      /**< 驱动占空比，千分比。 */
    unsigned tolerance; /**< 到达容差，毫度。 */
    int32_t limit_min;  /**< 允许运动范围下限，毫度。 */
    int32_t limit_max;  /**< 允许运动范围上限，毫度。 */
} joint_cal_t;

/**
 * @brief 理论标定的输入：电位器标称参数加一个实测参考点。
 *
 * 电位器 1:1 装在关节轴上，转过 JOINT_POT_TRAVEL_MDEG 时读数从一端走到
 * 另一端；两端读数由分压电路和阻值算出，参考点确定零位偏移。
 */
typedef struct
{
    uint16_t raw_ref;     /**< 参考位置的 ADC 读数。 */
    int32_t angle_ref;    /**< 参考位置的关节角度，毫度。 */
    int sensor_direction; /**< 角度增大时读数增大为 +1，减小为 -1。 */
    int direction;        /**< 电机正转（FI）使角度增大为 +1，减小为 -1。 */
    unsigned duty;        /**< 驱动占空比，千分比。 */
    unsigned tolerance;   /**< 到达容差，毫度。 */
    int32_t limit_min;    /**< 允许运动范围下限，毫度。 */
    int32_t limit_max;    /**< 允许运动范围上限，毫度。 */
    uint32_t pot_ohms;    /**< 电位器总阻值，欧姆；0 表示采用标称值。 */
} joint_nominal_t;

/** @brief 控制方式。 */
typedef enum
{
    JOINT_MODE_BANG = 0, /**< 开关式：全速接近，近处点动，停止时滑行。 */
    JOINT_MODE_P = 1,    /**< 比例式：起转占空比加比例项，停止时先制动。 */
    JOINT_MODE_TRAJ = 2, /**< 轨迹式：平滑轨迹加前馈和 PI 跟踪，不制动。 */
    JOINT_MODE_COUNT
} joint_mode_t;

/**
 * @brief 控制参数；随标定一起保存到 Flash，没保存过时用比例式默认值。
 *
 * 轨迹式中 kp 是 PI 反馈的比例系数，duty_min 是实测起转占空比，摩擦前馈由它
 * 推出；brake_ms 不使用。
 */
typedef struct
{
    joint_mode_t mode;
    unsigned kp;       /**< 每度误差增加的占空比，千分比/度。 */
    unsigned duty_min; /**< 起转占空比，千分比；不超过 cal.duty。 */
    unsigned brake_ms; /**< 比例式进入容差或换向时的制动时长，0 为不制动。 */
} joint_tune_t;

/**
 * @brief 单向逼近和轨迹式的逐关节参数，上电取 app_config.h 的默认值。
 *
 * approach、backlash、overshoot 对三种控制方式都有效，随标定保存到 Flash；
 * kv 只用于轨迹式，不保存。
 */
typedef struct
{
    int approach;      /**< 最后一段的方向：+1 角度增大，-1 角度减小，0 不限定。 */
    int32_t backlash;  /**< 背隙，毫度；超调量被限位压缩到小于它时放弃单向逼近。 */
    int32_t overshoot; /**< 反向到达时越过目标的量，毫度。 */
    unsigned kv;       /**< 速度前馈，千分比/(度/秒)。 */
} joint_traj_cfg_t;

/** @brief 一次采样最多参与滤波的样本数。 */
#define JOINT_FILTER_MAX_SAMPLES (32U)

/** @brief 关节状态。 */
typedef enum
{
    JOINT_IDLE,
    JOINT_SETTLE, /**< 换向前停顿。 */
    JOINT_MOVING,
    JOINT_DONE,
    JOINT_FAULT,
    JOINT_PHASE_COUNT
} joint_phase_t;

/** @brief 一个关节本次运动的过程状态，只在运动期间有意义。 */
typedef struct
{
    bool active;           /**< 是否正在运动。 */
    int last_sign;         /**< 上一次驱动方向，0 表示刚开始。 */
    unsigned seq;          /**< 启动本次运动的命令序号。 */
    uint32_t start_ms;     /**< 运动开始时刻。 */
    uint32_t progress_ms;  /**< 最近一次误差明显减小的时刻。 */
    uint32_t stable_ms;    /**< 进入容差的时刻。 */
    uint32_t switch_ms;    /**< 最近一次换向的时刻。 */
    uint32_t pulse_ms;     /**< 点动脉冲当前段开始的时刻。 */
    uint32_t brake_ms;     /**< 本次制动开始的时刻。 */
    uint32_t timeout_ms;   /**< 本次运动的超时。 */
    int32_t initial_error; /**< 开始时的误差绝对值。 */
    int32_t best_error;    /**< 运动中达到过的最小误差。 */
    bool stable;           /**< 是否处于容差内。 */
    bool pulse_on;         /**< 点动脉冲是否处于驱动段。 */
    bool near_mode;        /**< 是否已进入接近目标的点动模式。 */
    bool braking;          /**< 是否正在短路制动。 */
    /* 以下只在轨迹式中使用。 */
    joint_traj_t seg[2];    /**< 轨迹段：单向逼近反向到达时为两段。 */
    unsigned seg_count;     /**< 轨迹段数，1 或 2。 */
    unsigned seg_index;     /**< 当前段下标。 */
    uint32_t seg_ms;        /**< 当前段开始的时刻。 */
    int32_t seg_angle;      /**< 当前段开始时的实际角度，用于判断方向错误。 */
    int32_t ref;            /**< 当前参考位置，毫度。 */
    int32_t ref_speed;      /**< 当前参考速度，毫度/秒；进入容差后为 0。 */
    /* 以下只在比例式和开关式中使用。 */
    int32_t goal;           /**< 当前这一段要去的角度：中间点或目标，毫度。 */
    bool via_pending;       /**< 单向逼近时是否还在去中间点的路上。 */
    float integral;         /**< PI 积分项，千分比。 */
    uint32_t tick_ms;       /**< 上一次控制的时刻，用于积分。 */
} joint_motion_t;

/** @brief 转速估计用的最近若干次角度采样，环形缓冲。 */
typedef struct
{
    int32_t angle[JOINT_SPEED_WINDOW]; /**< 角度，毫度。 */
    uint32_t ms[JOINT_SPEED_WINDOW];   /**< 采样时刻。 */
    unsigned head;                     /**< 下一次写入的位置。 */
    unsigned count;                    /**< 已有的连续有效样本数。 */
    bool moving;                       /**< 迟滞判定的当前结果。 */
} joint_speed_t;

/** @brief 单个关节的运行状态。 */
typedef struct
{
    joint_cal_t cal;
    bool calibrated;
    uint16_t raw;    /**< 最近一次 ADC 读数。 */
    int32_t angle;   /**< 最近一次换算角度，毫度。 */
    int32_t target;  /**< 目标角度，毫度。 */
    int duty;        /**< 当前输出占空比。 */
    uint16_t spread; /**< 最近一次采样中各样本的极差，反映噪声。 */
    joint_tune_t tune;
    joint_traj_cfg_t traj;
    joint_phase_t phase;
    const char *fault; /**< 最近一次故障名，没有故障时为 "NONE"。 */
    uint8_t faults;    /**< 锁存的故障位，见 JOINT_FAULT_*。 */
    /** @brief 估计转速，毫度/秒；判定为静止或样本不足时为 0。 */
    int32_t speed;
    joint_speed_t est;
    /** @brief target 是否有意义；上电恢复标定时角度未知，首次采样后补上。 */
    bool has_target;
    joint_motion_t motion;
} joint_state_t;

/** @brief 调用者提供的硬件回调。 */
typedef struct
{
    /** @brief 驱动关节电机；index 为 0 起的关节下标。 */
    bool (*drive)(unsigned index, int duty);
    /** @brief 发送一行回复，内容已含 CRLF。 */
    void (*reply)(const char *line);
    /** @brief 短路制动；可为 NULL，此时制动改为滑行。 */
    bool (*brake)(unsigned index);
} joint_hw_t;

/**
 * @brief 全部关节的控制状态。各关节可同时运动、互不影响。调用者只读。
 */
typedef struct
{
    joint_hw_t hw;
    joint_state_t states[JOINT_COUNT];
    uint32_t sample_ms; /**< 最近一次有效采样的时刻。 */
    bool valid;         /**< 最近一次采样是否有效。 */
} joint_control_t;

/** @brief 初始化：全部关节未标定、空闲。 */
void joint_init(joint_control_t *j, joint_hw_t hw);

/** @brief 标定参数是否合法。 */
bool joint_cal_valid(const joint_cal_t *c);

/** @brief 按标定把 ADC 读数换算成角度，毫度。 */
int32_t joint_angle(const joint_cal_t *c, uint16_t raw);

/** @brief 是否有任一关节正在运动。 */
bool joint_any_active(const joint_control_t *j);

/** @brief 写入标定；返回 NULL 表示成功，否则为错误名（该关节运动中为 BUSY）。 */
const char *joint_calibrate(joint_control_t *j, unsigned index, joint_cal_t c);

/**
 * @brief 由理论参数算出两点标定。
 *
 * 两个标定点取在允许范围的两端，读数按分压公式计算。
 *
 * @param[out] out 成功时写入完整的标定参数。
 * @return NULL 表示成功；参数无效、参考点或允许范围超出电位器电气行程时
 *         返回 "CAL_PARAM"。
 */
const char *joint_cal_from_nominal(const joint_nominal_t *n, joint_cal_t *out);

/**
 * @brief 只修改已标定关节的允许运动范围，不改换算关系。
 *
 * @return NULL 表示成功；"NOT_CALIBRATED"、"BUSY"（该关节在运动）或
 *         "LIMIT_PARAM"（范围无效或超出电位器可测区间）。
 */
const char *joint_set_limits(joint_control_t *j, unsigned index,
                             int32_t limit_min, int32_t limit_max);

/**
 * @brief 三点中值，用于在时间上去掉单次采样的尖峰。
 */
uint16_t joint_median3(uint16_t a, uint16_t b, uint16_t c);

/**
 * @brief 设置控制参数；不要求已标定。
 *
 * @return NULL 表示成功；"JOINT_ID"、"BUSY" 或 "TUNE_PARAM"。
 */
const char *joint_set_tune(joint_control_t *j, unsigned index,
                           joint_tune_t tune);

/**
 * @brief 设置单向逼近和轨迹式的逐关节参数；不要求已标定。
 *
 * @return NULL 表示成功；"JOINT_ID"、"BUSY" 或 "TUNE_PARAM"（方向不是 -1、0、1，
 *         背隙或超调量为负或超过 30°，或超调量小于背隙）。
 */
const char *joint_set_traj(joint_control_t *j, unsigned index,
                           joint_traj_cfg_t cfg);

/**
 * @brief 设置闭环的最高占空比，即标定里的 cal.duty；两种控制方式都受它限制。
 *
 * @return NULL 表示成功；"JOINT_ID"、"NOT_CALIBRATED"、"BUSY" 或
 *         "TUNE_PARAM"。
 */
const char *joint_set_duty_max(joint_control_t *j, unsigned index,
                               unsigned duty);

/**
 * @brief 把多次扫描的读数合成一组：每路去掉最大、最小各四分之一后取平均。
 *
 * @param[in] samples count 组读数，每组 JOINT_COUNT 个。
 * @param[in] count 样本组数，1 至 JOINT_FILTER_MAX_SAMPLES。
 * @param[out] out 滤波结果。
 * @param[out] spread 每路样本的极差（最大减最小）。
 */
void joint_filter(const uint16_t (*samples)[JOINT_COUNT], unsigned count,
                  uint16_t out[JOINT_COUNT], uint16_t spread[JOINT_COUNT]);

/**
 * @brief 启动一次运动；返回 NULL 表示已接受，否则为错误名。
 *
 * 其他关节的运动不受影响。该关节已在运动时，新目标替代旧目标：旧命令回报
 * JRESULT ... SUPERSEDED，驱动方向和制动状态沿用，进度、超时等重新计算。
 * 轨迹式从当前参考状态接着规划，速度和加速度不突变。
 */
const char *joint_move(joint_control_t *j, unsigned seq, unsigned index,
                       int32_t target, uint32_t timeout, uint32_t now);

/**
 * @brief 同 joint_move，另给本次运动的速度上限，毫度/秒。
 *
 * 只对轨迹式有效：取它和 JOINT_TRAJ_VMAX_MDEG_S 中较小的一个，0 表示用后者。
 * 规划出的时长加上到位判定时间超过 timeout 时返回 "TOO_SLOW"，不启动运动。
 */
const char *joint_move_speed(joint_control_t *j, unsigned seq, unsigned index,
                             int32_t target, uint32_t timeout, int32_t speed,
                             uint32_t now);

/**
 * @brief 当前参考位置，毫度：轨迹式运动中为轨迹上的参考点，其他方式运动中为
 *        这一段要去的角度（单向逼近时先是中间点），停止时为目标。
 */
int32_t joint_reference(const joint_state_t *s);

/**
 * @brief 输入一组采样。
 *
 * @param[in] raw JOINT_COUNT 个 ADC 读数。
 * @param[in] spread JOINT_COUNT 个样本极差；可为 NULL，记为 0。
 * @param[in] valid 本次采样是否成功；失败时不更新读数。
 */
void joint_feed(joint_control_t *j, const uint16_t *raw, const uint16_t *spread,
                bool valid, uint32_t now);

/**
 * @brief 周期调用：推进全部运动中关节的控制。
 *
 * @retval false 本次调用中有关节产生了新的控制故障（该关节已停止，
 *         其他关节照常运动，是否全部停机由调用者决定）。
 */
bool joint_tick(joint_control_t *j, uint32_t now);

/** @brief 取消全部关节的运动并停机；返回 false 表示停机时硬件失败。 */
bool joint_cancel(joint_control_t *j);

/** @brief 全部关节锁存故障位的按位或。 */
uint8_t joint_fault_flags(const joint_control_t *j);

/**
 * @brief 清除原因已消失的锁存故障，供 STOP 调用；调用前应已停止全部关节。
 *
 * 停滞、超时、方向错误随运动结束而消失，直接清除；电位器读数仍无效时保留
 * 传感器位，角度仍在允许范围外时保留越限位，再次停机仍失败时保留驱动位。
 * 某关节故障位全部清除后回到空闲阶段。
 */
void joint_clear_faults(joint_control_t *j, uint32_t now);

/** @brief 阶段的短名称，用于状态上报。 */
const char *joint_phase_name(joint_phase_t phase);

/**
 * @brief 把全部关节的标定导出为定长字节串，用于断电保存。
 *
 * 格式（多字节均为小端）：
 *   头：版本 u8、关节数 u8、保留 u16；
 *   每个关节：已标定 u8、方向 i8、占空比 u16、raw_a u16、raw_b u16、
 *            angle_a i32、angle_b i32、容差 u32、limit_min i32、limit_max i32，
 *            控制参数有效 u8、控制方式 u8、kp u16、起转占空比 u16、制动 u16，
 *            逼近参数有效 u8、逼近方向 i8、保留 u16、背隙 u16、超调量 u16。
 * 版本 3 没有最后 8 字节，版本 2 没有最后 16 字节，其余相同。
 */
void joint_cal_export(const joint_control_t *j,
                      uint8_t blob[JOINT_CAL_BLOB_SIZE]);

/**
 * @brief 从 joint_cal_export() 的结果恢复标定和控制参数。
 *
 * 接受版本 4（size 为 JOINT_CAL_BLOB_SIZE）、版本 3（size 为
 * JOINT_CAL_BLOB_V3_SIZE，没有逼近参数）和版本 2（size 为
 * JOINT_CAL_BLOB_V2_SIZE，只有标定）。版本、长度或关节数不符时什么都不做；
 * 每个关节的参数仍经 joint_calibrate()、joint_set_tune() 校验，不合法的项
 * 被跳过，未标记的关节保持原状。
 *
 * @return 成功恢复标定的关节数。
 * @note 只应在没有关节运动时调用（如初始化阶段）；运动中的关节被跳过。
 */
unsigned joint_cal_import(joint_control_t *j, const uint8_t *blob,
                          uint32_t size);

#endif /* AITAID_JOINT_CONTROL_H */
