xiaomiao321/taideng/MCU/software/BSP/Inc/bsp_buzzer.h

/**
 * @file bsp_buzzer.h
 * @brief 蜂鸣器板级支持包接口。
 *
 * 蜂鸣器由 TIM13_CH1 输出 PWM 驱动。调用本模块前，必须先完成
 * MX_TIM13_Init()。本模块只负责蜂鸣器的启停，不包含阻塞延时。
 */

#ifndef AITAID_BSP_BUZZER_H
#define AITAID_BSP_BUZZER_H

#include "bsp_common.h"

#include <stdbool.h>
#include <stdint.h>

/**
 * @brief 初始化蜂鸣器 BSP，并确保蜂鸣器处于关闭状态。
 *
 * @note 调用本函数前，必须先调用 MX_TIM13_Init()。
 *
 * @return bsp_status_t 初始化结果。
 * @retval BSP_OK 初始化成功。
 * @retval BSP_ERR_CONFIG 定时器句柄未绑定 TIM13。
 */
bsp_status_t bsp_buzzer_init(void);

/**
 * @brief 以指定频率启动蜂鸣器 PWM 输出。
 *
 * PWM 占空比固定为 50%。蜂鸣器在约 2.7 kHz 时通常声音最响，其他频率
 * 的音量可能有所下降。
 *
 * @param[in] frequency_hz 目标频率，单位为 Hz。
 *
 * @return bsp_status_t 启动结果。
 * @retval BSP_OK 启动成功。
 * @retval BSP_ERR_NOT_INITIALIZED BSP 未初始化。
 * @retval BSP_ERR_PARAM 频率为 0 或无法由定时器产生。
 * @retval BSP_ERR_HAL PWM 装载或启动失败。
 */
bsp_status_t bsp_buzzer_start(uint32_t frequency_hz);

/**
 * @brief 以指定频率和占空比启动蜂鸣器 PWM 输出，用占空比调节音量。
 *
 * 占空比越接近 50% 越响，越小越轻；两者不是线性关系。
 *
 * @param[in] frequency_hz 目标频率，单位为 Hz。
 * @param[in] duty_permille 占空比千分比，1 至 500。
 *
 * @return bsp_status_t 启动结果，同 bsp_buzzer_start()；占空比超出范围时
 *         返回 BSP_ERR_PARAM。
 */
bsp_status_t bsp_buzzer_start_duty(uint32_t frequency_hz,
                                   uint16_t duty_permille);

/**
 * @brief 停止蜂鸣器 PWM 输出。
 *
 * 重复调用本函数不会重复停止定时器，并返回成功。
 *
 * @return bsp_status_t 停止结果。
 * @retval BSP_OK 停止成功或蜂鸣器已经停止。
 * @retval BSP_ERR_NOT_INITIALIZED BSP 未初始化。
 * @retval BSP_ERR_HAL PWM 停止失败。
 */
bsp_status_t bsp_buzzer_stop(void);

#endif /* AITAID_BSP_BUZZER_H */
