xiaomiao321/taideng/MCU/software/BSP/Src/bsp_buzzer.c

#include "bsp_buzzer.h"

#include <stdbool.h>

#include "stm32f407xx.h"
#include "tim.h"

static bool s_is_buzzer_initialized = false;
static bool s_is_buzzer_active = false;

bsp_status_t bsp_buzzer_init(void)
{
    if (s_is_buzzer_initialized)
    {
        return BSP_OK;
    }
    if (htim13.Instance != TIM13)
    {
        return BSP_ERR_CONFIG;
    }
    __HAL_TIM_SET_COMPARE(&htim13, TIM_CHANNEL_1, 0U);
    s_is_buzzer_initialized = true;
    return BSP_OK;
}

bsp_status_t bsp_buzzer_start(uint32_t frequency_hz)
{
    return bsp_buzzer_start_duty(frequency_hz, 500U);
}

bsp_status_t bsp_buzzer_start_duty(uint32_t frequency_hz,
                                   uint16_t duty_permille)
{
    if ((frequency_hz == 0U) || (duty_permille == 0U) ||
        (duty_permille > 500U))
    {
        return BSP_ERR_PARAM;
    }
    if (s_is_buzzer_initialized == false)
    {
        return BSP_ERR_NOT_INITIALIZED;
    }

    /* APB1 分频不为 1 时，APB1 定时器时钟是 PCLK1 的两倍（RM0090 RCC 章节）。 */
    uint32_t timer_clock_hz = HAL_RCC_GetPCLK1Freq();
    if ((RCC->CFGR & RCC_CFGR_PPRE1) != RCC_CFGR_PPRE1_DIV1)
    {
        timer_clock_hz *= 2U;
    }
    uint32_t prescaler = htim13.Init.Prescaler + 1U;
    uint32_t timer_counter_hz = timer_clock_hz / prescaler;
    uint32_t period_counts = timer_counter_hz / frequency_hz;

    if ((period_counts < 2U) || (period_counts > 65536U))
    {
        return BSP_ERR_PARAM;
    }

    uint32_t arr = period_counts - 1U;
    uint32_t compare = (period_counts * duty_permille) / 1000U;
    if (compare == 0U)
    {
        compare = 1U;
    }
    if (arr > 0xFFFFU)
    {
        return BSP_ERR_PARAM;
    }

    __HAL_TIM_SET_AUTORELOAD(&htim13, arr);
    __HAL_TIM_SET_COMPARE(&htim13, TIM_CHANNEL_1, compare);
    __HAL_TIM_SET_COUNTER(&htim13, 0U);
    if (HAL_TIM_GenerateEvent(&htim13, TIM_EVENTSOURCE_UPDATE) !=
        HAL_OK) /*使 ARR 和 CCR 的新值立即生效*/
    {
        __HAL_TIM_SET_COMPARE(&htim13, TIM_CHANNEL_1, 0U);
        return BSP_ERR_HAL;
    }

    /* 已经运行，不需要再次启动 */
    if (s_is_buzzer_active)
    {
        return BSP_OK;
    }
    /* 尚未运行，启动PWM输出*/
    if (HAL_TIM_PWM_Start(&htim13, TIM_CHANNEL_1) != HAL_OK)
    {
        __HAL_TIM_SET_COMPARE(&htim13, TIM_CHANNEL_1, 0U);
        return BSP_ERR_HAL;
    }
    s_is_buzzer_active = true;
    return BSP_OK;
}

bsp_status_t bsp_buzzer_stop(void)
{
    if (s_is_buzzer_initialized == false)
    {
        return BSP_ERR_NOT_INITIALIZED;
    }
    if (!s_is_buzzer_active)
    {
        return BSP_OK;
    }
    if (HAL_TIM_PWM_Stop(&htim13, TIM_CHANNEL_1) != HAL_OK)
    {
        return BSP_ERR_HAL;
    }
    __HAL_TIM_SET_COMPARE(&htim13, TIM_CHANNEL_1, 0U);
    s_is_buzzer_active = false;

    return BSP_OK;
}
