xiaomiao321/taideng/MCU/software/HostTest/debug_control_selftest.c

#include "debug_control.h"
#include "motor_limits.h"
#include <assert.h>
#include <stdio.h>
#include <string.h>

static unsigned running_motor, stops;
static int running_duty;
static bool stop_ok = true, run_ok = true;
static int outputs[MOTOR_COUNT];
static unsigned manual_calls;
static char reply[128];
static unsigned test_calls, confirm_calls;
static unsigned joint_calls;
static unsigned aux_calls;
static const char *hw_aux(const char *op, const char *const *args,
                          unsigned count)
{
    assert(!strcmp(op, "MPWM") && count == 2 && !strcmp(args[0], "5") &&
           !strcmp(args[1], "1"));
    ++aux_calls;
    return NULL;
}
static const char *hw_joint(const char *op, unsigned seq, unsigned id,
                            const int32_t *v, unsigned count, uint32_t now)
{
    (void)seq;
    (void)now;
    assert(id == 0);
    if (!strcmp(op, "CAL"))
    {
        assert(count == 7 && v[0] == 600 && v[1] == -30000 && v[6] == 2000);
    }
    else if (!strcmp(op, "JMOVE"))
    {
        assert(count == 2 && v[0] == 45000 && v[1] == 10000);
    }
    else if (!strcmp(op, "JNOM"))
    {
        assert(count == 9 && v[0] == 2048 && v[1] == 90000 && v[2] == -1 &&
               v[6] == 10000 && v[7] == 170000 && v[8] == 47000);
    }
    else if (!strcmp(op, "JLIM"))
    {
        assert(count == 2 && v[0] == -5000 && v[1] == 120000);
    }
    else if (!strcmp(op, "JTUNE"))
    {
        assert((count == 4 || (count == 5 && v[4] == 700)) && v[0] == 1 &&
               v[1] == 30 && v[2] == 300 && v[3] == 50);
    }
    else if (!strcmp(op, "JTRACE"))
    {
        assert(count == 1 && v[0] == 1);
    }
    else if (!strcmp(op, "JDIR"))
    {
        assert(count == 3 && v[0] == 1 && v[1] == 1500 && v[2] == 4000);
    }
    else
    {
        assert(!strcmp(op, "JGET") && count == 0);
    }
    ++joint_calls;
    return NULL;
}
static const char *hw_test(unsigned seq, const char *name, int value,
                           uint32_t duration)
{
    assert(running_motor == 0);
    assert(seq == 20 && !strcmp(name, "BUZZER") && value == 2700 &&
           duration == 500);
    ++test_calls;
    return NULL;
}
static const char *hw_confirm(bool pass)
{
    assert(pass);
    ++confirm_calls;
    return NULL;
}
static bool hw_stop(void)
{
    ++stops;
    running_motor = 0;
    running_duty = 0;
    memset(outputs, 0, sizeof(outputs));
    return stop_ok;
}
/* run() 收到的是 0 起的下标；running_motor 记成 M 编号，0 表示没有电机在转。 */
static bool hw_run(unsigned index, int duty)
{
    assert(index < MOTOR_COUNT);
    running_motor = index + 1U;
    running_duty = duty;
    outputs[index] = duty;
    return run_ok;
}
static bool hw_manual(void)
{
    ++manual_calls;
    return true;
}
static void hw_reply(const char *s)
{
    snprintf(reply, sizeof(reply), "%s", s);
}
static debug_control_t fresh(uint32_t now)
{
    debug_control_t c;
    debug_hw_t hw = {.stop = hw_stop, .run = hw_run, .reply = hw_reply};
    stop_ok = true;
    run_ok = true;
    debug_control_init(&c, hw);
    debug_control_line(&c, "PING 1", now);
    return c;
}
int main(void)
{
    debug_control_t multi = fresh(0);
    multi.hw.manual = hw_manual;
    debug_control_line(&multi,
                       "MSET 10 255 500 -600 700 -800 900 -1000 800 -800 500 "
                       "600 700 800 900 1000 0 0",
                       0);
    assert(multi.multi_pending == 255 && manual_calls == 1);
    debug_control_update(&multi, 99, false);
    assert(!outputs[0] && !outputs[7]);
    debug_control_update(&multi, 100, false);
    assert(outputs[0] == 500 && outputs[1] == -600 && outputs[5] == -1000 &&
           outputs[7] == -800);
    debug_control_line(&multi, "MSET 11 2 0 0 0 0 0 0 0 0 0 0 0 0 0 0 0 0",
                       200);
    assert(outputs[0] == 500 && outputs[1] == 0 && outputs[7] == -800);
    unsigned before = manual_calls;
    debug_control_line(&multi, "MSET 12 1 99 0 0 0 0 0 0 0 0 0 0 0 0 0 0 0",
                       210);
    assert(strstr(reply, "DUTY_RANGE") && manual_calls == before &&
           outputs[0] == 500);
    debug_control_line(&multi, "MSET 12 1 -800 0 0 0 0 0 0 0 200 0 0 0 0 0 0 0",
                       220);
    assert(!outputs[0] && outputs[2] == 700);
    debug_control_update(&multi, 319, false);
    assert(!outputs[0]);
    debug_control_update(&multi, 320, false);
    assert(outputs[0] == -800);
    debug_control_update(&multi, 520, false);
    assert(!outputs[0] && outputs[2] == 700);
    debug_control_update(&multi, 800, false);
    assert(!outputs[2] && outputs[3] == -800 && outputs[7] == -800);
    debug_control_update(&multi, 1000, false);
    assert(multi.locked && !outputs[7] && !multi.multi_pending);
    debug_control_line(&multi, "MOFF 13", 1001);
    assert(strstr(reply, "ACK") && multi.locked);
    multi = fresh(UINT32_MAX - 150);
    multi.hw.manual = hw_manual;
    debug_control_line(&multi,
                       "MSET 14 128 0 0 0 0 0 0 0 -800 0 0 0 0 0 0 0 200",
                       UINT32_MAX - 150);
    debug_control_update(&multi, UINT32_MAX - 50, false);
    assert(outputs[7] == -800);
    debug_control_update(&multi, 149, false);
    assert(!outputs[7]);
    multi = fresh(0);
    multi.hw.manual = hw_manual;
    debug_control_line(
        &multi, "MSET 15 255 800 800 800 800 800 800 800 800 0 0 0 0 0 0 0 0",
        0);
    debug_control_update(&multi, 100, false);
    assert(outputs[0] && outputs[7]);
    debug_control_update(&multi, 110, true);
    assert(!outputs[0] && !outputs[7] && multi.locked);
    multi = fresh(0);
    multi.hw.manual = hw_manual;
    debug_control_line(
        &multi, "MSET 15 255 800 800 800 800 800 800 800 800 0 0 0 0 0 0 0 0",
        0);
    run_ok = false;
    debug_control_update(&multi, 100, false);
    assert(multi.locked && !outputs[0] && !outputs[7]);
    for (unsigned index = 0; index < MOTOR_COUNT; ++index)
    {
        int max = index < 6U ? 1000 : 800;
        assert(motor_duty_valid(index, 0));
        assert(motor_duty_valid(index, 100) && motor_duty_valid(index, -100));
        assert(motor_duty_valid(index, max) && motor_duty_valid(index, -max));
        assert(!motor_duty_valid(index, 99) && !motor_duty_valid(index, -99));
        assert(!motor_duty_valid(index, max + 1) &&
               !motor_duty_valid(index, -max - 1));
    }
    assert(!motor_duty_valid(MOTOR_COUNT, 0));
    /* 以下安全规则用 MSET 验证：M1 单路，800‰，持续运行。 */
    const char *m1_on = "MSET 2 1 800 0 0 0 0 0 0 0 0 0 0 0 0 0 0 0";
    debug_control_t c = fresh(0);
    c.hw.manual = hw_manual;
    debug_control_line(&c, m1_on, 0);
    debug_control_update(&c, 100, false);
    assert(outputs[0] == 800);
    /* HOME 按下停机并锁定；HOME 未松开时 STOP 不解锁。 */
    debug_control_update(&c, 110, true);
    assert(c.locked && !outputs[0] && !c.multi_pending);
    debug_control_line(&c, m1_on, 111);
    assert(strstr(reply, "LOCKED"));
    debug_control_line(&c, "STOP 5 ALL", 112);
    assert(c.locked && strstr(reply, "STOP_LOCKED"));
    debug_control_update(&c, 120, false);
    debug_control_line(&c, "STOP 6 ALL", 121);
    assert(!c.locked && strstr(reply, "ACK 6 STOP"));

    /* 心跳超时停机锁定；恢复心跳后仍需 STOP 解锁。 */
    c = fresh(0);
    c.hw.manual = hw_manual;
    debug_control_line(&c, m1_on, 0);
    debug_control_update(&c, 100, false);
    debug_control_update(&c, 1000, false);
    assert(c.locked && !outputs[0] && !c.linked);
    debug_control_line(&c, "PING 3", 1010);
    debug_control_line(&c, m1_on, 1011);
    assert(strstr(reply, "LOCKED") && !c.multi_pending);
    debug_control_line(&c, "STOP 5 ALL", 1012);
    assert(!c.locked);

    const char *bad[] = {
        "MSET 2 0 800 0 0 0 0 0 0 0 0 0 0 0 0 0 0 0",
        "MSET 2 256 800 0 0 0 0 0 0 0 0 0 0 0 0 0 0 0",
        "MSET 2 1 1001 0 0 0 0 0 0 0 0 0 0 0 0 0 0 0",
        "MSET 2 1 800 0 0 0 0 0 0 0 -1 0 0 0 0 0 0 0",
        "MSET 2 1 800 0 0 0 0 0 0 0 60001 0 0 0 0 0 0 0",
        "MSET 2 1 80x 0 0 0 0 0 0 0 0 0 0 0 0 0 0 0",
        "MSET 2 1 +800 0 0 0 0 0 0 0 0 0 0 0 0 0 0 0",
        "MSET 2 1 800 0 0 0 0 0 0 0 0 0 0 0 0 0 0",
        "MSET 2 1 800 0 0 0 0 0 0 0 0 0 0 0 0 0 0 0 0",
        "MSET 2 64 0 0 0 0 0 0 801 0 0 0 0 0 0 0 0 0",
        "MSET 65536 1 800 0 0 0 0 0 0 0 0 0 0 0 0 0 0 0",
        "MSET 2 1 99999999999999999999999 0 0 0 0 0 0 0 0 0 0 0 0 0 0 0",
        "RUN 2 M1 800 500",
        "PING 3 extra",
        "MSET"};
    for (unsigned i = 0; i < sizeof(bad) / sizeof(bad[0]); ++i)
    {
        c = fresh(0);
        c.hw.manual = hw_manual;
        debug_control_line(&c, bad[i], 1);
        assert(!c.multi_pending && !strncmp(reply, "ERR", 3));
    }
    c = fresh(0);
    c.hw.manual = hw_manual;
    debug_control_line(&c, m1_on, 1000);
    assert(strstr(reply, "NO_HEARTBEAT") && !c.multi_pending);
    /* 故障停机会取消还在等待启动的电机。 */
    c = fresh(0);
    c.hw.manual = hw_manual;
    debug_control_line(&c, m1_on, 0);
    debug_control_fault(&c, "EVENT UART_ERROR\r\n");
    debug_control_update(&c, 100, false);
    assert(!c.multi_pending && !outputs[0] && c.locked);
    c = fresh(0);
    c.hw.test = hw_test;
    c.hw.confirm = hw_confirm;
    debug_control_line(&c, "INFO 10", 1);
    assert(strstr(reply, "CAPS BOARD_TEST 2"));
    c.hw.manual = hw_manual;
    debug_control_line(&c, m1_on, 2);
    debug_control_update(&c, 102, false);
    assert(running_motor == 1);
    /* TEST 先停掉手动输出。 */
    debug_control_line(&c, "TEST 20 BUZZER 2700 500", 103);
    assert(test_calls == 1 && !c.multi_duty[0] && running_motor == 0);
    assert(strstr(reply, "ACK 20 TEST"));
    debug_control_line(&c, "CONFIRM 21 PASS", 104);
    assert(confirm_calls == 1);
    c.locked = true;
    debug_control_line(&c, "TEST 20 BUZZER 2700 500", 105);
    assert(test_calls == 1 && strstr(reply, "LOCKED"));
    debug_control_line(&c, "CONFIRM 21 PASS", 106);
    assert(confirm_calls == 1 && strstr(reply, "LOCKED"));
    c.locked = false;
    c.home = true;
    debug_control_line(&c, "TEST 20 BUZZER 2700 500", 107);
    assert(test_calls == 1 && strstr(reply, "LOCKED"));
    c.home = false;
    debug_control_line(&c, "TEST 20 BUZZER 2700 500", 1000);
    assert(test_calls == 1 && strstr(reply, "NO_HEARTBEAT"));
    debug_control_line(&c, "PING 22", 1100);
    debug_control_line(&c, "TEST 20 BUZZER 2700 0", 1101);
    assert(test_calls == 1 && strstr(reply, "PARAM"));
    debug_control_line(&c, "CONFIRM 21 OTHER", 1102);
    assert(confirm_calls == 1 && strstr(reply, "PARAM"));
    c = fresh(0);
    c.hw.joint = hw_joint;
    debug_control_line(&c, "INFO 30", 0);
    assert(strstr(reply, "CAPS JOINT 1"));
    debug_control_line(&c, "CAL 31 M1 600 -30000 3400 90000 1 800 2000", 1);
    assert(joint_calls == 1 && strstr(reply, "ACK 31 CAL"));
    debug_control_line(&c, "JMOVE 32 M1 45000 10000", 2);
    assert(joint_calls == 2 && strstr(reply, "ACK 32 JMOVE"));
    c.locked = true;
    debug_control_line(&c, "JMOVE 33 M1 45000 10000", 3);
    assert(joint_calls == 2 && strstr(reply, "LOCKED"));
    c.linked = false;
    debug_control_line(&c, "JGET 34 M1", 4);
    assert(joint_calls == 3);
    c.locked = false;
    debug_control_line(&c, "JMOVE 35 M1 45000 10000", 5);
    assert(joint_calls == 3 && strstr(reply, "NO_HEARTBEAT"));
    debug_control_line(&c, "JGET 36 M7", 6);
    assert(joint_calls == 3 && strstr(reply, "JOINT_PARAM"));
    debug_control_line(&c, "CAL 37 M1 600 -30000 3400 90000 1 800 2000 extra",
                       7);
    assert(joint_calls == 3 && strstr(reply, "JOINT_PARAM"));
    /* 缺少关节名的命令不能读越界字段。 */
    debug_control_line(&c, "JGET 38", 8);
    assert(joint_calls == 3 && strstr(reply, "JOINT_PARAM"));
    assert(strstr(reply, "ERR 38"));
    /* 理论标定与修改允许范围：阻值参数可超过角度参数的上限。 */
    debug_control_line(&c, "PING 39", 9);
    debug_control_line(
        &c, "JNOM 40 M1 2048 90000 -1 1 800 2000 10000 170000 47000", 10);
    assert(joint_calls == 4 && strstr(reply, "ACK 40 JNOM"));
    debug_control_line(
        &c, "JNOM 41 M1 2048 90000 -1 1 800 2000 10000 170000 1000001", 11);
    assert(joint_calls == 4 && strstr(reply, "JOINT_PARAM"));
    debug_control_line(&c, "JNOM 42 M1 2048 90000 -1 1 800 2000 10000", 12);
    assert(joint_calls == 4 && strstr(reply, "JOINT_PARAM"));
    debug_control_line(&c, "JLIM 43 M1 -5000 120000", 13);
    assert(joint_calls == 5 && strstr(reply, "ACK 43 JLIM"));
    c.locked = true;
    debug_control_line(&c, "JLIM 44 M1 -5000 120000", 14);
    assert(joint_calls == 5 && strstr(reply, "LOCKED"));
    c.locked = false;
    debug_control_line(&c, "INFO 45", 15);
    assert(strstr(reply, "CAPS JOINT_NOMINAL 1"));
    assert(strstr(reply, "CAPS TRACE 1"));
    /* JTUNE 要心跳并先停机；JTRACE 只读，不要心跳也不停机。 */
    unsigned stops_before = stops;
    debug_control_line(&c, "JTUNE 46 M1 1 30 300 50", 16);
    assert(joint_calls == 6 && strstr(reply, "ACK 46 JTUNE") &&
           stops == stops_before + 1);
    debug_control_line(&c, "JTUNE 47 M1 1 30 300", 17);
    assert(joint_calls == 6 && strstr(reply, "JOINT_PARAM"));
    /* 第 5 个参数为可选的最高占空比，再多就是格式错误。 */
    debug_control_line(&c, "JTUNE 147 M1 1 30 300 50 700 1", 17);
    assert(joint_calls == 6 && strstr(reply, "JOINT_PARAM"));
    debug_control_line(&c, "JTUNE 148 M1 1 30 300 50 700", 17);
    assert(joint_calls == 7 && strstr(reply, "ACK 148 JTUNE"));
    /* JDIR：方向、背隙、超调量三个参数，和 JTUNE 一样要心跳并先停机。 */
    stops_before = stops;
    debug_control_line(&c, "JDIR 149 M1 1 1500 4000", 17);
    assert(joint_calls == 8 && strstr(reply, "ACK 149 JDIR") &&
           stops == stops_before + 1);
    debug_control_line(&c, "JDIR 150 M1 1 1500", 17);
    assert(joint_calls == 8 && strstr(reply, "JOINT_PARAM"));
    c.linked = false;
    stops_before = stops;
    debug_control_line(&c, "JTRACE 48 M1 1", 18);
    assert(joint_calls == 9 && strstr(reply, "ACK 48 JTRACE") &&
           stops == stops_before);
    debug_control_line(&c, "JTUNE 49 M1 1 30 300 50", 19);
    assert(joint_calls == 9 && strstr(reply, "NO_HEARTBEAT"));
    debug_control_line(&c, "JDIR 151 M1 1 1500 4000", 19);
    assert(joint_calls == 9 && strstr(reply, "NO_HEARTBEAT"));
    /* MPWM 交给 aux，与 LSET 一样要心跳。 */
    c.hw.aux = hw_aux;
    debug_control_line(&c, "MPWM 50 5 1", 20);
    assert(aux_calls == 0 && strstr(reply, "NO_HEARTBEAT"));
    debug_control_line(&c, "PING 51", 21);
    debug_control_line(&c, "MPWM 52 5 1", 22);
    assert(aux_calls == 1 && strstr(reply, "ACK 52 MPWM"));
    debug_control_line(&c, "INFO 53", 23);
    assert(strstr(reply, "CAPS MOTOR_PWM 1"));
    /* JMOVE 不打断其他关节：没有手动控制占用电机时不停机。 */
    stops_before = stops;
    unsigned calls_before = joint_calls;
    debug_control_line(&c, "JMOVE 54 M1 45000 10000", 24);
    debug_control_line(&c, "JMOVE 55 M1 45000 10000", 25);
    assert(joint_calls == calls_before + 2 && stops == stops_before &&
           strstr(reply, "ACK 55 JMOVE"));
    /* 多路手动占用电机时，JMOVE 先全部停下再接管。 */
    c.hw.manual = hw_manual;
    debug_control_line(&c, "MSET 56 2 0 800 0 0 0 0 0 0 0 0 0 0 0 0 0 0", 26);
    debug_control_update(&c, 126, false);
    assert(c.multi_duty[1] == 800);
    stops_before = stops;
    debug_control_line(&c, "JMOVE 57 M1 45000 10000", 27);
    assert(stops == stops_before + 1 && !c.multi_duty[1] &&
           strstr(reply, "ACK 57 JMOVE"));
    printf("debug control: motor, board and joint protocol tests passed (%u "
           "stop calls)\n",
           stops);
    return 0;
}
