xiaomiao321/taideng/MCU/software/HostTest/joint_selftest.c

#include "joint_control.h"
#include <assert.h>
#include <math.h>
#include <stdio.h>
#include <stdlib.h>
#include <string.h>
static int output_duty;
static bool hardware_ok;
static bool is_braking;
static unsigned brake_calls;
static char reply[100];
/* 多关节用例按关节分别记录输出，并保留全部回复。 */
static int duties[6];
static bool braked[6];
static char log_text[2000];
static bool drive(unsigned index, int duty)
{
    assert(index < 6);
    output_duty = duty;
    is_braking = false;
    duties[index] = duty;
    braked[index] = false;
    return hardware_ok;
}
static bool brake_motor(unsigned index)
{
    assert(index < 6);
    output_duty = 0;
    is_braking = true;
    duties[index] = 0;
    braked[index] = true;
    ++brake_calls;
    return hardware_ok;
}
static void emit(const char *text)
{
    snprintf(reply, sizeof(reply), "%s", text);
    size_t used = strlen(log_text);
    snprintf(&log_text[used], sizeof(log_text) - used, "%s", text);
}
static joint_cal_t normal(void)
{
    joint_cal_t c = {1000, 3000, 0, 180000, 1, 800, 2000, 0, 180000};
    return c;
}
static joint_control_t fresh(joint_cal_t cal)
{
    joint_control_t j;
    joint_hw_t hw = {drive, emit, brake_motor};
    hardware_ok = true;
    output_duty = 0;
    is_braking = false;
    brake_calls = 0;
    reply[0] = 0;
    log_text[0] = 0;
    memset(duties, 0, sizeof(duties));
    memset(braked, 0, sizeof(braked));
    joint_init(&j, hw);
    assert(!joint_calibrate(&j, 0, cal));
    return j;
}
static void feed(joint_control_t *j, uint16_t raw, uint32_t now)
{
    uint16_t values[6] = {raw, 2000, 2000, 2000, 2000, 2000};
    joint_feed(j, values, NULL, true, now);
}
/* 标定为每个读数 0.09°：读数每 10ms 加 n 即 9n °/s。 */
static void speed_test(void)
{
    joint_control_t j = fresh(normal());
    uint32_t now = 0;
    for (; now < 200; now += 10)
    {
        feed(&j, 2000, now);
    }
    /* 窗口未满时报 0。 */
    assert(j.states[0].est.count == 20 && j.states[0].speed == 0);
    feed(&j, 2000, now);
    assert(j.states[0].speed == 0 && !j.states[0].est.moving);
    /* 静止时 ±1 个读数的噪声不能被当成转动。 */
    uint32_t seed = 12345;
    for (int k = 0; k < 1000; ++k, now += 10)
    {
        seed = seed * 1103515245U + 12345U;
        feed(&j, (uint16_t)(2000 + (int)((seed >> 16) % 3U) - 1), now);
        assert(j.states[0].speed == 0);
    }
    /* 约 3°/s 的缓慢爬行低于转动阈值，仍报 0。 */
    double raw = 2000;
    for (int k = 0; k < 100; ++k, now += 10)
    {
        raw += 1.0 / 3.0;
        feed(&j, (uint16_t)raw, now);
        assert(j.states[0].speed == 0);
    }
    /* 45°/s：窗口填满新速度后估计准确。 */
    for (int k = 0; k < 30; ++k, now += 10)
    {
        raw += 5;
        feed(&j, (uint16_t)raw, now);
    }
    assert(j.states[0].speed >= 44000 && j.states[0].speed <= 46000);
    /* 降到约 3°/s：在迟滞带内，继续报非零。 */
    for (int k = 0; k < 30; ++k, now += 10)
    {
        raw += 1.0 / 3.0;
        feed(&j, (uint16_t)raw, now);
    }
    assert(j.states[0].speed > 2000 && j.states[0].speed < 4000);
    /* 停住：最多一个窗口后报 0。 */
    for (int k = 0; k < 21; ++k, now += 10)
    {
        feed(&j, (uint16_t)raw, now);
    }
    assert(j.states[0].speed == 0);
    /* 反向 45°/s 为负数。 */
    for (int k = 0; k < 30; ++k, now += 10)
    {
        raw -= 5;
        feed(&j, (uint16_t)raw, now);
    }
    assert(j.states[0].speed <= -44000 && j.states[0].speed >= -46000);
    /* 采样失败或读数断线：清空窗口，报 0；未标定关节始终为 0。 */
    joint_feed(&j, (uint16_t[6]){0}, NULL, false, now);
    assert(j.states[0].speed == 0 && j.states[0].est.count == 0);
    feed(&j, 0, now + 10);
    assert(j.states[0].speed == 0 && j.states[0].est.count == 0);
    assert(j.states[1].speed == 0 && j.states[1].est.count == 0);
    /* 上电恢复标定时角度未知，首次有效采样补上目标。 */
    joint_control_t k;
    joint_init(&k, (joint_hw_t){drive, emit, brake_motor});
    assert(!joint_calibrate(&k, 0, normal()) && !k.states[0].has_target);
    feed(&k, 2000, 0);
    assert(k.states[0].has_target && k.states[0].target == 90000);
}

/* 故障锁存为故障位；清除时只保留原因仍在的。 */
static void fault_latch_test(void)
{
    /* 传感器：读数断线时停机置位，读数恢复前清不掉。 */
    joint_control_t j = fresh(normal());
    feed(&j, 2000, 0);
    assert(!joint_move(&j, 1, 0, 150000, 10000, 0));
    feed(&j, 0, 10);
    assert(!joint_tick(&j, 10));
    assert(j.states[0].faults == JOINT_FAULT_SENSOR &&
           joint_fault_flags(&j) == JOINT_FAULT_SENSOR);
    joint_clear_faults(&j, 20);
    assert(j.states[0].faults == JOINT_FAULT_SENSOR &&
           j.states[0].phase == JOINT_FAULT);
    feed(&j, 2000, 30);
    joint_clear_faults(&j, 30);
    assert(j.states[0].faults == 0 && j.states[0].phase == JOINT_IDLE &&
           !strcmp(j.states[0].fault, "NONE"));

    /* 越限：角度回到允许范围内才清除。 */
    assert(!joint_move(&j, 2, 0, 170000, 10000, 30));
    feed(&j, 3100, 40); /* 189° */
    assert(!joint_tick(&j, 40) && j.states[0].faults == JOINT_FAULT_LIMIT);
    joint_clear_faults(&j, 50);
    assert(j.states[0].faults == JOINT_FAULT_LIMIT);
    feed(&j, 2000, 60);
    joint_clear_faults(&j, 60);
    assert(j.states[0].faults == 0);

    /* 超时随运动结束消失，STOP 直接清除。 */
    assert(!joint_move(&j, 3, 0, 150000, 500, 60));
    feed(&j, 2000, 600);
    assert(!joint_tick(&j, 600) && j.states[0].faults == JOINT_FAULT_TIMEOUT);
    joint_clear_faults(&j, 600);
    assert(j.states[0].faults == 0);

    /* 驱动失败：再次停机仍失败就保留。 */
    feed(&j, 2000, 700);
    assert(!joint_move(&j, 4, 0, 150000, 10000, 700));
    assert(joint_tick(&j, 700));
    hardware_ok = false;
    feed(&j, 2000, 800);
    assert(!joint_tick(&j, 800) && j.states[0].faults == JOINT_FAULT_HARDWARE);
    joint_clear_faults(&j, 800);
    assert(j.states[0].faults == JOINT_FAULT_HARDWARE);
    hardware_ok = true;
    joint_clear_faults(&j, 800);
    assert(j.states[0].faults == 0);

    /* 全局故障为各关节按位或；正在运动的关节不清除。 */
    j.states[2].faults = JOINT_FAULT_STALL;
    j.states[0].faults = JOINT_FAULT_DIRECTION;
    assert(joint_fault_flags(&j) ==
           (JOINT_FAULT_STALL | JOINT_FAULT_DIRECTION));
    feed(&j, 2000, 900);
    assert(!joint_move(&j, 5, 0, 150000, 10000, 900));
    joint_clear_faults(&j, 900);
    assert(j.states[0].faults == JOINT_FAULT_DIRECTION &&
           j.states[2].faults == 0);
    assert(joint_cancel(&j));
}

static void plant_test(bool reversed)
{
    joint_cal_t cal = normal();
    if (reversed)
    {
        cal.raw_a = 3000;
        cal.raw_b = 1000;
        cal.direction = -1;
    }
    joint_control_t j = fresh(cal);
    double raw = 2000;
    feed(&j, (uint16_t)raw, 0);
    assert(!joint_move(&j, 10, 0, 130000, 20000, 0));
    for (uint32_t now = 0; now < 20000 && joint_any_active(&j); now += 10)
    {
        raw += output_duty / 1000.0 * 5.0;
        feed(&j, (uint16_t)raw, now);
        assert(joint_tick(&j, now));
    }
    assert(!joint_any_active(&j) && j.states[0].phase == JOINT_DONE &&
           output_duty == 0);
    assert(j.states[0].angle >= 128000 && j.states[0].angle <= 132000);
    assert(strstr(reply, "REACHED"));
}
/**
 * 带惯性的电机模型：驱动时速度趋向占空比对应的稳态值，滑行时速度缓慢衰减，
 * 制动时迅速衰减。返回最大过冲（毫度，越过目标的量）。
 */
static int32_t inertia_test(joint_tune_t tune, int32_t target)
{
    joint_control_t j = fresh(normal());
    assert(!joint_set_tune(&j, 0, tune));
    double raw = 2000, speed = 0; /* 读数/10ms */
    feed(&j, (uint16_t)raw, 0);
    int32_t start = j.states[0].angle, overshoot = 0;
    assert(!joint_move(&j, 20, 0, target, 20000, 0));
    for (uint32_t now = 0; now < 20000 && joint_any_active(&j); now += 10)
    {
        double steady = output_duty / 1000.0 * 8.0;
        speed += is_braking ? -speed * 0.8
                 : output_duty ? (steady - speed) * 0.2
                               : -speed * 0.05;
        raw += speed;
        feed(&j, (uint16_t)raw, now);
        int32_t past = (target > start) ? j.states[0].angle - target
                                        : target - j.states[0].angle;
        overshoot = past > overshoot ? past : overshoot;
        assert(joint_tick(&j, now));
    }
    assert(!joint_any_active(&j) && j.states[0].phase == JOINT_DONE);
    assert(strstr(reply, "REACHED"));
    return overshoot;
}
static void tune_test(void)
{
    joint_control_t j = fresh(normal());
    joint_tune_t def = j.states[0].tune;
    assert(def.mode == JOINT_MODE_P && def.kp == 10 && def.duty_min == 300 &&
           def.brake_ms == 50);
    joint_tune_t bang_tune = {JOINT_MODE_BANG, 30, 500, 50};
    joint_tune_t p = {JOINT_MODE_P, 30, 300, 50};
    assert(!joint_set_tune(&j, 1, p)); /* 不要求已标定 */
    joint_tune_t bad = p;
    bad.mode = JOINT_MODE_COUNT;
    assert(!strcmp(joint_set_tune(&j, 0, bad), "TUNE_PARAM"));
    bad = p;
    bad.kp = JOINT_KP_MAX + 1U;
    assert(joint_set_tune(&j, 0, bad));
    bad = p;
    bad.duty_min = 99;
    assert(joint_set_tune(&j, 0, bad));
    bad = p;
    bad.brake_ms = JOINT_BRAKE_MAX_MS + 1U;
    assert(joint_set_tune(&j, 0, bad));
    assert(!strcmp(joint_set_tune(&j, 6, p), "JOINT_ID"));
    /* 最高占空比写进 cal.duty，要求已标定、非零且不超过上限。 */
    assert(!strcmp(joint_set_duty_max(&j, 1, 500), "NOT_CALIBRATED"));
    assert(!strcmp(joint_set_duty_max(&j, 0, 0), "TUNE_PARAM"));
    assert(!strcmp(joint_set_duty_max(&j, 0, 99), "TUNE_PARAM"));
    assert(!strcmp(joint_set_duty_max(&j, 0, MOTOR_DUTY_LIMIT + 1U),
                   "TUNE_PARAM"));
    assert(!strcmp(joint_set_duty_max(&j, 6, 500), "JOINT_ID"));
    assert(!joint_set_duty_max(&j, 0, 600) && j.states[0].cal.duty == 600);
    assert(!joint_set_duty_max(&j, 0, 800));

    /* 比例式占空比：远处饱和到 cal.duty，近处为起转占空比加比例项。 */
    assert(!joint_set_tune(&j, 0, p));
    feed(&j, 2000, 0); /* 90° */
    assert(!joint_move(&j, 21, 0, 150000, 10000, 0));
    assert(!strcmp(joint_set_tune(&j, 0, p), "BUSY"));
    assert(joint_tick(&j, 0) && output_duty == 0); /* 换向停顿 */
    feed(&j, 2000, 100);
    assert(joint_tick(&j, 100) && output_duty == 800);
    feed(&j, 2611, 110); /* 约 145°，误差约 5° */
    assert(joint_tick(&j, 110));
    assert(output_duty >= 300 + 140 && output_duty <= 300 + 160);
    /* 进入容差：先制动，制动时长到后松开为滑行，保持后判定到达。 */
    feed(&j, 2667, 120); /* 约 150° */
    assert(joint_tick(&j, 120) && is_braking && brake_calls == 1);
    feed(&j, 2667, 160);
    assert(joint_tick(&j, 160) && is_braking);
    feed(&j, 2667, 170);
    assert(joint_tick(&j, 170) && !is_braking && output_duty == 0);
    feed(&j, 2667, 320);
    assert(joint_tick(&j, 320));
    assert(!joint_any_active(&j) && j.states[0].phase == JOINT_DONE);

    /* 过冲换向：比例式先制动再反向。 */
    j = fresh(normal());
    assert(!joint_set_tune(&j, 0, p));
    feed(&j, 2000, 0);
    assert(!joint_move(&j, 22, 0, 100000, 10000, 0));
    assert(joint_tick(&j, 0));
    feed(&j, 2000, 100);
    assert(joint_tick(&j, 100) && output_duty > 0);
    feed(&j, 2200, 110); /* 约 108°，越过目标 */
    assert(joint_tick(&j, 110) && is_braking && output_duty == 0);
    feed(&j, 2200, 210);
    assert(joint_tick(&j, 210) && output_duty < 0 && !is_braking);
    assert(joint_cancel(&j));

    /* 没有制动回调时退化为滑行。 */
    joint_control_t plain;
    joint_hw_t hw = {drive, emit, NULL};
    joint_init(&plain, hw);
    assert(!joint_calibrate(&plain, 0, normal()));
    assert(!joint_set_tune(&plain, 0, p));
    brake_calls = 0;
    feed(&plain, 2000, 0);
    assert(!joint_move(&plain, 23, 0, 90500, 10000, 0));
    assert(joint_tick(&plain, 0) && brake_calls == 0 && output_duty == 0);
    assert(joint_cancel(&plain));

    /* 带惯性的模型：两种方式都能到位，比例式加制动的过冲明显更小。 */
    int32_t bang = inertia_test(bang_tune, 150000);
    int32_t prop = inertia_test(p, 150000);
    assert(prop < bang);
    (void)inertia_test(p, 30000);
    printf("inertia overshoot: bang %ld mdeg, proportional %ld mdeg\n",
           (long)bang, (long)prop);
}
static joint_tune_t p_tune(void)
{
    joint_tune_t t = {JOINT_MODE_BANG, 55, 420, 120};
    return t;
}
/** 控制参数随标定保存；未标定关节的控制参数也保存；版本 2 只恢复标定。 */
static void tune_blob_test(void)
{
    joint_control_t source = fresh(normal());
    assert(!joint_set_tune(&source, 0, p_tune()));
    assert(!joint_set_tune(&source, 3, p_tune())); /* M4 未标定 */
    uint8_t blob[JOINT_CAL_BLOB_SIZE];
    joint_cal_export(&source, blob);
    joint_control_t restored = fresh(normal());
    restored.states[0].calibrated = false;
    assert(joint_cal_import(&restored, blob, sizeof(blob)) == 1U);
    assert(!memcmp(&restored.states[0].tune, &source.states[0].tune,
                   sizeof(joint_tune_t)));
    assert(!memcmp(&restored.states[3].tune, &source.states[3].tune,
                   sizeof(joint_tune_t)));
    assert(!restored.states[3].calibrated);
    assert(restored.states[1].tune.mode == JOINT_MODE_P);

    /* 由版本 3 构造版本 2：去掉每项最后 8 字节。 */
    uint8_t v2[JOINT_CAL_BLOB_V2_SIZE];
    memcpy(v2, blob, 4);
    v2[0] = 2U;
    for (unsigned i = 0; i < JOINT_COUNT; ++i)
    {
        memcpy(&v2[4 + i * 28], &blob[4 + i * JOINT_CAL_BLOB_ENTRY_SIZE], 28);
    }
    joint_control_t migrated = fresh(normal());
    migrated.states[0].calibrated = false;
    assert(joint_cal_import(&migrated, v2, sizeof(v2)) == 1U);
    assert(!memcmp(&migrated.states[0].cal, &source.states[0].cal,
                   sizeof(joint_cal_t)));
    assert(migrated.states[0].tune.mode == JOINT_MODE_P &&
           migrated.states[0].tune.kp == 10);
    assert(joint_cal_import(&migrated, v2, sizeof(blob)) == 0U);

    assert(joint_median3(1, 2, 3) == 2 && joint_median3(3, 1, 2) == 2 &&
           joint_median3(2, 3, 1) == 2 && joint_median3(5, 5, 1) == 5 &&
           joint_median3(100, 4095, 101) == 101 && joint_median3(0, 7, 7) == 7);
}
/** 两个关节各自的带惯性模型，读数/10ms。 */
static void step_plant(double *raw, double *speed, unsigned i)
{
    double steady = duties[i] / 1000.0 * 8.0;
    speed[i] += braked[i]   ? -speed[i] * 0.8
                : duties[i] ? (steady - speed[i]) * 0.2
                            : -speed[i] * 0.05;
    raw[i] += speed[i];
}
static void feed_all(joint_control_t *j, const double *raw, uint32_t now)
{
    uint16_t values[6];
    for (unsigned i = 0; i < 6; ++i)
    {
        values[i] = (uint16_t)raw[i];
    }
    joint_feed(j, values, NULL, true, now);
}
static void multi_test(void)
{
    /* 两个关节同时运动，各自到位，互不打断。 */
    joint_control_t j = fresh(normal());
    joint_cal_t reversed = normal();
    reversed.raw_a = 3000;
    reversed.raw_b = 1000;
    reversed.direction = -1;
    assert(!joint_calibrate(&j, 1, reversed));
    double raw[6] = {2000, 2000, 2000, 2000, 2000, 2000}, speed[6] = {0};
    feed_all(&j, raw, 0);
    assert(!joint_move(&j, 30, 0, 130000, 20000, 0));
    assert(!joint_move(&j, 31, 1, 40000, 20000, 0));
    assert(j.states[0].motion.active && j.states[1].motion.active);
    bool both_driving = false;
    for (uint32_t now = 0; now < 20000 && joint_any_active(&j); now += 10)
    {
        step_plant(raw, speed, 0);
        step_plant(raw, speed, 1);
        feed_all(&j, raw, now);
        assert(joint_tick(&j, now));
        both_driving = both_driving || (duties[0] != 0 && duties[1] != 0);
    }
    assert(both_driving);
    assert(j.states[0].phase == JOINT_DONE && j.states[1].phase == JOINT_DONE);
    assert(j.states[0].angle >= 128000 && j.states[0].angle <= 132000);
    assert(j.states[1].angle >= 38000 && j.states[1].angle <= 42000);
    assert(strstr(log_text, "JRESULT 30 M1 REACHED") &&
           strstr(log_text, "JRESULT 31 M2 REACHED"));

    /* 运动中的关节不能改标定和参数，其他关节可以。 */
    j = fresh(normal());
    double still[6] = {2000, 2000, 2000, 2000, 2000, 2000};
    feed_all(&j, still, 0);
    assert(!joint_move(&j, 40, 0, 150000, 10000, 0));
    assert(!strcmp(joint_calibrate(&j, 0, normal()), "BUSY"));
    assert(!strcmp(joint_set_limits(&j, 0, 10000, 170000), "BUSY"));
    joint_tune_t t = j.states[0].tune;
    assert(!strcmp(joint_set_tune(&j, 0, t), "BUSY"));
    assert(!joint_calibrate(&j, 2, normal()));
    assert(!joint_set_tune(&j, 2, t));

    /* 同一关节的新目标替代旧目标：旧命令回报 SUPERSEDED，方向不变时不重新停顿。 */
    assert(joint_tick(&j, 0));
    feed_all(&j, still, 100);
    assert(joint_tick(&j, 100) && duties[0] > 0);
    assert(!joint_move(&j, 41, 0, 160000, 10000, 110));
    assert(strstr(log_text, "JRESULT 40 M1 SUPERSEDED"));
    assert(j.states[0].motion.seq == 41 && j.states[0].target == 160000);
    feed_all(&j, still, 110);
    assert(joint_tick(&j, 110) && duties[0] > 0);

    /* 一个关节的传感器故障只停它自己，另一个继续。 */
    assert(!joint_move(&j, 42, 2, 150000, 10000, 110));
    double broken[6] = {2000, 2000, 0, 2000, 2000, 2000};
    feed_all(&j, broken, 120);
    assert(!joint_tick(&j, 120));
    assert(!strcmp(j.states[2].fault, "SENSOR") && !j.states[2].motion.active);
    assert(j.states[0].motion.active && duties[0] > 0 && duties[2] == 0);

    /* 取消全部。 */
    assert(joint_cancel(&j) && !joint_any_active(&j));
    assert(duties[0] == 0 && strstr(log_text, "JRESULT 41 M1 CANCELLED"));
}
static void filter_test(void)
{
    uint16_t samples[16][JOINT_COUNT];
    for (unsigned n = 0; n < 16; ++n)
    {
        for (unsigned ch = 0; ch < JOINT_COUNT; ++ch)
        {
            samples[n][ch] = (uint16_t)(2000 + ch + (n % 2));
        }
    }
    /* 四个离群点被去掉，不影响结果。 */
    samples[3][0] = 4095;
    samples[7][0] = 0;
    samples[9][0] = 3000;
    samples[12][0] = 100;
    uint16_t out[JOINT_COUNT], spread[JOINT_COUNT];
    joint_filter((const uint16_t(*)[JOINT_COUNT])samples, 16, out, spread);
    assert(out[0] == 2001 || out[0] == 2000);
    assert(spread[0] == 4095);
    for (unsigned ch = 1; ch < JOINT_COUNT; ++ch)
    {
        assert(out[ch] == 2000 + ch + 1 || out[ch] == 2000 + ch);
        assert(spread[ch] == 1);
    }
    joint_filter((const uint16_t(*)[JOINT_COUNT])samples, 1, out, spread);
    assert(out[1] == 2001 && spread[1] == 0);

    joint_control_t j = fresh(normal());
    uint16_t raw[JOINT_COUNT] = {2000, 2000, 2000, 2000, 2000, 2000};
    uint16_t noise[JOINT_COUNT] = {12, 0, 0, 0, 0, 0};
    joint_feed(&j, raw, noise, true, 0);
    assert(j.states[0].spread == 12 && j.states[1].spread == 0);
}
/* -------------------------------------------------------------------------- */
/* 轨迹式                                                                      */
/* -------------------------------------------------------------------------- */

/** 五次多项式本身：端点、峰值、逐毫秒的速度和加速度变化都有界，中途重规划衔接连续。 */
static void traj_curve_test(void)
{
    joint_traj_t t;
    joint_traj_point_t start = {10000.0f, 0.0f, 0.0f};
    joint_traj_plan(&t, start, 100000.0f, 30000.0f, 60000.0f, 300U);
    /* 90° 按 30°/s 算 1.875 × 3 = 5.625s，比按加速度算的长。 */
    assert(t.duration_ms == 5625U);
    joint_traj_point_t first = joint_traj_eval(&t, 0.0f);
    assert(first.p == 10000.0f && first.v == 0.0f && first.a == 0.0f);
    joint_traj_point_t prev = first;
    float vmax = 0.0f, amax = 0.0f, dv = 0.0f, da = 0.0f;
    for (unsigned ms = 1U; ms <= t.duration_ms + 20U; ++ms)
    {
        joint_traj_point_t r = joint_traj_eval(&t, (float)ms);
        vmax = fmaxf(vmax, fabsf(r.v));
        amax = fmaxf(amax, fabsf(r.a));
        dv = fmaxf(dv, fabsf(r.v - prev.v));
        da = fmaxf(da, fabsf(r.a - prev.a));
        prev = r;
    }
    assert(vmax <= 30000.0f * 1.001f && vmax >= 29900.0f);
    assert(amax <= 60000.0f);
    /* 速度连续：每毫秒变化不超过加速度峰值的千分之一；
     * 加速度连续：每毫秒变化不超过加加速度峰值 60·D/T³ 的千分之一。 */
    float T = 5.625f;
    assert(dv <= amax / 1000.0f * 1.01f);
    assert(da <= 60.0f * 90000.0f / (T * T * T) / 1000.0f * 1.01f);
    assert(prev.p == 100000.0f && prev.v == 0.0f && prev.a == 0.0f);
    joint_traj_point_t end = joint_traj_eval(&t, (float)t.duration_ms - 0.5f);
    assert(fabsf(end.p - 100000.0f) < 1.0f && fabsf(end.v) < 1.0f &&
           fabsf(end.a) < 100.0f);

    /* 中途换目标：新轨迹起点与旧轨迹此刻的位置、速度、加速度一致。 */
    joint_traj_point_t mid = joint_traj_eval(&t, 1000.0f);
    joint_traj_t u;
    joint_traj_plan(&u, mid, 20000.0f, 30000.0f, 60000.0f, 300U);
    joint_traj_point_t join = joint_traj_eval(&u, 0.0f);
    assert(join.p == mid.p && join.v == mid.v && join.a == mid.a);
    joint_traj_point_t done = joint_traj_eval(&u, (float)u.duration_ms);
    assert(done.p == 20000.0f && done.v == 0.0f && done.a == 0.0f);

    /* 距离很短时用最短时长。 */
    joint_traj_plan(&u, start, 10100.0f, 30000.0f, 60000.0f, 300U);
    assert(u.duration_ms == 300U);
}

/**
 * 带摩擦和背隙的电机模型，度和度/秒。占空比为 τ（千分之一），静止时 |τ|
 * 不超过静摩擦 0.25 就不动；转动时加速度 = A·(τ − 0.20·方向) − B·速度。
 * 稳态时 τ = 0.20 + 0.01·速度，与默认的 kv = 10、动摩擦 = 起转 × 80% 一致。
 * 电位器测的是背隙另一侧的输出轴。
 */
typedef struct
{
    double motor;     /**< 电机侧位置，度。 */
    double speed;     /**< 电机侧转速，度/秒。 */
    double out;       /**< 输出轴位置，度。 */
    double backlash;  /**< 背隙，度。 */
    double stiction;  /**< 静摩擦，占空比。 */
    bool stuck;       /**< 模拟卡死：电机完全不动。 */
} friction_plant_t;

static void plant_step(friction_plant_t *p, int duty, double dt)
{
    const double A = 2000.0, B = 20.0, kinetic = 0.20;
    double tau = duty / 1000.0;
    if (p->stuck)
    {
        p->speed = 0.0;
    }
    else if (p->speed == 0.0)
    {
        if (fabs(tau) > p->stiction)
        {
            p->speed = dt * A * (tau - (tau > 0 ? kinetic : -kinetic));
        }
    }
    else
    {
        double sign = p->speed > 0 ? 1.0 : -1.0;
        double next =
            p->speed + dt * (A * (tau - sign * kinetic) - B * p->speed);
        p->speed = (next * sign <= 0.0) ? 0.0 : next;
    }
    p->motor += p->speed * dt;
    double half = p->backlash / 2.0;
    if (p->motor - p->out > half)
    {
        p->out = p->motor - half;
    }
    else if (p->out - p->motor > half)
    {
        p->out = p->motor + half;
    }
}

/** 标定 0～180° 对应读数 1000～3000。 */
static uint16_t plant_raw(const friction_plant_t *p)
{
    return (uint16_t)lround(1000.0 + p->out / 0.09);
}

static joint_tune_t traj_tune(void)
{
    joint_tune_t t = {JOINT_MODE_TRAJ, 50, 250, 0};
    return t;
}

typedef struct
{
    int32_t final_angle;
    int32_t min_angle;
    int32_t max_angle;
    int max_step;      /**< 两次非零输出之间占空比的最大变化。 */
    int32_t max_track; /**< 运动中跟踪误差的最大值，毫度。 */
    int32_t max_ref_jump; /**< 相邻两次参考位置的最大变化，毫度。 */
} traj_run_t;

/** 跑到运动结束；途中可在 switch_ms 时刻换目标。 */
static traj_run_t traj_run(joint_control_t *j, friction_plant_t *p,
                           uint32_t now, uint32_t limit_ms, uint32_t switch_ms,
                           int32_t switch_target)
{
    traj_run_t r = {0, INT32_MAX, INT32_MIN, 0, 0, 0};
    int last = 0;
    int32_t last_ref = joint_reference(&j->states[0]);
    for (uint32_t end = now + limit_ms; now < end && joint_any_active(j);
         now += 10)
    {
        plant_step(p, output_duty, 0.01);
        feed(j, plant_raw(p), now);
        if (switch_ms && now == switch_ms)
        {
            assert(!joint_move(j, 31, 0, switch_target, 20000, now));
        }
        assert(joint_tick(j, now));
        const joint_state_t *s = &j->states[0];
        if (output_duty && last)
        {
            int step = abs(output_duty - last);
            r.max_step = step > r.max_step ? step : r.max_step;
        }
        last = output_duty;
        int32_t ref = joint_reference(s);
        int32_t jump = abs(ref - last_ref);
        r.max_ref_jump = jump > r.max_ref_jump ? jump : r.max_ref_jump;
        last_ref = ref;
        if (s->motion.active)
        {
            int32_t track = abs(s->motion.ref - s->angle);
            r.max_track = track > r.max_track ? track : r.max_track;
        }
        r.min_angle = s->angle < r.min_angle ? s->angle : r.min_angle;
        r.max_angle = s->angle > r.max_angle ? s->angle : r.max_angle;
    }
    r.final_angle = j->states[0].angle;
    return r;
}

static joint_control_t traj_fresh(friction_plant_t *p, double start_deg,
                                  int approach)
{
    joint_control_t j = fresh(normal());
    assert(!joint_set_tune(&j, 0, traj_tune()));
    joint_traj_cfg_t cfg = j.states[0].traj;
    cfg.approach = approach;
    assert(!joint_set_traj(&j, 0, cfg));
    *p = (friction_plant_t){start_deg, 0.0, start_deg, 0.0, 0.25, false};
    feed(&j, plant_raw(p), 0);
    return j;
}

/** 轨迹式在摩擦模型上到位：不报故障、不制动、输出平滑、跟踪误差小。 */
static void traj_plant_test(void)
{
    friction_plant_t p;
    joint_control_t j = traj_fresh(&p, 30.0, 0);
    assert(!joint_move(&j, 30, 0, 120000, 20000, 0));
    assert(j.states[0].phase == JOINT_MOVING);
    traj_run_t r = traj_run(&j, &p, 10, 20000, 0, 0);
    assert(j.states[0].phase == JOINT_DONE && strstr(reply, "REACHED"));
    assert(abs(r.final_angle - 120000) <= 2000);
    assert(brake_calls == 0U && output_duty == 0);
    /* 起步预加到 220 是唯一的跳变，之后每 10ms 变化很小。 */
    assert(r.max_step <= 40);
    assert(r.max_track <= 3000);
    /* 不越过目标太多：没有规定方向时也不该有明显过冲。 */
    assert(r.max_angle <= 122000);
    printf("traj: 30->120 deg, final %ld mdeg, max duty step %d, "
           "max tracking error %ld mdeg\n",
           (long)r.final_angle, r.max_step, (long)r.max_track);

    /* 反向电机：标定 direction = -1 时输出取反。 */
    joint_cal_t cal = normal();
    cal.raw_a = 3000;
    cal.raw_b = 1000;
    cal.direction = -1;
    joint_control_t k = fresh(cal);
    assert(!joint_set_tune(&k, 0, traj_tune()));
    feed(&k, 2000, 0);
    assert(!joint_move(&k, 32, 0, 120000, 20000, 0));
    feed(&k, 2000, 10);
    assert(joint_tick(&k, 10));
    assert(output_duty < 0); /* 角度要增大，电机反转。 */
}

/**
 * 单向逼近：规定从角度小的一侧到达。从上方来时先越过目标再回来，两个方向
 * 到达的位置都落在目标下沿附近，背隙两侧的差别被消除。
 */
static void traj_approach_test(void)
{
    friction_plant_t p;
    joint_control_t j = traj_fresh(&p, 120.0, 1);
    p.backlash = 1.0;
    assert(!joint_move(&j, 33, 0, 60000, 20000, 0));
    assert(j.states[0].motion.seg_count == 2U);
    traj_run_t from_above = traj_run(&j, &p, 10, 20000, 0, 0);
    assert(strstr(reply, "REACHED"));
    /* 越过了目标：到过 60° − 3° 附近。 */
    assert(from_above.min_angle <= 57000 + 1500);
    assert(abs(from_above.final_angle - 60000) <= 2000);

    j = traj_fresh(&p, 10.0, 1);
    p.backlash = 1.0;
    assert(!joint_move(&j, 34, 0, 60000, 20000, 0));
    assert(j.states[0].motion.seg_count == 1U);
    traj_run_t from_below = traj_run(&j, &p, 10, 20000, 0, 0);
    assert(strstr(reply, "REACHED"));
    assert(from_below.max_angle <= 60000 + 2000);
    int32_t gap = abs(from_above.final_angle - from_below.final_angle);
    printf("traj approach: from above %ld, from below %ld mdeg\n",
           (long)from_above.final_angle, (long)from_below.final_angle);
    assert(gap <= 1000);

    /* 同向到达只有一段；目标就在容差内时不做超调。 */
    j = traj_fresh(&p, 61.0, 1);
    assert(!joint_move(&j, 35, 0, 60000, 20000, 0));
    assert(j.states[0].motion.seg_count == 1U);

    /* 超调点被下限压缩到小于背隙：放弃单向逼近，回报 JNOTE，照常到位。 */
    j = traj_fresh(&p, 90.0, 1);
    assert(!joint_set_limits(&j, 0, 0, 180000));
    assert(!joint_move(&j, 36, 0, 500, 20000, 0));
    assert(j.states[0].motion.seg_count == 1U);
    assert(strstr(log_text, "JNOTE 36 M1 NO_OVERSHOOT"));
    /* 压缩后仍不小于背隙：两段，中间点就是下限。 */
    j = traj_fresh(&p, 90.0, 1);
    assert(!joint_move(&j, 37, 0, 1500, 20000, 0));
    assert(j.states[0].motion.seg_count == 2U &&
           j.states[0].motion.seg[0].p1 == 0.0f);
}

/** 运动中换目标：参考位置不跳变，最终到达新目标。 */
static void traj_supersede_test(void)
{
    friction_plant_t p;
    joint_control_t j = traj_fresh(&p, 30.0, 0);
    assert(!joint_move(&j, 38, 0, 150000, 20000, 0));
    traj_run_t r = traj_run(&j, &p, 10, 20000, 1500, 40000);
    assert(strstr(log_text, "SUPERSEDED") && strstr(reply, "REACHED"));
    assert(abs(r.final_angle - 40000) <= 2000);
    /* 30°/s 下 10ms 最多走 0.3°，换目标那一刻也一样。 */
    assert(r.max_ref_jump <= 320);
}

/** 时长超过期限拒绝；卡死报停滞；参数校验。 */
static void traj_error_test(void)
{
    friction_plant_t p;
    joint_control_t j = traj_fresh(&p, 10.0, 0);
    assert(!strcmp(joint_move(&j, 39, 0, 170000, 3000, 0), "TOO_SLOW"));
    assert(!joint_any_active(&j));
    /* 速度上限：给 10°/s，160° 要 30s，超过 20s 期限。 */
    assert(!strcmp(joint_move_speed(&j, 40, 0, 170000, 20000, 10000, 0),
                   "TOO_SLOW"));
    assert(!joint_move_speed(&j, 41, 0, 170000, 20000, 90000, 0));
    /* 超过配置的 30°/s 时按 30°/s：约 160° 要 1.875 × 160 / 30 = 10s。 */
    uint32_t ms = j.states[0].motion.seg[0].duration_ms;
    assert(ms >= 9990U && ms <= 10010U);
    assert(joint_cancel(&j));

    j = traj_fresh(&p, 10.0, 0);
    p.stuck = true;
    assert(!joint_move(&j, 42, 0, 100000, 20000, 0));
    uint32_t now = 10;
    for (; now < 20000 && joint_any_active(&j); now += 10)
    {
        plant_step(&p, output_duty, 0.01);
        feed(&j, plant_raw(&p), now);
        (void)joint_tick(&j, now);
    }
    assert(j.states[0].phase == JOINT_FAULT && strstr(reply, "STALL") &&
           (j.states[0].faults & JOINT_FAULT_STALL));

    joint_traj_cfg_t cfg = j.states[0].traj;
    cfg.approach = 2;
    assert(!strcmp(joint_set_traj(&j, 0, cfg), "TUNE_PARAM"));
    cfg.approach = -1;
    cfg.overshoot = cfg.backlash - 1;
    assert(!strcmp(joint_set_traj(&j, 0, cfg), "TUNE_PARAM"));
    cfg.overshoot = 40000;
    assert(!strcmp(joint_set_traj(&j, 0, cfg), "TUNE_PARAM"));
    assert(!strcmp(joint_set_traj(&j, 6, j.states[0].traj), "JOINT_ID"));
}

/**
 * 比例式单向逼近：规定最后一段角度增大。从 90° 去 30° 时先越过 30° 到
 * 中间点，制动、换向后从下往上回到 30°；从下往上去时直接到。
 */
static void p_approach_test(void)
{
    joint_control_t j = fresh(normal());
    joint_traj_cfg_t cfg = j.states[0].traj;
    cfg.approach = 1;
    cfg.backlash = 1000;
    cfg.overshoot = 5000;
    assert(!joint_set_traj(&j, 0, cfg));
    double raw[6] = {2000, 2000, 2000, 2000, 2000, 2000}, speed[6] = {0};
    feed_all(&j, raw, 0); /* 90° */
    assert(!joint_move(&j, 50, 0, 30000, 20000, 0));
    assert(j.states[0].motion.via_pending &&
           j.states[0].motion.goal == 25000 &&
           joint_reference(&j.states[0]) == 25000);
    int32_t lowest = INT32_MAX;
    int last_drive = 0;
    for (uint32_t now = 10; now < 20000 && joint_any_active(&j); now += 10)
    {
        step_plant(raw, speed, 0);
        feed_all(&j, raw, now);
        assert(joint_tick(&j, now));
        lowest = j.states[0].angle < lowest ? j.states[0].angle : lowest;
        last_drive = duties[0] ? duties[0] : last_drive;
    }
    assert(strstr(reply, "REACHED") && j.states[0].phase == JOINT_DONE);
    assert(abs(j.states[0].angle - 30000) <= 2000);
    /* 越过了目标至少 overshoot 减容差，最后一段电机正转即角度增大。 */
    assert(lowest <= 30000 - 5000 + 2000);
    assert(last_drive > 0);
    assert(j.states[0].target == 30000);
    printf("p approach: 90->30 lowest %ld, final %ld mdeg\n", (long)lowest,
           (long)j.states[0].angle);

    /* 同向：从 10° 去 30° 不需要中间点。 */
    raw[0] = 1111; /* 约 10° */
    speed[0] = 0;
    feed_all(&j, raw, 30000);
    assert(!joint_move(&j, 51, 0, 30000, 20000, 30000));
    assert(!j.states[0].motion.via_pending &&
           j.states[0].motion.goal == 30000);
    assert(joint_cancel(&j));

    /* 中间点被下限压缩到小于背隙：放弃，回报 JNOTE，直接去目标。 */
    assert(!joint_set_limits(&j, 0, 29500, 180000));
    raw[0] = 2000;
    feed_all(&j, raw, 31000);
    log_text[0] = 0;
    assert(!joint_move(&j, 52, 0, 30000, 20000, 31000));
    assert(!j.states[0].motion.via_pending &&
           strstr(log_text, "JNOTE 52 M1 NO_OVERSHOOT"));
    assert(joint_cancel(&j));
}

/** 逼近参数随标定保存；版本 3 记录只恢复标定和控制参数，逼近参数保持默认。 */
static void approach_blob_test(void)
{
    joint_control_t source = fresh(normal());
    joint_traj_cfg_t cfg = source.states[0].traj;
    cfg.approach = -1;
    cfg.backlash = 1500;
    cfg.overshoot = 4000;
    assert(!joint_set_traj(&source, 0, cfg));
    assert(!joint_set_tune(&source, 0, p_tune()));
    uint8_t blob[JOINT_CAL_BLOB_SIZE];
    joint_cal_export(&source, blob);
    assert(blob[0] == 4U);
    joint_control_t restored = fresh(normal());
    assert(joint_cal_import(&restored, blob, sizeof(blob)) == 1U);
    assert(restored.states[0].traj.approach == -1 &&
           restored.states[0].traj.backlash == 1500 &&
           restored.states[0].traj.overshoot == 4000);
    assert(restored.states[1].traj.approach == 0);

    /* 由版本 4 构造版本 3：去掉每项最后 8 字节。 */
    uint8_t v3[JOINT_CAL_BLOB_V3_SIZE];
    memcpy(v3, blob, 4);
    v3[0] = 3U;
    for (unsigned i = 0; i < JOINT_COUNT; ++i)
    {
        memcpy(&v3[4 + i * 36], &blob[4 + i * JOINT_CAL_BLOB_ENTRY_SIZE], 36);
    }
    joint_control_t migrated = fresh(normal());
    migrated.states[0].calibrated = false;
    assert(joint_cal_import(&migrated, v3, sizeof(v3)) == 1U);
    assert(!memcmp(&migrated.states[0].cal, &source.states[0].cal,
                   sizeof(joint_cal_t)));
    assert(!memcmp(&migrated.states[0].tune, &source.states[0].tune,
                   sizeof(joint_tune_t)));
    assert(migrated.states[0].traj.approach == 0);
    /* 版本号和长度对不上时不导入。 */
    assert(joint_cal_import(&migrated, v3, sizeof(blob)) == 0U);
    v3[0] = 4U;
    assert(joint_cal_import(&migrated, v3, sizeof(v3)) == 0U);
}

int main(void)
{
    joint_cal_t cal = normal();
    assert(joint_cal_valid(&cal));
    assert(joint_angle(&cal, 2000) == 90000);
    joint_cal_t reverse = cal;
    reverse.raw_a = 3000;
    reverse.raw_b = 1000;
    assert(joint_cal_valid(&reverse) && joint_angle(&reverse, 2000) == 90000);
    joint_cal_t bad = cal;
    bad.raw_b = 1050;
    assert(!joint_cal_valid(&bad));
    bad = cal;
    bad.angle_b = bad.angle_a;
    assert(!joint_cal_valid(&bad));
    bad = cal;
    bad.direction = 0;
    assert(!joint_cal_valid(&bad));
    bad = cal;
    bad.angle_a = INT32_MAX;
    assert(!joint_cal_valid(&bad));
    bad = cal;
    bad.duty = 99;
    assert(!joint_cal_valid(&bad));
    bad = cal;
    bad.duty = 100;
    assert(joint_cal_valid(&bad));
    bad = cal;
    bad.duty = 1000;
    assert(joint_cal_valid(&bad));
    bad = cal;
    bad.tolerance = 10001;
    assert(!joint_cal_valid(&bad));
    plant_test(false);
    plant_test(true);
    traj_curve_test();
    traj_plant_test();
    traj_approach_test();
    traj_supersede_test();
    traj_error_test();
    p_approach_test();
    approach_blob_test();
    joint_control_t j = fresh(cal);
    assert(joint_move(&j, 1, 6, 90000, 10000, 0));
    assert(joint_move(&j, 1, 1, 90000, 10000, 0)); /* M2 not calibrated */
    assert(joint_move(&j, 1, 0, 90000, 10000, 0)); /* no feedback */
    feed(&j, 2000, 0);
    assert(joint_move(&j, 1, 0, 180001, 10000, 0));
    assert(joint_move(&j, 1, 0, 90000, 100, 0));
    assert(!joint_move(&j, 1, 0, 90000, 10000, 0));
    for (uint32_t t = 0; t <= 200; t += 10)
    {
        feed(&j, 2000, t);
        assert(joint_tick(&j, t));
        assert(output_duty == 0);
    }
    assert(j.states[0].phase == JOINT_DONE);
    j = fresh(cal);
    feed(&j, 2000, 0);
    assert(!joint_move(&j, 2, 0, 150000, 10000, 0));
    for (uint32_t t = 0; t < 2000; t += 10)
    {
        feed(&j, 2000, t);
        assert(joint_tick(&j, t));
    }
    feed(&j, 2000, 2000);
    assert(!joint_tick(&j, 2000));
    assert(!strcmp(j.states[0].fault, "STALL"));
    assert(output_duty == 0);
    j = fresh(cal);
    feed(&j, 2000, 0);
    assert(!joint_move(&j, 3, 0, 150000, 10000, 0));
    assert(!joint_tick(&j, 51));
    assert(!strcmp(j.states[0].fault, "SENSOR"));
    j = fresh(cal);
    feed(&j, 2000, 0);
    assert(!joint_move(&j, 4, 0, 150000, 10000, 0));
    joint_feed(&j, NULL, NULL, false, 10);
    assert(!joint_tick(&j, 10));
    assert(output_duty == 0);
    j = fresh(cal);
    feed(&j, 2000, 0);
    assert(!joint_move(&j, 5, 0, 150000, 10000, 0));
    feed(&j, 3100, 10);
    assert(!joint_tick(&j, 10));
    assert(!strcmp(j.states[0].fault, "LIMIT"));
    j = fresh(cal);
    feed(&j, 2000, 0);
    assert(!joint_move(&j, 6, 0, 150000, 10000, 0));
    feed(&j, 1900, 10);
    assert(!joint_tick(&j, 10));
    assert(!strcmp(j.states[0].fault, "DIRECTION"));
    j = fresh(cal);
    feed(&j, 2000, 0);
    assert(!joint_move(&j, 7, 0, 150000, 500, 0));
    feed(&j, 2000, 500);
    assert(!joint_tick(&j, 500));
    assert(!strcmp(j.states[0].fault, "TIMEOUT"));
    j = fresh(cal);
    feed(&j, 2000, 0);
    assert(!joint_move(&j, 8, 0, 150000, 10000, 0));
    assert(joint_cancel(&j) && output_duty == 0 && !joint_any_active(&j) &&
           strstr(reply, "CANCELLED"));
    j = fresh(cal);
    feed(&j, 2000, UINT32_MAX - 100);
    assert(!joint_move(&j, 9, 0, 90000, 10000, UINT32_MAX - 100));
    for (uint32_t t = 0; t <= 200; t += 10)
    {
        feed(&j, 2000, UINT32_MAX - 100 + t);
        assert(joint_tick(&j, UINT32_MAX - 100 + t));
    }
    assert(j.states[0].phase == JOINT_DONE);

    /* 标定导出/导入：两个关节（含负角度、反向）往返后参数逐项相同。 */
    joint_control_t source = fresh(cal);
    joint_cal_t other = {3900, 200,  -45000, 30000, -1,
                         650,  1500, -40000, 25000};
    assert(!joint_calibrate(&source, 4, other));
    uint8_t blob[JOINT_CAL_BLOB_SIZE];
    joint_cal_export(&source, blob);
    joint_control_t restored = fresh(normal());
    restored.states[0].calibrated = false;
    assert(joint_cal_import(&restored, blob, sizeof(blob)) == 2U);
    for (unsigned i = 0; i < JOINT_COUNT; ++i)
    {
        assert(restored.states[i].calibrated == source.states[i].calibrated);
        if (source.states[i].calibrated)
        {
            assert(!memcmp(&restored.states[i].cal, &source.states[i].cal,
                           sizeof(joint_cal_t)));
        }
    }
    /* 版本不符：什么都不加载。 */
    joint_control_t untouched = fresh(normal());
    untouched.states[0].calibrated = false;
    blob[0] = (uint8_t)(JOINT_CAL_BLOB_VERSION + 1U);
    assert(joint_cal_import(&untouched, blob, sizeof(blob)) == 0U);
    assert(!untouched.states[0].calibrated && !untouched.states[4].calibrated);
    /* 数据损坏成非法参数（占空比 0）：该项被跳过，其余照常恢复。 */
    blob[0] = (uint8_t)JOINT_CAL_BLOB_VERSION;
    blob[4U + 4U * JOINT_CAL_BLOB_ENTRY_SIZE + 2U] = 0U;
    blob[4U + 4U * JOINT_CAL_BLOB_ENTRY_SIZE + 3U] = 0U;
    assert(joint_cal_import(&untouched, blob, sizeof(blob)) == 1U);
    assert(untouched.states[0].calibrated && !untouched.states[4].calibrated);
    /* 长度与版本不符：拒绝。 */
    assert(joint_cal_import(&untouched, blob, JOINT_CAL_BLOB_V2_SIZE) == 0U);
    tune_blob_test();

    /* 理论标定：47k 电位器，角度增大读数减小，参考点 90° 读 2048。
     * 每度 4095*47000/49000/270 ≈ 14.547 个读数，10° 与 170° 距参考点
     * 各 80°，即 ±1163.75 个读数。 */
    joint_nominal_t nominal = {
        .raw_ref = 2048,
        .angle_ref = 90000,
        .sensor_direction = -1,
        .direction = 1,
        .duty = 800,
        .tolerance = 2000,
        .limit_min = 10000,
        .limit_max = 170000,
        .pot_ohms = 47000,
    };
    joint_cal_t theory;
    assert(!joint_cal_from_nominal(&nominal, &theory));
    assert(theory.raw_a == 3212 && theory.raw_b == 884);
    assert(theory.angle_a == 10000 && theory.angle_b == 170000);
    assert(theory.limit_min == 10000 && theory.limit_max == 170000);
    int32_t at_ref = joint_angle(&theory, 2048);
    assert(at_ref > 89900 && at_ref < 90100);
    /* 阻值填 0 采用 45k 标称值，仍然成立。 */
    joint_nominal_t defaulted = nominal;
    defaulted.pot_ohms = 0;
    assert(!joint_cal_from_nominal(&defaulted, &theory));
    /* 允许范围超出电位器电气行程、方向或阻值无效：拒绝。 */
    joint_nominal_t wrong = nominal;
    wrong.limit_max = 260000;
    assert(joint_cal_from_nominal(&wrong, &theory));
    wrong = nominal;
    wrong.sensor_direction = 0;
    assert(joint_cal_from_nominal(&wrong, &theory));
    wrong = nominal;
    wrong.pot_ohms = 500;
    assert(joint_cal_from_nominal(&wrong, &theory));
    wrong = nominal;
    wrong.raw_ref = 20; /* 低于下端固定电阻对应的读数，不可能出现 */
    assert(joint_cal_from_nominal(&wrong, &theory));

    /* 允许范围与标定点分开：收窄范围后，范围外的目标被拒绝。 */
    j = fresh(cal);
    feed(&j, 2000, 0);
    assert(!joint_set_limits(&j, 0, 20000, 160000));
    assert(j.states[0].cal.angle_a == 0 && j.states[0].cal.angle_b == 180000);
    assert(joint_move(&j, 1, 0, 170000, 10000, 0));
    assert(!joint_move(&j, 1, 0, 150000, 10000, 0));
    assert(!strcmp(joint_set_limits(&j, 0, 0, 100000), "BUSY"));
    assert(joint_cancel(&j));
    assert(!strcmp(joint_set_limits(&j, 1, 0, 100000), "NOT_CALIBRATED"));
    /* 读数 1 对应约 -89.9°：超出可测区间的范围被拒绝。 */
    assert(!strcmp(joint_set_limits(&j, 0, -100000, 100000), "LIMIT_PARAM"));
    assert(!strcmp(joint_set_limits(&j, 0, 50000, 50000), "LIMIT_PARAM"));
    assert(j.states[0].cal.limit_min == 20000);

    tune_test();
    filter_test();
    multi_test();
    speed_test();
    fault_latch_test();
    puts("joint control: calibration, inverse sensor, simulated plant, "
         "arrival, stale ADC, limits, direction, stall, timeout, cancellation, "
         "rollover, calibration export/import, nominal calibration, limits, "
         "proportional mode with braking, ADC filter, concurrent joints, "
         "speed estimate and fault latching passed");
    return 0;
}
