xiaomiao321/taideng/MCU/software/HostTest/command_selftest.c

/**
 * @file command_selftest.c
 * @brief mcu_command 的 PC 端自测：用假硬件验证命令分派、去重和失联安全停止。
 *
 * mcu_command 不依赖 HAL，所以这里注册一组假的 mcu_command_hw_t 回调，就能在
 * 电脑上把整条链路跑完：请求报文 -> 命令处理 -> 回复报文 -> 编码成字节。
 * 不需要板子、串口和电机。
 *
 * 编译运行见同目录 run.ps1。
 *
 * @note 本文件不属于固件，不参与 arm 构建。
 * @note 输出一律 ASCII。
 */

#include <stdio.h>
#include <string.h>

#include "mcu_command.h"
#include "mcu_protocol.h"

/* -------------------------------------------------------------------------- */
/* 断言小工具                                                                  */
/* -------------------------------------------------------------------------- */

static size_t s_passed = 0U;
static size_t s_failed = 0U;

static void check(bool condition, const char *what)
{
    if (condition)
    {
        ++s_passed;
        printf("[PASS] %s\n", what);
    }
    else
    {
        ++s_failed;
        printf("[FAIL] %s\n", what);
    }
}

static bool bytes_equal(const uint8_t *left, const uint8_t *right,
                        size_t length)
{
    for (size_t i = 0U; i < length; ++i)
    {
        if (left[i] != right[i])
        {
            return false;
        }
    }
    return true;
}

/** @brief 判断一条回复是不是指定命令、指定结果码的 ACK。 */
static bool ack_is(const mcu_frame_t *frame, uint8_t acked_cmd, uint8_t result)
{
    return (frame->cmd == MCU_PROTOCOL_CMD_ACK) &&
           (frame->payload_length == MCU_PROTOCOL_ACK_PAYLOAD_SIZE) &&
           (frame->payload[0] == acked_cmd) && (frame->payload[1] == result);
}

/* -------------------------------------------------------------------------- */
/* 假硬件                                                                      */
/* -------------------------------------------------------------------------- */

typedef struct
{
    uint32_t read_status_calls;
    uint32_t apply_light_calls;
    uint32_t apply_motion_calls;
    uint32_t safe_stop_calls;
    uint8_t last_light_flags;
    uint8_t last_brightness;
    uint8_t last_motion;
    uint8_t last_speed;
    uint8_t light_enabled;
    uint8_t brightness;
    uint8_t motion;
    uint8_t speed;
    uint8_t fault_flags;
    bool motion_fails;
    uint32_t arm_move_calls;
    uint32_t arm_home_calls;
    uint32_t arm_status_calls;
    uint8_t last_joint;
    int32_t last_target;
    int32_t last_arm_speed;
    uint8_t last_query;
    uint8_t arm_result;
    uint32_t output_calls;
    uint32_t output_status_calls;
    uint8_t last_output_cmd;
    uint8_t last_output_id;
    bool last_output_on;
    uint8_t last_output_level;
    uint8_t output_result;
} fake_hw_t;

static fake_hw_t s_fake;

static void fake_read_status(mcu_status_t *status)
{
    ++s_fake.read_status_calls;
    status->light_enabled = s_fake.light_enabled;
    status->brightness = s_fake.brightness;
    status->motion = s_fake.motion;
    status->target_motion = s_fake.motion;
    status->speed = s_fake.speed;
    status->target_speed = s_fake.speed;
    status->fault_flags = s_fake.fault_flags;
}

static bool fake_apply_motion(uint8_t motion, uint8_t speed)
{
    ++s_fake.apply_motion_calls;
    s_fake.last_motion = motion;
    s_fake.last_speed = speed;
    if (s_fake.motion_fails)
    {
        return false;
    }
    s_fake.motion = motion;
    s_fake.speed = speed;
    return true;
}

static bool fake_apply_light(uint8_t light_flags, uint8_t brightness)
{
    ++s_fake.apply_light_calls;
    s_fake.last_light_flags = light_flags;
    s_fake.last_brightness = brightness;
    s_fake.light_enabled = (uint8_t)(light_flags & 0x01U);
    s_fake.brightness = brightness;
    return true;
}

static void fake_safe_stop(void)
{
    ++s_fake.safe_stop_calls;
    s_fake.motion = MCU_PROTOCOL_MOTION_STOP;
    s_fake.speed = 0U;
}

static uint8_t fake_arm_move(uint8_t joint_id, int32_t target, int32_t speed)
{
    ++s_fake.arm_move_calls;
    s_fake.last_joint = joint_id;
    s_fake.last_target = target;
    s_fake.last_arm_speed = speed;
    return s_fake.arm_result;
}

static uint8_t fake_arm_home(uint8_t joint_id)
{
    ++s_fake.arm_home_calls;
    s_fake.last_joint = joint_id;
    return s_fake.arm_result;
}

static uint8_t fake_arm_status(uint8_t command, uint8_t joint_id,
                               mcu_extended_status_t *status)
{
    ++s_fake.arm_status_calls;
    s_fake.last_query = command;
    s_fake.last_joint = joint_id;
    status->faults = 0x10U;
    status->actual = -45000;
    status->target = 30000;
    status->actual_speed = -1234;
    status->target_speed = 20000;
    return s_fake.arm_result;
}

static uint8_t fake_output(uint8_t cmd, uint8_t id, bool is_on, uint8_t level)
{
    ++s_fake.output_calls;
    s_fake.last_output_cmd = cmd;
    s_fake.last_output_id = id;
    s_fake.last_output_on = is_on;
    s_fake.last_output_level = level;
    return s_fake.output_result;
}

static uint8_t fake_light_zone(uint8_t zone_id, bool is_on, uint8_t brightness)
{
    return fake_output(MCU_PROTOCOL_CMD_SET_LIGHT_ZONE, zone_id, is_on,
                       brightness);
}

static uint8_t fake_buzzer(uint8_t pattern_id, uint8_t volume)
{
    return fake_output(MCU_PROTOCOL_CMD_SET_BUZZER, pattern_id, false, volume);
}

static uint8_t fake_indicator(uint8_t indicator_id, bool is_on)
{
    return fake_output(MCU_PROTOCOL_CMD_SET_INDICATOR, indicator_id, is_on,
                       0U);
}

static uint8_t fake_output_status(uint8_t command, uint8_t selector,
                                  mcu_extended_status_t *status)
{
    ++s_fake.output_status_calls;
    s_fake.last_query = command;
    s_fake.last_output_id = selector;
    status->actual = 1;
    status->target = 1;
    status->actual_speed = 60;
    status->target_speed = 60;
    return s_fake.output_result;
}

/* 不带扩展回调：扩展命令按未知命令处理。 */
static const mcu_command_hw_t k_fake_hw = {
    .read_status = fake_read_status,
    .apply_light = fake_apply_light,
    .apply_motion = fake_apply_motion,
    .safe_stop = fake_safe_stop,
};

static const mcu_command_hw_t k_arm_hw = {
    .read_status = fake_read_status,
    .apply_light = fake_apply_light,
    .apply_motion = fake_apply_motion,
    .safe_stop = fake_safe_stop,
    .arm_move = fake_arm_move,
    .arm_home = fake_arm_home,
    .arm_status = fake_arm_status,
};

/* 只有输出类扩展回调，没有关节回调。 */
static const mcu_command_hw_t k_output_hw = {
    .read_status = fake_read_status,
    .apply_light = fake_apply_light,
    .apply_motion = fake_apply_motion,
    .safe_stop = fake_safe_stop,
    .light_zone = fake_light_zone,
    .buzzer = fake_buzzer,
    .indicator = fake_indicator,
    .output_status = fake_output_status,
};

static void fake_reset(void)
{
    memset(&s_fake, 0, sizeof(s_fake));
    mcu_protocol_reset();
}

/* -------------------------------------------------------------------------- */
/* 小工具：拼一条请求                                                          */
/* -------------------------------------------------------------------------- */

static mcu_frame_t make_request(uint8_t seq, uint8_t cmd,
                                const uint8_t *payload, uint8_t payload_length,
                                uint8_t flags)
{
    mcu_frame_t frame = {0};

    frame.version = MCU_PROTOCOL_VERSION;
    frame.flags = flags;
    frame.seq = seq;
    frame.cmd = cmd;
    frame.payload_length = payload_length;
    if ((payload != NULL) && (payload_length > 0U))
    {
        memcpy(frame.payload, payload, payload_length);
    }
    return frame;
}

/* 一条 CRC 被改坏的帧，用来给解析器制造协议错误 */
static const uint8_t k_bad_crc_frame[] = {0xA5, 0x5A, 0x02, 0x00, 0x04,
                                          0x20, 0x00, 0x00, 0x01, 0x02};

/* -------------------------------------------------------------------------- */
/* 用例                                                                        */
/* -------------------------------------------------------------------------- */
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
