xiaomiao321/taideng/(commit log)

2026-09-22 加丝印前的备份
2026-09-28 整理 MCU 软硬件目录结构
    [BOM.xlsx, ProPrj_AI台灯_模块版_2026-09-22.epro]
2026-09-28 更新.gitignore
2026-09-29 docs(mcu): 添加固件编码规范
2026-09-29 feat(bringup): 添加LED与串口日志自检
    - 将FreeRTOS工程迁移为test_bringup
    - 新增LED BSP和USART3日志接口
    - 添加启动日志、LED轮询和错误指示
    - 更新CMake配置以接入BSP
    验证：Debug编译与链接通过；硬件验证待焊接后进行
2026-09-29 chore(mcu): 移除旧测试工程
    由test_bringup统一承载当前MCU上电自检与模块验证。
2026-09-29 chore(mcu)：备份原始freertos工程
2026-10-07 fix: 修复 LED 不亮问题并配置 VS Code 调试
2026-10-08 feat(mcu): 添加可变频率蜂鸣器驱动
2026-10-08 feat(mcu): 添加分级格式化日志与编译期裁剪
2026-10-08 feat(mcu): 加入HOME按键、Linux电源控制驱动
2026-10-09 feat(mcu): 加入Linux通信测试、单路ADC读取、测试main函数备份
2026-10-09 feat(mcu): 加入多通道ADC采集和电机驱动参考
2026-10-09 fix(hardware): 修复POT6 ADC读数异常
2026-10-09 refactor(bsp): 统一 BSP 状态码与初始化契约，HAL 回调集中到集成层
    - 新增 bsp_common.h/.c：统一 bsp_status_t 与 bsp_status_str()，各模块不再各写一套状态枚举
    - 所有 bsp_*_init() 统一返回 bsp_status_t；能取到 HAL 句柄的模块在 init 校验句柄/配置
    - bsp_adc_init 校验 ADC 配置并自动区分单路轮询/六路 DMA 两种模式，读接口在配置不匹配时返回 BSP_ERR_CONFIG
    - HAL 弱回调集中到 Core/Src/hal_callback_dispatch.c，驱动只提供 _from_isr()，不再定义 HAL 回调
    - 移除 bsp_uart_loopback 模块：它与 bsp_linux_uart 抢 HAL_UART_ErrorCallback，无法同时编译
    - 编码规范新增 8.4「HAL 回调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
2026-10-09 feat(bsp): 新增 handle 化的灯板与电机驱动及板级映射
    驱动层（不含任何 CubeMX 全局句柄，可整份复用、支持多实例）：
    - bsp_light_pwm：单路 PWM 通用驱动，绑定 (htim, channel)
    - bsp_motor_hbridge：双输入 H 桥通用驱动，绑定 (htim, FI 通道, BI 通道)
    板级映射层（换板只改这里的映射表）：
    - bsp_light：七路灯 → TIM1/TIM3 通道
    - bsp_motor：八路电机 → TIM2/4/8/9/12 通道，M6 的 FI/BI 反序在表中标注
    - init 校验句柄与 ARR，不满足返回 BSP_ERR_CONFIG；H 桥 init 先两路清零再启动，上电保持停止
    - 占空比换算沿用 CCR=(ARR+1)*duty/1000；H 桥用有符号占空比，换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
2026-10-09 test(mcu): 用灯板 bring-up 替换 ADC 测试，并加入 GPIO 焊接自检开关
    - 移除 ADC 单次/六路测试相关的初始化与循环，main 改为灯板 bring-up
    - 逐路输出 50% 方波（0%/100% 是直流，量不到频率与占空比），后接三档占空比扫描
    - 保持时间 10s、间隔 2s，便于用示波器把探头移到目标引脚；时间由 LAMP_TEST_* 宏控制
    - 测试范围由 LAMP_TEST_FIRST_ID/LAST_ID 决定，当前只测上灯板 UP1~UP4
    - 新增 LAMP_TEST_GPIO_PROBE 开关：置 1 时把 UP1(PE9)/UP2(PE11) 改为普通 GPIO 同步输出
    1Hz 方波，用于区分断点在 MCU 引脚还是走线/排阻/连接器；默认 0
    - 顺带删除 main 中残留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
2026-10-09 docs(hardware): 记录首板两处虚焊与 PWM/ADC 排查方法
    - H-01 PC5/POT6、H-02 PE11/UP2 两处虚焊的现象、根因与处理
    - 记录上/下灯板信号链路（U7 → RN1/RN2 100Ω 排阻 → CN7 / U29）及对应 MCU 脚号，
    含 UP1/UP2 分别为 40/42 脚、中间夹未使用的 PE10 这个易错点
    - 记录"PWM 无输出"与"ADC 读数异常"的排查顺序，含 GPIO 1Hz 自检的判读表
    - 给出第二批板的目视/AOI 复检建议与固定测量顺序
    依据：MCU/hardware/网表.tel 与实板测量。
2026-10-09 test(mcu): 灯板 bring-up 覆盖上、下两块灯板全部七路
    - LAMP_TEST_LAST_ID 由 BSP_LIGHT_UP4 改为 BSP_LIGHT_DOWN3，
    一轮依次覆盖 UP1~UP4 与 DOWN1~DOWN3，再统一做三档占空比扫描
    - 注释补充两块板走不同定时器与链路：
    上灯板 TIM1，U7 -> RN1 -> CN7；下灯板 TIM3，U7 -> RN2 -> U29
    验证：上灯板四路、下灯板三路 PWM 输出均已在实板确认
    （UP2 曾因虚焊无输出，见 MCU/hardware/已知硬件问题.md H-02）。
2026-10-09 test(mcu): 加入电机 PWM 扫描，并把测试选择与 GPIO 自检做成通用开关
    - 新增 BRINGUP_TEST 选择本次跑灯板(1)还是电机(2)测试，一次只编译一个
    - 新增电机 PWM 扫描：默认 MOTOR_TEST_ALL_AT_ONCE=1，范围内全部电机先一起
    FI 50%、再一起 BI 50%，中间回滑行；所有被测引脚同时有波形，便于逐脚确认。
    置 0 时退回"一次只动一台的一个方向"，用于某几路无波形时定位
    - 电机扫描走 bsp_motor_set_duty/coast，顺带验证方向逻辑与 M6 的 FI/BI 反序
    - 灯板测试在电机模式下会把七路显式输出 0%，避免其输入悬空
    - GPIO 自检由 LAMP_TEST_GPIO_PROBE 改名为 BRINGU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
2026-10-09 docs(hardware): 补充电机 PWM 链路表与首板验证状态
    - 新增 3.2 电机 PWM 链路：8 台电机的 MCU 脚号、定时器通道、串联 100Ω 电阻、
    RZ7899 编号与电机接口，并标注连接器编号与电机编号不对应、M6 的 FI/BI 反序
    - 自检开关说明由 LAMP_TEST_GPIO_PROBE 更新为 BRINGUP_GPIO_PROBE，并说明可改引脚
    - 新增第 5 节"已确认正常的项目"：登记首板已实板验证的功能，并明确电机只验证了
    PWM 信号通路、尚未带电机做转动与方向验证
2026-10-09 test(mcu): 引入 bring-up 测试运行器，测试项集中到测试表
    - 新增 Tests/：bringup_test.h 框架接口、bringup_test.c 运行器、bringup_cases.c 测试表
    - 结果分类 PASS / FAIL:NO_RESPONSE / FAIL:CONFIG / FAIL:COMM / FAIL:DATA / SKIP；
    逐项打印 "[i/n] NAME -> RESULT"，一项失败不阻断后续项，最后打印汇总
    - 需要人工判读的项目用 bringup_confirm() 等操作员按 HOME 确认，超时记 FAIL:NO_RESPONSE
    - 测试表当前 29 项：LOG、LED、KEY、BUZZER、PWR、ADC6、
    灯板 7 路（UP1~UP4/DOWN1~DOWN3）、电机 8 台 x 2 方向
    - main.c 精简为初始化 + bringup_run_all()；删除 BRINGUP_TEST 与 LAMP_TEST_*/MOTOR_TEST_* 等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
2026-10-09 fix(mcu): 日志正文改为纯 ASCII，避免串口调试助手异常
    - bringup_cases.c 中 LED/KEY/BUZZER/PWR/LAMP/MOTOR 的提示全部改为英文
    - 编码规范新增 10.0：日志正文与 tag 只用 ASCII，中文说明放注释
    原因：串口调试助手对多字节字符处理不一致，中文日志容易显示错乱或导致工具异常。
    验证：Debug/Release 编译链接通过，无警告；全文检索已无输出到串口的非 ASCII 字符串。
2026-10-09 fix(mcu): Linux 电源脉冲测试改为周期性重发，示波器来得及测
    - 原来只发一次 200ms 脉冲，来不及触发；现在每 1s 重发一次，持续到操作员按 HOME
    确认或超时。参数集中在 PWR_TEST_PULSE_MS / PWR_TEST_PERIOD_MS
    - 新增 bringup_confirm_arm() / bringup_confirmed()：非阻塞确认查询，
    供测试自己驱动周期性输出时使用；bringup_confirm() 改为基于它们实现
    - 新增 bsp_linux_power_release()：立即释放电源键。测试结束前调用，
    避免超时或确认时正好卡在脉冲中间，把电源键一直按住
    验证：Debug/Release 编译链接通过，无警告。
    注意：重复发脉冲等于重复按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
2026-10-09 feat(Linux): 加入Linux端资料
2026-10-10 feat(mcu): 接入 Android 串口通信协议，灯板可控
    - 新增 mcu_protocol：CRC16/MODBUS 校验、帧解析（拆包/粘包/噪声/坏 CRC 重同步）、
    ACK 与 STATUS 组包
    - 新增 mcu_command：命令分派、状态回读、(SEQ,CMD) 去重、5 秒失联安全停止；
    只有会改变硬件状态的命令去重，查询类命令每次返回当前状态
    - 新增 App/app_main：USART1 收发接线与硬件回调，SET_LIGHT 控制七路灯板；
    LED_COMM 每收到一条合法报文闪 50ms（非阻塞脉冲）
    - 新增 HostTest：PC 端自测，协议 45 条 + 命令 62 条断言，命令层用假硬件测
    - main.c 增加 APP_MODE_PROTOCOL 开关，bring-up 测试表与 GPI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
2026-10-11 feat(debug): 添加串口电机控制上位机与电位器监测
2026-10-16 feat(debug): 完善全板终端调试与关节标定闭环控制
2026-10-16 feat(debug): 支持多路电机灯光控制与 Linux 串口调试
2026-10-17 fix(mcu): 异常急停、看门狗、串口容错与协议去重
    - 异常处理（HardFault 等）和 Error_Handler 先清零电机 PWM，再进死循环
    - 新增 bsp_watchdog（寄存器级 IWDG，1s），DEBUG/ANDROID 模式启用
    - Android 模式 USART1 收发错误改为计数、重试，不再进 Error_Handler；接收改为双缓冲
    - mcu_protocol_feed 队列满时停止并返回已消费字节数，不再丢弃合法帧
    - 命令去重改为比较整条请求（含 PAYLOAD），避免主机重启后新命令被误判为重发
    - HostTest 新增队列满与同 SEQ 不同 PAYLOAD 两个用例
2026-10-17 style(mcu): 新增 .clang-format 并统一格式化手写代码
    - .clang-format 按 BSP 现有风格（Allman、4 空格、80 列、if 必加大括号）
    - .clang-format-ignore 排除 CubeMX 生成代码、Drivers、FreeRTOS、Ref 与 main_snapshots
    - 格式化 App、BSP、Tests、HostTest 和 hal_callback_dispatch.c，只改空白和大括号，
    另有过长字符串字面量拆成相邻字面量；固件二进制与格式化前逐字节一致
2026-10-17 refactor(mcu): 协议层与命令层移到 Protocol/ 目录
    mcu_protocol、mcu_command 与硬件无关，不属于 BSP；CMakeLists 与
    HostTest/run.ps1 同步更新路径。motor_limits.h 是 bsp_motor 使用的
    板级占空比策略，继续留在 BSP。固件二进制与移动前逐字节一致。
2026-10-17 fix(mcu): 串口归属收回 BSP，修复剩余审查问题
    - 新增 bsp_uart_stream（单字节中断加环形缓冲）与 bsp_debug_uart（USART3）；
    bsp_linux_uart 增加字节流透传模式。debug_console 不再直接操作 huart1/huart3，
    hal_callback_dispatch.c 只转发给 BSP，不再依赖 App 层
    - 调试终端发送失败只计数，不再当作接收故障急停锁定
    - bsp_linux_uart 清理失败后在下次启动接收时重试，不再永久失效
    - 电机统一用 0 起下标：motor_duty_valid、debug_hw_t.run 改为下标，
    M1～M8 只在文本协议处换算；新增 MOTOR_COUNT 并与 BSP_MOTOR_COUNT 静态断言
    - debug_console/debug_control/debug_board/joint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
2026-10-17 feat(mcu): 关节标定保存到片内 Flash，上电自动恢复
    - 新增 flash_journal：两块 Flash 区轮换的追加式记录存储，记录带序号与
    CRC32，魔数最后写入，写到一半掉电自动退回上一条；不依赖 HAL，附 PC 端
    模拟 Flash 测试（掉电、擦除/编程失败、残留数据）
    - 新增 bsp_param_flash：使用扇区 10、11，开机预擦备用扇区，平时保存只编程
    一条记录；擦除时临时放宽看门狗；固件映像若延伸到参数扇区则拒绝擦写
    - 链接脚本 FLASH 长度改为 768K，为参数扇区让出空间
    - bsp_watchdog 按超时自动选择预分频（最长约 32 秒），新增运行中修改超时接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
2026-10-18 feat(joint): 理论标定（电位器参数加单个参考点）与独立的允许运动范围
    固件：
    - joint_cal_t 新增 limit_min/limit_max，定位目标与越限保护改用允许范围，
    不再与标定点绑定；范围须宽于两倍容差且落在电位器可测区间内
    - 新增 joint_cal_from_nominal：按 3V3-1k-[电位器]-1k-GND 分压公式与 270°
    行程，由阻值（默认 45kΩ）、读数方向和一个参考点算出两点标定，参考点与
    范围超出电气行程即拒绝；新增 joint_set_limits
    - 调试命令新增 JNOM（理论标定）、JLIM（只改范围）；CAL 兼容，范围默认 A～B；
    JCAL 后追加 JLIM 回报；INFO 增加 CAPS JOINT_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
2026-10-21 docs: 添加 README 与板子渲染图
2026-10-21 docs: 增加四层布线图
2026-10-24 feat(motor): 电机调试支持 ADC 过采样、刹车 PWM、比例控制与数据记录
    - 电位器每 10ms 连续扫描 16 次，去掉最大最小各四分之一后取平均，并记录极差
    - H 桥新增刹车（慢衰减）PWM，电机 PWM 频率可在 1～20kHz 间切换（MPWM）
    - 关节新增比例式控制，到位和过冲换向时先短路制动再滑行；原开关式保留，
    控制参数用 JTUNE 设置，只存 RAM
    - JTRACE 打开后每次采样上报一行 JT，供上位机记录阶跃响应
    - 电机最小允许占空比由 50% 放宽到 10%，便于扫低占空比
    - HostTest 增加比例控制、制动、滤波和新命令解析的用例
    上位机：
    - 关节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
2026-10-24 feat(motor): 默认 5kHz 刹车 PWM 与比例控制，控制参数存 Flash，加占空比上限
    依据 2026-10-24 M1 单电机实测：20kHz 滑行 40% 转不动，5kHz 刹车 20%～30%
    即可转动；比例式加制动 3°～30° 定位 1～1.5 秒到位，过冲不超过 2.4°。
    - 电机 PWM 上电默认 5kHz 刹车（BSP_MOTOR_PWM_DEFAULT_*）
    - 关节默认比例式：每度 1%、起转 30%、制动 50ms；JTUNE 的参数随标定保存
    - 标定数据升级为版本 3（加控制参数），上电时自动迁移版本 2 的旧标定
    - 新增 bsp_param_flash_peek，迁移前只读旧记录，避免被备用扇区擦除
    - 过采样之后再做时间上的三点中值，去掉单次 2～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
2026-10-24 refactor(mcu): 可调参数集中到 Config/app_config.h；上位机关节页给曲线让出高度
    - 新增 Config/app_config.h，集中运行模式、看门狗、占空比范围、默认 PWM、
    电位器采样、关节闭环参数和通信安全时限；协议格式、Flash 地址、缓冲区
    大小等不可随意改动的常量仍留在原处
    - 关节闭环和采样相关的宏加上 JOINT_、POT_ 等前缀，避免放进公共头文件后重名
    - CMake 与 HostTest 增加 Config 头文件目录
    - 上位机关节页：两点标定、理论标定、电机调试改为子标签页，状态并入定位行，
    曲线优先分配高度
2026-10-24 doc: 增加一些说明文档
2026-10-24 doc: 增加整机框图
2026-10-24 feat(motor): 关节支持多路同时运动
    电机带自锁，各关节需要同时定位，原先同一时刻只允许一个关节运动。现在每个关节有独立的运动状态，joint_tick 逐个处理，M1 到 M6 可以同时定位，互不阻塞。
    关节运动中再次下发 JMOVE 会直接换成新目标，旧的那次回 JRESULT SUPERSEDED，方向和刹车状态沿用。BUSY 只针对该关节本身，标定、设限位和调参不受其他关节运动影响。单个关节出现电位器失效等故障只停该关节，STOP 和 joint_cancel 停止全部关节。手动 RUN 或 MSET 进行中时 JMOVE 仍会先停车，否则不再打断其他关节。
    上位机解析 SUPERSEDED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
2026-10-24 feat(motor): 上位机关节页支持勾选多个关节同时定位
    关节页的角度定位改成 M1 到 M6 一张表，每个关节一列，可以勾选、填目标角度，并显示实测角度和状态。点"勾选的关节同时定位"时先逐个检查状态、标定和允许范围，全部通过才一起下发 JMOVE，有一个不合格就都不发并列出原因。原来单独一行的 ADC 和角度挪到关节下拉框旁边，曲线高度基本不变。切换下拉框不再停车，只换曲线和数据记录的关节。同时下发多个时 JMOVE 的 ACK 不再覆盖提示栏，别的关节的拒绝原因不会被盖掉。
    固件原来每个周期只上报焦点关节的 JSTATE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
2026-10-24 feat(motor): 角度闭环可在电机调试页设置最高占空比
    比例式原本就用标定里的占空比 cal.duty 作为输出上限，开关式也用它驱动，但要改它只能重新下发整套标定。现在 JTUNE 增加可选的第 5 个参数作为最高占空比，固件写入该关节的 cal.duty 并随标定存进 Flash，Flash 格式不变。最高占空比要求关节已标定、非零且不超过全局上限，控制参数和最高占空比任一项被拒绝时两项都不改。JTUNE 上报末尾增加当前最高占空比，未标定时报 0。
    上位机电机调试页增加"最高 %"输入框，切换关节后用 MCU 回报的值自动填入，留空则不改。两点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
2026-10-29 feat(mcu): 关节闭环拆成公共模块，安卓模式实现 extension-v2 关节命令
    电位器采样滤波、关节闭环推进和标定的 Flash 存取原来写在 debug_console.c 里，只有调试模式能用。现在拆到新的 joint_service 模块，调试模式和安卓模式都调用它，调试模式的串口命令和上报格式不变。
    关节模块增加故障锁存和转速估计。运动故障按 SDK 0.5.0 约定的位定义锁存，停滞 01、超时 02、方向错误 04、越限 08、电位器 10、驱动 20。joint_clear_faults 只清除原因已消失的锁存，电位器仍无效、角度仍越限或再次停机仍失败时保留对应位。转速取最近 21 次采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
2026-10-29 test(mcu): 增加模拟安卓主机的串口测试脚本
    Tools/mcu_link/link_test.py 让电脑经 USB 转 TTL 直连 MCU 的 USART1，代替 RK3566 发 0x02 协议帧，用来在没有安卓端配合时上板测试安卓模式固件。basic 测 PING、状态、灯光、STOP 和几条应被拒绝的命令；status 列出基本状态和 M1 到 M6 的关节回读；move 下发 SET_ARM_POSITION 后每 0.1 秒查询一次，按 SDK 的规则判断是否到位，即目标回读不变、误差不超过 2°、两个速度为 0、关节和全局故障为 0；watch 静止观察并统计转速误报；silence 停止发帧以验证 5 秒失联停车。
    脚本已用安卓端随包的 MCU 模拟器在进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
2026-10-29 feat(mcu): 安卓模式接入底盘 SET_MOTION
    SET_MOTION 原来只接受 STOP，其余动作一律回未知命令。现在由新的 chassis 模块把前进、后退、左转、右转映射到左 M7、右 M8 两条履带，两路都是正转前进，左右转为两路反向的原地转。没有编码器，速度百分比直接当占空比百分比，低于起转下限抬到下限，高于履带上限截断；状态里的实际和目标动作、速度就是最近一次成功应用的值，SDK 按这个判定到位。
    驱动调用失败时两路都停下并锁存底盘故障 0x40；STOP 再停一次，两路都成功才清除。命令层对非 STOP 的底盘动作也做故障门控，与关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
2026-10-30 fix(motor_debug): 导出读 MCU 标定，连上后读回全部关节
    原来「保存标定文件」导出的是电脑上的两点标定表单：理论标定的关节没有两点读数会被跳过，上位机重启后表单清空，于是 MCU 里明明有标定也报「尚无完整标定」。现在改为「导出 MCU 标定」，导出 MCU 回读的 JCAL 加 JLIM，与标定方式和表单内容无关；状态显示已标定但参数还没读回的关节会被点名，并重新查询。
    MCU 上电时主动上报的 JCAL 在打开串口之前就发完了，连上后又只查询当前关节，看起来像标定掉电丢失。现在收到 CAPS 后逐个 JGET 六个关节，当前关节放在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
2026-11-01 feat(mcu): HOME_ARM 原点定为 135°，测试脚本加 home 动作
    六个关节的 HOME 原点统一定为电位器行程中点 135°。这要求关节按电位器转角 0～270° 标定；如果某个关节的允许范围不含 135°，HOME_ARM 会经 joint_move 的范围检查回 INVALID_VALUE，不会运动，所以按机构角度标定的关节不会被错误地驱动。
    link_test.py 增加 home 动作：发送 HOME_ARM 后从扩展状态回读固件配置的原点，再沿用 move 的到位判断观察 10 秒。move 与 home 的观察循环抽成 observe()。
2026-11-02 refactor(mcu): 删除未使用的 FreeRTOS、BOARD 模式和无人调用的 BSP 接口
    固件一直是裸机主循环，没有任何地方创建任务或使用队列，FreeRTOS 内核源码和 FreeRTOSConfig.h 只是被编译进来，链接时又全部被丢掉，所以整个删除。HAL 时基用的是 TIM6，SysTick 从未开启，删掉 port.c 提供的 SVC、PendSV、SysTick 处理函数后这三个中断回落到启动文件的默认处理，不会触发。
    APP_MODE_BOARD 和 Tests/ 下的 bring-up 运行器与调试模式里的 debug_board 全板测试重复，参数也停留在早期的 80% 点动，一并删除；APP_MODE_ANDROID 保持取值 2，原有的 -DAPP_MODE=2 构建方式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
2026-11-02 refactor(debug): 删除 USART1 透传和单路 RUN 命令
    调试终端的 LMODE、LTX、LRX、LERR 透传只是为了只接一根 USART3 线也能看 Linux 串口，实际都是另接 USB 转串口，所以连同 bsp_linux_uart 的字节流接收模式一起删除；USART1 只剩 Android 协议用的变长接收，1KB 接收环也省掉了。LSTATE 去掉末尾的转发开关字段，INFO 不再报 CAPS LINUX。上位机的 Linux 串口页只保留独立 COM 口。
    单路 RUN 已被多路 MSET 取代，上位机界面早就不发它，只剩终端的 motor 命令在用。删掉后 debug_control 不再维护单路和多路两套互斥的电机状态，EVENT DONE 也随之去掉；终端的 m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
2026-11-02 docs(mcu): 增加固件 README
    固件要交给别人接着调电机，补一份上手说明：构建和烧录、两种模式、目录结构和主循环、调电机的推荐顺序、安全规则，附录是调试命令速查和相关文档的链接。
2026-11-02 chore(mcu): 删除旧工程，固件移到 MCU/software 根目录
    FreeRTOS_Proj - 副本 是早期 FreeRTOS 工程的备份，test_UART_Wire 是 STM32F103 上的串口实验，都已不再使用，历史里仍可找回。现在 MCU/software 下只剩一个固件，不再套一层 test_bringup 目录，直接放到 MCU/software。CMake 工程名、ELF 文件名和 CubeMX 工程名保持 test_bringup 不变，仓库里引用旧路径的 README、上位机单测、编码规范和 VS Code 设置一并更新。
2026-11-02 docs(mcu): 增加烧录说明
    在原来给上板测试写的烧录说明基础上改写：用 STM32CubeProgrammer 烧 Release 里的 hex，提醒不要整片擦除以免清掉扇区 10 和 11 的关节标定，烧完按两种模式各自的启动日志确认，附 OpenOCD 命令行烧法。README 里加上指向它的链接。
2026-11-02 feat(protocol): 安卓协议实现分区灯、蜂鸣器和指示灯扩展命令
    按 SDK 0.5.0 的《MCU扩展协议与安全控制》实现 0x35 SET_LIGHT_ZONE、0x36 SET_BUZZER 和 0x37 SET_INDICATOR，GET_EXTENDED_STATUS 也能查询这三类的状态。命令层只校验开关、亮度、音量和保留字节，分区、图案和指示灯 ID 交给新增的可选回调判断，不支持时回 INVALID_VALUE；回调为空时这三条命令仍按未知命令处理。这三类输出不受故障门控，有故障时照常可用。
    分区 ID 1 到 4 对应上灯板 UP1 到 UP4，5 到 7 对应下灯板 DOWN1 到 DOWN3，每次只改一路。SET_LIGHT 仍把七路设成同一个开关和亮度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
2026-11-02 docs(mcu): 按当前固件更新控制板能力说明
    原文写于 10-22，说安卓协议只有 STOP、关节和扩展命令都未实现，已经和固件对不上。现在按提交 032cf91 重写能力对照：底盘全部动作、关节 0x31 到 0x34、分区灯、蜂鸣器和指示灯都已开放，只剩 0x30 和 0x38。
    新增安卓端能力声明一节，列出 extension-v2 下各字段该填的值和哪些要实测。原来的待商定问题改成现状表，到位容差、HOME 位置、多关节并发和故障位都已落实，关节范围和最大速度仍待实测。
2026-11-02 feat(joint): 增加轨迹式关节控制，支持单向逼近消除背隙
    比例式和开关式在启动、换向和到位时占空比都会突变，到位时还会短路制动，相当于速度和加速度都有突变，电机和减速箱受刚性和柔性冲击。新增 JTUNE 模式 2 轨迹式：按五次多项式规划参考轨迹，起点和终点速度、加速度为 0，全程位置、速度、加速度连续；运动中换目标时从当前参考状态接着规划，衔接处同样连续。轨迹计算放在独立的 joint_traj 模块，用单精度浮点。
    输出为速度前馈、摩擦前馈和对参考位置的 PI 反馈之和。摩擦前馈按参考速度而不是测量速度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
2026-11-02 feat(joint): 比例式和开关式也支持单向逼近，逼近参数可用 JDIR 设置并存 Flash
    M1 实测发现回程误差：0° 竖直、90° 水平，从 0° 往 90° 定位各角度都准，往回转则都不准，但先往回越过目标再转回来就准。说明电位器读数和关节实际位置之间有间隙，最后一段的方向决定关节停在间隙哪一侧，而标定是按其中一个方向做的。单向逼近原来只在试验中的轨迹式里有，大家实际用的是比例式，所以把它做成三种控制方式通用。
    比例式和开关式需要反向到达时，先以目标另一侧超调量处的中间点为去向，到了中间点一个容差以内或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
