xiaomiao321/taideng/(notices)

Notices in the files:
MCU/software/Core/Src/main.c:
Copyright (c) 2026 STMicroelectronics.
All rights reserved.
This software is licensed under terms that can be found in the LICENSE file
